ISIP-CART/AutoFollowShoppingCart/firmware/README.md

# 下位机固件目录说明

## 当前推荐烧录

实车 BLE 手动控制与自动跟随统一使用：

`firmware/esp32_at8236_velocity_ble/esp32_at8236_velocity_ble.ino`

这是当前唯一推荐烧录的实车运行固件。它使用 AT8236 `$spd` 的 mm/s 速度闭环，
读取 `$MSPD` 做方向、超速、遥测和制动检查，并兼容 Android 现有
`f / r / h / c / !S` 协议。动态缓弯继续使用 `c<left>,<right>`，不新增协议。
当前 `c14` 仍对应约 240 mm/s；`c15..21` 为后续“速度 + 方向”上位机提供扩展
速度区间，`c21` 的直线/同向差速硬上限为 600 mm/s。反向对转单独限制在
240 mm/s。当前版本还接入 URM09-I²C 与左右 VL53L1X，兼容旧 V1 `s` 最小距离上报，
并按 R3-V1 提供固定左/中/右的 `!R3D` 独立遥测。传感器当前仅采样、回传和诊断，
不参与运动许可或停车。新增高速区间与传感器日志
必须按正式固件 README 和传感器集成测试方案分阶段验证；当前固件不具备防撞保证。

针对实车曾出现的 `DRIVER_ERROR` 永久锁死，本版将短暂 `$MSPD` 中断和制动超时改为
“持续零速、等待新鲜遥测确认四轮静止后恢复到 `READY_STOP`”；不会重放故障前命令。
急停、反馈方向反号、异常超速和启动阶段驱动未就绪仍保持硬锁存。实车 `c14` 曾采集到
约 419--590 mm/s 的 `$MSPD`，且 `c14` 转 `c9` 时内轮曾在新目标 154 mm/s 下短时回报
533 mm/s。因此 1.5 倍目标值只作为告警，稳定后的动态硬阈值提高为 4.0 倍；转弯降速
期间以实际斜坡命令为基准并等待 500 ms 稳定。750 mm/s 绝对硬上限始终有效。`!Q` 会
保留最近一次故障原因、目标/斜坡命令与测速快照，烧录后应看到
`FAULT_RECOVERY,version=3`。

## 其他目录的定位

| 目录 | 定位 | 是否用于当前实车运行 |
|---|---|---|
| `esp32_at8236_velocity_ble/` | 当前速度闭环 BLE 正式固件 | 是，唯一推荐 |
| `esp32_at8236_velocity_validation/` | USB 速度、转向、横移和弧线受控验证 | 否，仅专项验证 |
| `esp32_at8236_openbot_ble/` | 早期低速 BLE 联调固件，包含旧 trim / 起步辅助方案 | 否，历史参考 |
| `esp32_at8236_calibration/` | 四轮/单轮悬空标定 | 否，仅标定 |
| `esp32_at8236_m1_test/` | M1 早期专项测试 | 否，历史测试 |

不要把旧版 `esp32_at8236_openbot_ble` 中的起步 kick、轮间 trim 或
`STARTUP_ASSIST_CURVE` 直接复制到速度闭环固件。只有新的 `$spd/$MSPD` 实测证明
某一速度区间无法可靠起步时，才针对速度闭环重新设计和验证补偿。
