ISIP-CART/AutoFollowShoppingCart/firmware/esp32_at8236_openbot_ble/README.md

# ESP32 + AT8236 OpenBot BLE 安全遥控固件

> **旧版联调固件，请勿作为当前实车推荐烧录版本。** 当前实车 BLE 手动控制与
> 自动跟随统一使用
> `firmware/esp32_at8236_velocity_ble/esp32_at8236_velocity_ble.ino`。
> 本目录保留用于追溯早期低速 trim、起步辅助和换向联调，不应把其中的
> `STARTUP_ASSIST_CURVE`、kick 或轮间 trim 直接复制到速度闭环固件。

这个目录提供一份独立的 Arduino 固件，用于 `ESP32 WROOM-32E + AT8236 + OpenBot BLE` 的低速安全手动遥控。它不启动 WiFi，不包含网页遥控，不接自动跟随输出，也不替换现有台架测试固件。

## 适用范围

- 上位机只走 OpenBot BLE 手动控制
- 下位机只做左右差速控制和安全停车
- 首版速度上限固定为四轮 `[-40,40]`
- `c0,0` 为普通立即停车
- `!S,<seq>` 为锁存急停，BLE 和 USB 均可触发，只能重启解除

## Arduino IDE 设置

- 开发板：`ESP32 Dev Module`
- 串口监视器波特率：`115200`
- Arduino ESP32 core：使用自带 `BLEDevice / BLEServer / BLE2902`
- 不需要额外第三方 BLE 库

当前仓库环境没有 `arduino-cli`，因此请在 Arduino IDE 中完成最终编译与烧录验证。

## 接线

- `ESP32 GPIO17 / TX1 -> AT8236 RX2`
- `ESP32 GPIO16 / RX1 <- AT8236 TX2`
- `ESP32 GND -> AT8236 GND`

AT8236 初始化参数：

- `$mtype:1#`
- `$mphase:30#`
- `$mline:11#`
- `$wdiameter:80.000#`
- `$deadzone:1600#`
- `$upload:1,1,1#`

## BLE 参数

- 设备名：`OpenBot: CART_AT8236`
- Service：`61653dc3-4021-4d1e-ba83-8b4eec61d613`
- RX：`06386c14-86ea-4d71-811c-48f97c58f8c9`
- TX：`9bf1103b-834c-47cf-b149-c9e4bcf778a7`
- RX 属性：`Write + Write Without Response`
- TX 属性：`Notify + BLE2902`

Android 启用 Notify 后应发送 `f\n`。固件每次都返回功能信息，并在 AT8236
遥测就绪时同时发送 `r\n`；若尚未就绪，则在就绪后补发。这样 Android 重试
`f\n` 时可以恢复丢失的就绪通知。

## 正式协议

所有命令都是逐行 ASCII/UTF-8 文本，使用 `\n` 结尾，忽略 `\r`，单行上限 `60` 字节。支持 BLE 拆包、粘包和同包多行命令。

- `c<left>,<right>\n`
  - 输入范围 `[-255,255]`
  - 实际四轮输出钳制到 `[-40,40]`
  - 首个非零命令获得控制权
  - `c0,0` 立即发零速，不走斜坡
- `h<timeout_ms>\n`
  - 允许范围 `100..3000`
  - 默认 `500`
  - 设置当前手动会话的通信和非零 `c` 命令保鲜上限；默认仍为 `500 ms`。例如 USB 落地测试可先发 `h3000`，让一次受控测试命令最多维持 3 秒；BLE 正式遥控应继续每 100 ms 左右刷新 `c`，不要依赖延长超时。
- `f\n`
  - 返回 `fCART_AT8236:\n`
  - 不触发任何电机动作
- `!S,<seq>\n`
  - BLE 和 USB 均可用
  - `seq` 必须为递增正整数
  - 触发锁存 `EMERGENCY_STOP`
- `!Q\n`
  - 仅 USB 可用
  - 输出当前状态诊断，以及最近合法运动命令的计数、来源、左右值、年龄、target/current
- `!D,0\n` / `!D,1\n`
  - 仅 USB 可用，默认关闭
  - 关闭 / 开启 USB 联调诊断日志
  - BLE 来源会被拒绝；该接口不会通过 BLE Notify 输出高频日志

格式错误、越界或缓冲区溢出不会执行截断内容；如果错误来自当前活动控制源，并且车辆正在运动，固件会立即停车。

## USB 联调诊断

在车轮悬空或无电机测试时，先通过 USB 串口监视器发送 `!D,1`。固件会仅在
USB 输出以 `!D,ms=...` 开头的诊断事件；正常 BLE TX Notify 不会增加高频调试帧。

- `motion_rx`：收到的合法 `c` 命令，包含递增 `seq`、来源和原始左右值。
- `motion_target`：该命令映射后的四轮 target。
- `drive_output`：最多每 `100 ms` 输出一次，包含 current、实际发给 AT8236 的
  `$spd` 四轮值、起步助推状态，以及最近一次 AT8236 `$MSPD` 实测速度和帧龄。
- `immediate_stop`、`state`、`ble_disconnect`、`communication_timeout`、
  `motion_timeout`、`driver_timeout`、`error`：安全停车与异常证据。

示例（字段顺序可能随版本扩展）：

```text
!D,ms=15234,event=motion_rx,seq=17,source=BLE,left=-5,right=5
!D,ms=15234,event=motion_target,seq=17,target=-5,-5,5,5
!D,ms=15274,event=drive_output,seq=17,current=-5,-5,5,5,spd=-5,-5,5,5,startup_assist=0,mspd=95.20,95.20,-95.20,-95.20,mspd_age_ms=18
```

用 Android 侧的按钮事件、待写入 `c` 命令、BLE 写成功/失败回调时间，与这里的
`ms`、`seq` 和左右值进行关联：Android 已确认写出但 USB 没有 `motion_rx` 时，优先
检查 BLE 链路；ESP32 已记录 `motion_target` 和 `$spd` 但对应 `$MSPD` 长时间接近 0
时，再检查 AT8236 通道、编码器、电机接线、机械负载和低速死区。完成测试后发送
`!D,0`，避免 USB 日志影响实时控制。

## 安全换向保护

固件会记住最近一次非零四轮目标。新的非零目标只要要求任一轮改变正负号，就会立即向 AT8236 下发四轮零速并进入 `REVERSAL_BLOCKED`；反向目标不会缓存，也不会在后台自动重放。

解除步骤：先松开方向键，使上位机发送 `c0,0`。固件立即下发四轮零速，但不会把这当作物理停车完成：必须收到新鲜 `$MSPD`，确认四轮都低于零速阈值，并从该时刻连续保持 `1000 ms`，才会回到可接受新方向的停止状态。等待期间的非零 `c` 一律保持四轮零速，但不会打断已开始的静止计时，因此 Android 即使持续长按反向键，也会在安全等待完成后的下一条重复帧才开始软启动；同方向的连续更新不会触发此保护。

`!Q`（USB）会输出 `reversal_blocked`、`reversal_neutral_age_ms` 与 `last_nonzero_target`；开启 `!D,1` 后，USB 日志还会记录 `reversal_block`、`reversal_neutral`、`reversal_reject` 和 `reversal_rearmed`。BLE 断连、运动保鲜超时、AT8236 遥测中断和锁存急停仍优先按原有规则停车。

本版本尚未把 `$MSPD` 字段假定为四轮实际速度。收到单轮标定日志、确认字段顺序、符号、单位与刷新周期前，不会启用自动过零换向。

## 控制权规则

- 控制源只有 `OWNER_NONE / OWNER_BLE / OWNER_USB`
- 首个非零 `c` 命令获得控制权
- 其他来源的非零 `c` 被拒绝
- 任意来源的 `c0,0` 都可立即停车并释放控制权
- 任意来源的 `!S` 都应停车；本固件允许 BLE 和 USB 触发锁存急停
- BLE 断连、通信超时或运动命令超过 500 ms 未刷新后，先停车清零，再释放控制权
- 超时释放后，必须收到新的非零命令才能重新运动

## 状态机

- `BOOT_STOP`
  - 上电后的默认状态
  - 未收到有效 AT8236 状态帧前，不允许进入可运动状态
- `READY_STOP`
  - 驱动已就绪，输出保持零
- `MANUAL_ACTIVE`
  - 当前由 BLE 或 USB 持有控制权并输出低速运动
- `REVERSAL_BLOCKED`
  - 任一轮被要求直接反转，或运动中的 `c0,0` 停车时进入，保持四轮零输出
  - 仅在 `$MSPD` 确认四轮静止后连续 `1000 ms`，才回到可接受新方向的停止状态
- `COM_TIMEOUT`
  - 控制命令超时或 BLE 断连后进入，输出保持零
- `EMERGENCY_STOP`
  - BLE 或 USB 锁存急停，需重启解除
- `DRIVER_ERROR`
  - AT8236 状态帧异常锁存，需重启解除

## AT8236 遥测与故障判定

固件启用 `$upload:1,1,1#`，校验以下状态帧的头部、结尾、字段数量和数字格式：

- `$MSPD`
- `$MTEP`
- `$MAll`

判定规则：

- 上电后 `1500 ms` 内未收到有效状态帧，保持 `BOOT_STOP`
- 运动期间若 `1000 ms` 内未收到有效状态帧，进入锁存 `DRIVER_ERROR`

## 轮位与方向

- `M3 = 左前`
- `M4 = 右前`
- `M1 = 左后`
- `M2 = 右后`

前进方向符号：

- `M1 = +1`
- `M2 = -1`
- `M3 = -1`
- `M4 = +1`

当前轮间 trim：

- `M1 = 105%`
- `M2 = 110%`
- `M3 = 110%`
- `M4 = 110%`

2026-07-13 悬空测试中，M2 曾表现为低速起步偏弱，因此早期版本对右侧做过补偿。
但落地直行测试显示该补偿会导致小车明显左转：常规 `c14,14` 输出下右侧 M2/M4
实测速度明显高于左侧 M1/M3，M3 还经常接近 0。随后将左侧补偿调到
`M1=120%, M3=130%` 又导致小车明显右偏。随后中点版 `M1=110%, M2=105%,
M3=115%, M4=95%` 仍有轻微右偏。当前参数继续向左右均衡小步回调，使
`c14,14` 的常规输出接近 `14,-15,-15,14`。该补偿仍受四轮 `[-40,40]`
安全上限约束，后续应以低速落地直线日志继续小步微调。

为降低首次起步偏航，正式固件保留起步助推。直行/后退使用四轮同步助推；
左右同向但速度不同的缓弯命令使用按比例助推，避免助推把差速抹成直行；原地左转/
右转继续使用单独的四轮对称补偿，避免 `c-5,5` / `c5,-5` 悬空正常但落地顶不动。

- 仅在四轮 current 均为 0、收到新的非零 `c` 命令时触发；
- 触发前还要求最近 `$MSPD` 遥测新鲜，且四轮实测速度绝对值均不超过
  `STARTUP_ASSIST_MSPD_ZERO_LIMIT = 80.0`；
- 精确直行/后退持续 `STRAIGHT_STARTUP_ASSIST_MS = 1600 ms`：前
  `STRAIGHT_BREAKAWAY_KICK_MS = 350 ms` 使用四轮对称 `24` 破静摩擦，随后四轮最低
  输出均为 `20`；这条路径保持现有落地直行修复不变。
- 前进缓弯（例如 `c10,14` 或 `c14,10`）同样持续 `1600 ms`，但按照左右目标比例
  施加助推：`c10,14` 在 kick 阶段约为 `17:24`，保持阶段约为 `14:20`，而不会变成
  两侧相同输出。若车辆先以 `c14,14` 起步、助推窗口内才收到缓弯命令，固件会保留
  原助推计时并切换为比例化输出。协议仍然只有 `c<left>,<right>`。
- 原地左转/右转在整个按住期间启用低速转向地板
  `TURN_HOLD_MIN_OUTPUT = 24`，避免助推结束后重新掉回 `±5` 的静摩擦死区；
- 原地左转/右转起步阶段持续 `TURN_STARTUP_ASSIST_MS = 1600 ms`，四轮统一最低绝对值
  `TURN_STARTUP_ASSIST_MIN_OUTPUT = 32`；
- 原地左转/右转刚起步的前 `TURN_BREAKAWAY_KICK_MS = 400 ms` 使用破静摩擦 kick：
  `TURN_BREAKAWAY_KICK_OUTPUT = 40`，因此 `c-5,5` 刚起步预期 `$spd`
  约为 `-40,-40,40,40`，随后约为 `-32,-32,32,32`，助推结束后约为
  `-24,-24,24,24`；`c5,-5` 方向相反；
- 助推仍受四轮 `[-40,40]` 上限约束；停车、超时、BLE 断连、急停或驱动故障会立即清除；
- USB 诊断中 `drive_output` 会显示
  `startup_assist=1,startup_assist_mode=straight|curve|turn`，
  `!Q` 也会显示当前助推状态；
  如果软件 current 已清零但车轮仍在惯性转动，新的非零运动会被拒绝，日志会输出
  `motion_start_blocked`，命令端收到 `!ERR,settling`，避免连续 USB 单发时重复起步导致速度叠加。
- 空闲状态下重复收到 `c0,0` 会作为幂等停车处理，不再每次重复向 AT8236 写入停车帧；
  运动中、换向阻止中或目标/当前非零时，`c0,0` 仍会立即下发停车。

这不是最终闭环同步控制，只是落地联调阶段的开环补偿。若落地后仍明显左转，应小步
降低 M2/M4 或提高 M1/M3；若仍明显右转，则小步降低 M1/M3 或提高 M2/M4。

## 烧录步骤

1. 用 Arduino IDE 打开 `firmware/esp32_at8236_openbot_ble/` 草图目录。
2. 选择 `ESP32 Dev Module` 和正确串口。
3. 编译并烧录。
4. 打开串口监视器，确认看到启动信息。
5. 等待 BLE 广播 `OpenBot: CART_AT8236`。
6. 连接后用 `f\n`、`h500\n`、`c0,0\n` 做无电机安全确认。

## 建议测试顺序

1. 无电机测试：确认广播名、UUID、`f` 回包、分包与多行解析、`!D` 的 USB 权限和
   `!Q` 扩展字段，异常输入保持停车。
2. 车轮悬空测试：先由 USB 发送 `!D,1`，再由 Android BLE 依次验证
   `c14,14`、`c10,14`、`c14,10`、`c0,0`、`c-5,5`、`c5,-5`、`c-12,-12`；确认
   `c14,14` 仍为同步直行，两个缓弯命令的 `$spd` 左右比例相反且不触发换向阻止。每条
   BLE 命令都应有对应的 `motion_rx`、target/current 与 `$spd` 演变记录。
3. 安全测试：BLE 断开、停止发命令、ESP32 重启、AT8236 状态帧中断时都应及时停车。
4. 控制权测试：BLE 与 USB 互不抢占非零控制，但任一来源都能发送 `c0,0` 停车。
5. 落地测试：空载开阔场地、旁边有人可随时物理断电。

## 已知边界

- 本固件不开放麦轮横移、自动跟随、里程计、传感器上传或 WiFi 遥控
- 没有接入物理急停引脚，真实测试必须保留人工断电手段
- `EMERGENCY_STOP` 和 `DRIVER_ERROR` 设计为锁存，BLE 重连不会自动解除
- BLE 急停属于软件安全层，不能替代后续物理急停按钮或人工断电
- USB 诊断默认关闭；开启后只用于悬空或受控联调，完成后应关闭
