ISIP-CART/AutoFollowShoppingCart/design/真实小车BLE与四轮电机联调测试指南.md

# 真实小车 BLE 与四轮电机联调测试指南

> **2026-09-03 自动跟随实验更新**：本篇继续用于手动链路验收。动态 Gallery、自动三档及
> 可选定向搜索请使用 [真实小车动态跟随与定向搜索测试指南](真实小车动态跟随与定向搜索测试指南.md)。
> 不要把旧手动测试步骤直接当作自动搜索验收。

> **2026-09-01 固件基线更新**：当前唯一推荐烧录的实车固件是
> `firmware/esp32_at8236_velocity_ble/esp32_at8236_velocity_ble.ino`。
> 本文后部保留的早期 trim、起步辅助、固定中立等待和
> `esp32_at8236_openbot_ble` 测试记录仅用于历史追溯；若与新固件 README 冲突，
> 以 `firmware/README.md` 和速度闭环 BLE 固件 README 为准。

## 1. 测试目的

本次测试要回答三个问题：

1. 手机是否按正确顺序发送了新方向命令？
2. ESP32 是否按相同顺序收到并输出了命令？
3. 四个电机是否能在相同命令下可靠起步、停止和反转？

测试期间只使用手动模式。**不要开启自动跟随。**

## 2. 安全要求

- 第一轮测试必须让四个车轮完全悬空。
- 小车周围不要放手、衣服、线缆或其他容易卷入车轮的物品。
- 旁边必须有人可以立即切断电机电源。
- 先确认 `c0,0` 或 USB 停车命令有效，再测试非零速度。
- 出现异常响声、剧烈抖动、失控转动或电机过热时，立即断电。
- 四轮悬空测试全部通过前，不允许落地测试。

## 3. 当前软件版本

截至 2026-09-01：

- 当前速度闭环 BLE 固件已加入 USB 诊断、`$MSPD` 反馈保护、主动制动和换向等待。
- 四轮 USB 标定固件位于：
  `firmware/esp32_at8236_calibration/esp32_at8236_calibration.ino`
- 正式 BLE 固件位于：
  `firmware/esp32_at8236_velocity_ble/esp32_at8236_velocity_ble.ino`
- `firmware/esp32_at8236_openbot_ble/` 已降级为早期联调历史版本。
- Android Debug APK：
  `dev/OpenBot/android/robot/build/outputs/apk/debug/robot-debug.apk`

两个 ESP32 固件不能同时使用。完成四轮标定后，必须重新烧录正式 BLE 固件，才能连接手机。

### 当前已经完成

- 正式 BLE 固件可以记录 Android 命令、四轮 target/current、`$spd` 和 `$MSPD`。
- 独立标定固件可以逐个测试 M1-M4，并输出原始 AT8236 遥测。
- 正式 BLE 固件可以阻止目标值直接反转，进入 `BRAKING` 后等待四轮 `$MSPD`
  连续 400 ms 低于 30 mm/s，再接收新的运动刷新。
- Android 可以记录触摸、pointer、generation、BLE 队列和 GATT 写入结果。
- 速度闭环实车测试已确认 `$MSPD` 字段顺序、速度符号、四轮映射和主动制动有效。

### 当前还没有完成

- 动态缓弯 `c10,14`、`c14,10` 及中间档位仍需完成成对的悬空 `$MSPD` 验收。
- BLE 断连、500 ms 运动保鲜、750 ms 链路超时和 `!S` 锁存急停仍需按新固件
  README 留存一组正式验收日志。
- 阶段 N 载物测试继续暂停；动态缓弯和通信安全验收通过后再决定是否恢复。

## 4. 测试工具

准备以下工具：

- 装有新版 OpenBot APK 的 Android 手机；
- USB 数据线；
- Arduino IDE 串口监视器，波特率 `115200`；
- 能运行 `adb` 的电脑终端；
- 用于记录结果的表格或文本文件；
- 可立即断开电机电源的人员或开关。

串口监视器发送命令时选择“新行”或确保命令末尾带换行。

---

## 5. 第一阶段：四轮单独标定

### 5.1 烧录标定固件

烧录：

```text
firmware/esp32_at8236_calibration/esp32_at8236_calibration.ino
```

该固件不启动 WiFi 和 BLE，只能通过 USB 测试。

烧录后：

1. 打开串口监视器，设置为 `115200`。
2. 确认四个车轮完全悬空。
3. 确认串口中持续出现 AT8236 遥测，或发送 `!Q` 查看状态。

### 5.2 保存静止遥测

发送：

```text
!U,50
```

保存至少 5 秒日志。正常情况下会看到 `$MSPD`、`$MTEP` 或 `$MAll` 帧。

如果没有遥测，不要继续测试电机。先检查：

- ESP32 GPIO17 是否连接 AT8236 RX2；
- ESP32 GPIO16 是否连接 AT8236 TX2；
- 两块板是否共地；
- 串口波特率是否为 `115200`。

### 5.3 解锁测试

发送：

```text
!A,RAISED
```

发送过 `!S,1000` 后，后续 `!T` 的序号必须大于 `1000`。

看到下面的回复才能继续：

```text
!OK,A
```

解锁有效期为 60 秒。超时后需要重新发送 `!A,RAISED`。

### 5.4 单电机测试命令

命令格式：

```text
!T,序号,电机编号,速度,持续时间毫秒
```

示例：让 M1 以速度 3 正转 500 ms：

```text
!T,1,1,3,500
```

让 M1 以速度 3 反转 500 ms：

```text
!T,2,1,-3,500
```

注意：

- 序号必须一直递增，不能重复。
- 电机编号只能是 `1、2、3、4`。
- 速度范围为 `-40..40`，不能为 0。
- 持续时间为 `100..1500 ms`。
- 每次只允许一个电机转动。
- 每次测试结束后至少等待 1 秒。

### 5.5 推荐测试顺序

对 M1、M2、M3、M4 分别测试以下速度：

```text
正转：3、5、8、12、14、20
反转：-3、-5、-8、-12、-14、-20
```

每次建议持续 `500 ms`。例如 M1 的前几条命令：

```text
!T,1,1,3,500
!T,2,1,-3,500
!T,3,1,5,500
!T,4,1,-5,500
```

后续命令继续增加序号。

每次记录：

| 电机 | 方向 | 命令速度 | 是否每次都能起转 | 起转是否明显延迟 | 停止是否拖延 | `$MSPD` 对应字段 |
|---|---|---:|---|---|---|---|
| M1 | 正转 | 3 |  |  |  |  |
| M1 | 反转 | -3 |  |  |  |  |

最低可靠速度是“连续多次都能正常起转”的最小速度，不是偶尔转动一次的速度。

### 5.6 紧急停车

需要立即停止时发送递增序号：

```text
!S,1000
```

该命令会停止四轮并取消解锁。再次测试前需要重新发送：

```text
!A,RAISED
```

### 5.7 第一阶段通过条件

第一阶段完成后，应得到：

- M1-M4 的正转最低可靠速度；
- M1-M4 的反转最低可靠速度；
- `$MSPD` 四个字段分别对应哪个电机；
- `$MSPD` 正负号是否与真实转向一致；
- 哪个问题跟随电机，哪个问题固定在 AT8236 通道。

如果某个问题很明显，可以交换电机与 AT8236 通道后重复测试：

- 问题跟着电机移动：优先检查电机、编码器和减速箱。
- 问题固定在通道：优先检查 AT8236 通道、接线和参数。

### 5.8 2026-07-13 悬空标定结果摘要

本节记录 2026-07-13 使用 USB 标定固件完成的 M1-M4 单轮测试、M2 低速复测，以及 M1/M2 电机互换后的归因测试。该结论仅适用于车轮悬空状态，落地负载下仍需重新确认最低可靠速度。

#### 5.8.1 AT8236 遥测字段

实测确认 `$MSPD`、`$MTEP`、`$MAll` 的四个字段顺序与 AT8236 通道一致：

| 通道 | `$MSPD` 字段 | 备注 |
|---|---:|---|
| M1 | 第 1 字段 | 单轮测试时仅第 1 字段变化 |
| M2 | 第 2 字段 | 单轮测试时仅第 2 字段变化 |
| M3 | 第 3 字段 | 单轮测试时仅第 3 字段变化 |
| M4 | 第 4 字段 | 单轮测试时仅第 4 字段变化 |

单轮测试期间未观察到明显串通道：被测通道以外的 `$MSPD` 字段保持为 0。

#### 5.8.2 速度符号

在当前接线和 AT8236 参数下，`$MSPD` 速度符号与标定固件发送的 `$spd` 命令符号相反：

```text
!T,...,speed=正数  -> 对应 $MSPD 字段多为负数
!T,...,speed=负数  -> 对应 $MSPD 字段多为正数
```

后续如果实现基于 `$MSPD` 的实际速度过零联锁，不能直接把 `$MSPD` 正负号等同于 `$spd` 命令正负号，必须保留这一反号关系。

#### 5.8.3 低速起步与停止尾速

悬空测试表明，底盘问题主要不是 BLE 命令丢失或 Android 旧按键残留，而是四轮实际机械/闭环响应不同步：

- `speed=5` 附近属于低速边界，M2 曾出现一次 `speed=5` 无明显响应，复测后又能起转，说明低速可靠性不足。
- M2 复测中，`speed=5/8/12` 与 `speed=-5/-8` 均能起转，但一次 `speed=5` 曾出现实测速度符号异常，倾向于低速边界、停止残余或闭环抖动造成的偶发现象。
- M1/M2 电机互换后，M1 通道和 M2 通道在 `speed=5/8` 均能起转，没有稳定复现“问题跟随某个电机”或“问题固定在第 2 通道”的证据。
- M1/M2 互换测试中，停止后 `$MSPD` 非零尾速约持续 `1.3..1.7 s`；因此 1 秒中立等待可能不足以覆盖最慢停稳情况。
- 正式 BLE 固件悬空测试中，USB 单发 `c14,14` 时 `spd=14,-14,-14,14`，四轮 `$MSPD` 均有响应；但 M2 峰值约 `304.64`，低于 M1/M3/M4 的约 `418.88..476.00`。这说明“右侧完全不动”不是 ESP32 漏发命令，而是 M2 右后轮/通道响应偏弱叠加 500 ms 单发超时造成的观感差异。

M1/M2 互换后的关键数据如下：

| 测试命令 | 当前通道 | 峰值 `$MSPD` | 首次检测到运动 | 停止后最后非零 |
|---|---:|---:|---:|---:|
| `!T,301,1,5,800` | M1 | `-1142.40` | 约 128 ms | 约 1310 ms |
| `!T,302,1,8,800` | M1 | `-1237.60` | 约 547 ms | 约 1728 ms |
| `!T,303,2,5,800` | M2 | `-875.84` | 约 255 ms | 约 1435 ms |
| `!T,304,2,8,800` | M2 | `-1351.84` | 约 346 ms | 约 1527 ms |

#### 5.8.4 当前归因

当前证据支持以下判断：

- 不是 BLE 链路本身导致四轮不同步；问题在 USB 单轮标定固件下也能观察到。
- 不是 Android 按键仲裁的主因；标定过程没有经过 Android。
- 暂不能判定某一个电机或某一个 AT8236 通道已经损坏；M1/M2 互换后两边均可起转。
- 更可能的主因是低速短脉冲下的电机、编码器、减速箱、AT8236 闭环响应和停止惯性综合差异。
- 正式 BLE 固件已先对 M2 增加一阶 trim：`M2_TRIM_PERCENT=130`。该补偿把协议目标 `-14` 的实际 `$spd` 输出提高到约 `-18`，仍受四轮 `[-40,40]` 上限约束。该值是悬空首轮补偿，不是最终落地参数。
- 2026-07-13 后续 USB 复测还显示：右侧 M2/M4 在第一次 `c14,14` 的前 `500 ms` 起步偏慢，但连续多次发送后四轮 `$MSPD` 可逐渐接近。这更像低速起步死区/静摩擦问题，而不是 BLE 没收到新指令。程序可以用“停车到运动时短时提高最低输出”的方式缓解，但它仍是开环补偿，不等价于四轮速度闭环同步。
- 2026-07-13 落地转向测试补充显示：`c-5,5`、`c5,-5` 悬空可正常转，落地后无法顺畅起步。因此正式固件将起步助推拆为两类：直行/后退继续使用落地直行中点版四轮独立最低值；原地左/右转使用单独的低力度四轮对称助推，避免重引入左右偏置。
- 2026-07-13 落地直行测试又显示：沿用悬空右侧补偿后，小车明显左转；日志中右侧 M2/M4 实测速度明显高于左侧 M1/M3，且 M3 在部分片段接近 0。随后首版落地补偿 `M1=120%`、`M2=90%`、`M3=130%`、`M4=80%` 又导致小车明显右偏；中点版 `M1=110%`、`M2=105%`、`M3=115%`、`M4=95%` 仍有轻微右偏。因此正式固件参数已继续小步回调为 `M1=105%`、`M2=110%`、`M3=110%`、`M4=100%`，使 `c14,14` 输出更接近左右均衡。

#### 5.8.5 对正式 BLE 固件和测试的影响

在完成基于 `$MSPD` 的实际速度过零联锁前，正式 BLE 联调应遵守：

- 不使用 `5` 作为正式可控运动速度；悬空联调优先从 `12` 或 `14` 开始。
- 复测 `c14,14` 时重点观察 `drive_output` 中 `spd=`、`startup_assist=` 与 `mspd=`：
  - 起步助推触发期间应看到 `startup_assist=1`；
  - 首个软启动台阶可能类似 `current=6,-6,-6,6,spd=14,-15,-15,14`；
  - 达到目标但助推仍在窗口内时可能类似 `current=14,-14,-14,14,spd=14,-15,-15,14`；
  - 助推结束或连续 BLE 运动稳定后，也应接近 `spd=14,-15,-15,14`。
- 测试 `c-5,5`、`c5,-5` 等原地转向时，若四轮 `$MSPD` 已确认静止，应看到
  `startup_assist=1,startup_assist_mode=turn`。起步窗口为 `TURN_STARTUP_ASSIST_MS = 1600 ms`。
  刚起步前 `TURN_BREAKAWAY_KICK_MS = 400 ms` 应看到 `turn_kick=1`，四轮对称破静摩擦
  输出 `TURN_BREAKAWAY_KICK_OUTPUT = 40`，因此 `c-5,5` 预期 `$spd`
  约为 `-40,-40,40,40`，`c5,-5` 约为 `40,40,-40,-40`。kick 结束后助推阶段
  维持 `TURN_STARTUP_ASSIST_MIN_OUTPUT = 32`；起步窗口结束后，纯原地转向仍应看到
  `turn_floor=1`，并保持 `TURN_HOLD_MIN_OUTPUT = 24` 左右的最低输出，避免重新掉回
  `±5` 的落地静摩擦死区。
  不应出现 `spd=-5,-24,5,22` 或 `spd=5,24,-5,-22` 这类右侧单边助推输出。
- 起步助推和停车后重新起步都必须以 `$MSPD` 实测静止为前提。若 USB 单发 `c14,14` 超时后车轮仍有尾速，再次单发 `c14,14` 时应看到 `motion_start_blocked` 和 `!ERR,settling`，这是为了避免“软件 current 已清零、实际轮子仍在转”时继续叠加运动输出。
- 保留 `REVERSAL_BLOCKED`，禁止前进/后退、左转/右转等直接反向切换。
- 如果继续使用固定中立等待，建议下一版从 `1000 ms` 提高到 `1800..2000 ms` 后再悬空验证。
- 更推荐的正式方案是：收到反向目标后先四轮零速，进入等待状态；只有连续若干帧 `$MSPD` 四字段均低于零速阈值后，才允许从零执行新方向。
- 落地测试前必须先完成悬空状态下的“运动、松手、等待停稳、反向”验收。

---

## 6. 第二阶段：手机 BLE 命令链测试

### 6.1 烧回正式 BLE 固件

烧录：

```text
firmware/esp32_at8236_velocity_ble/esp32_at8236_velocity_ble.ino
```

烧录后重新启动 ESP32。确认手机能够连接：

```text
OpenBot: CART_AT8236
```

OpenBot 页面应显示 BLE 和固件已经就绪。

### 6.2 开启两侧日志

ESP32 USB 串口发送：

```text
!D,1
```

Android 页面打开“记录日志”开关。

电脑运行：

```powershell
adb logcat -c
adb logcat -s CartControl:I
```

ESP32 串口应能看到：

```text
motion_rx
motion_target
drive_output
```

开启新版 USB 诊断后，`drive_output` 中还应包含 `startup_assist=`、`startup_assist_mode=`、`mspd=` 和 `mspd_age_ms=`。其中 `spd=` 是 ESP32 发给 AT8236 的目标输出，`startup_assist=1,startup_assist_mode=straight` 表示直行/后退起步助推正在生效，`startup_assist=1,startup_assist_mode=turn` 表示原地转向低力度对称助推正在生效，`mspd=` 是 AT8236 最近一次上报的四轮实测速度。若 `spd=` 四轮有值但某一侧 `mspd=` 长时间接近 0，应优先检查该侧通道、电机、编码器、接线、机械负载或低速死区，而不是继续修改 Android 队列。

Android 终端应能看到：

```text
touch_down
queue_enqueue
queue_dispatch
gatt_success
```

### 6.3 基本方向测试

保持车轮悬空，分别短按：

1. 前进；
2. 松手；
3. 后退；
4. 松手；
5. 原地左转；
6. 松手；
7. 原地右转；
8. 松手。

每次松手后都应看到：

```text
c0,0
```

如果松手后仍有非零命令，立即断电并停止测试。

注意：通过 USB 串口监视器单发一次 `c14,14` 只能维持约 500 ms，随后正式固件会触发运动保鲜超时并停车。这适合验证解析、映射和急停，不适合判断慢启动电机是否能连续运行。需要判断四轮实际响应时，应使用 Android/BLE 的 100 ms 重发，或在日志中重点查看同一次 `drive_output` 的 `spd=` 与 `mspd=` 对齐关系。

落地直行补偿版固件的悬空/低速复测步骤：

1. USB 串口发送 `!D,1`；
2. 发送 `!Q`，确认 `state=READY_STOP`、`startup_assist=0`；
3. 单发 `c14,14`；
4. 在 `drive_output` 中确认起步窗口内出现 `startup_assist=1`，并且四轮 `$spd` 符合落地直行小步均衡补偿，例如 `spd=14,-15,-15,14`；
5. 等待 `communication_timeout` 后，不要立刻重复发送；先继续观察 `$MSPD` 直到四轮回到接近 0；
6. 若在尾速未归零时重复发送 `c14,14`，应看到 `motion_start_blocked` 和 `!ERR,settling`，并且不应进入新的 `MANUAL_ACTIVE` 运动输出；
7. 观察同一批日志的 `mspd=` 和肉眼轨迹：若仍明显左转，优先继续降低 M2/M4 或提高 M1/M3；若明显右转，则反向微调。不要在直行未收敛前进入落地连续换向。

落地原地转向起步复测步骤：

1. USB 串口发送 `!D,1`；
2. 发送 `!Q`，确认 `state=READY_STOP`、`startup_assist=0`；
3. 临时发送 `h1500`，避免 USB 单发在默认 `500 ms` 处过早停车；
4. 单发 `c-5,5`，确认日志出现 `startup_assist,mode=turn,duration_ms=1600,kick_ms=400,kick_output=40,turn_start_min=32,turn_hold_min=24`；
5. 在最早的 `drive_output` 中确认出现 `turn_floor=1,startup_assist=1,startup_assist_mode=turn,turn_kick=1`，且 `spd=` 约为 `-40,-40,40,40`；
6. 继续观察 kick 后的 `drive_output`，应看到 `turn_kick=0` 且 `spd=` 约为 `-32,-32,32,32`；
7. 等待 `communication_timeout` 和四轮 `$MSPD` 回到接近 0；
8. 单发 `c5,-5`，确认最早 `spd=` 约为 `40,40,-40,-40`；
9. 测完 USB 后发送 `h500` 恢复默认保鲜超时，再进入 Android/BLE 长按测试；
10. 若 USB 下 `±40` 仍然完全没有 `$MSPD` 响应或车体不动，应停止继续加软件输出，优先检查电池电压、电机供电限流、AT8236 电流保护、轮子落地阻力、麦轮接触方向和机械卡滞；若 USB 可转而 BLE 不转，再回到 Android/BLE 命令刷新链路排查。

### 6.4 按钮切换测试

依次测试：

1. 松开“前进”后按“左转”；
2. 按住“前进”，用第二根手指按“左转”；
3. 单指从“前进”滑到“左转”；
4. 新方向生效后，再松开旧手指；
5. 左转切右转；
6. 前进切后退。

Android 中一次换向应按顺序出现：

```text
touch
queue_transition
queue_dispatch STOP
gatt_success c0,0
queue_dispatch 新方向
gatt_success 新方向
```

ESP32 中应按相同顺序出现：

```text
motion_rx c0,0
motion_rx 新方向
```

如果 Android 顺序正确、ESP32 顺序错误，检查 BLE 链路。

如果 ESP32 顺序正确、四个电机动作错误，进入电机和 AT8236 排查，不再修改 Android 按钮逻辑。

---

## 7. 安全换向保护测试

正式固件不会允许车轮直接反转。

例如先按前进，再按后退时，第一次反向命令应触发：

```text
REVERSAL_BLOCKED
```

此时四轮应立即保持零速。固件不会在后台自动继续后退。

正确操作步骤：

1. 松开当前方向按钮，使 Android 发送 `c0,0`；
2. 固件立即向 AT8236 下发四轮零速，并等待新鲜 `$MSPD` 确认四轮速度都落在 `±80` 内；
3. 从确认静止开始连续等待 `1000 ms`；若轮子再次转动，计时重新开始；
4. 等待期间即使用户已经长按目标方向，BLE 重复帧也只会被拒绝而不会重新开始计时；出现 `reversal_rearmed` 后，下一条重复帧自动从零速启动目标方向。

USB 日志应依次看到：

```text
reversal_block
reversal_neutral
reversal_rearmed
```

如果等待期间又收到非零命令，会看到：

```text
reversal_reject,neutral_age_ms=...
```

这说明命令被安全拦截；只要 `$MSPD` 继续保持静止，`neutral_age_ms` 应持续增大，不能被 Android 长按的重复帧重置。

可以发送以下命令查看状态：

```text
!Q
```

重点检查：

```text
reversal_blocked
reversal_neutral_age_ms
last_nonzero_target
```

### 安全换向通过条件

- 触发反向时四轮都先停车；
- 等待期间没有任何车轮提前反转；
- 中立等待结束前不能执行新方向；
- 中立等待结束后，持续长按产生的下一条重复帧可以启动；若已经松手，则必须重新按键；
- BLE 断开、急停或遥测中断时仍保持停车。

### 7.1 2026-07-13 BLE 长按换向验收结果

本次使用 `!D,1` 采集了前进、后退与原地转向的多轮 BLE 长按日志，结论如下：

- BLE 按住期间约每 `90..120 ms` 收到一条相同的 `c` 命令，属于 Android 的正常保鲜刷新，不是旧按键残留；
- 前进运行时四轮 `$MSPD` 能升至约 `1200..1400`，松开后先出现 `immediate_stop` 和 `REVERSAL_BLOCKED`，未观察到反向 `$spd` 提前下发；
- 停止尾速进入 `±80` 后，日志出现 `reversal_neutral,started=1`；随后 `neutral_age_ms` 连续增长至 `1000 ms`，出现 `reversal_rearmed`；
- 用户持续长按后退或转向期间，重臂前的帧保持 `reversal_reject`，重臂后的下一条 BLE 重复帧才进入 `MANUAL_ACTIVE` 并输出目标方向；
- 日志中未出现 `communication_timeout`、`motion_timeout` 或 `driver_timeout`，本轮换向保护链路通过悬空/低速 BLE 验收。

本轮修复的根因是：早期实现会在每一条被拒绝的反向 BLE 重复帧到达时清零中立计时，使 Android 长按永远无法离开 `REVERSAL_BLOCKED`。现已改为“拒绝命令但不打断已开始的实测静止计时”。

### 7.2 首版自动跟随测试

自动模式目前只允许下面四种命令：

```text
c14,14
c12,14
c14,12
c0,0
```

该列表属于早期直线／缓弯阶段口径；当前持续对准和定向搜索还可能输出低速
`c-5,5`／`c5,-5`。三路传感器已经接入固件，但首次联调仍必须有人随时准备物理断电，
并按以下顺序测试。

#### 第一步：车轮悬空

1. 连接 BLE，确认页面显示 `CART_AT8236` 已就绪；
2. 切换到“自动实验”，长按解锁 2 秒；
3. 打开 Start，完成目标采集、确认和倒计时；
4. 倒计时结束前，ESP32 不应收到非零 `c` 命令；
5. 目标居中并后退到标定距离之外，连续稳定后应收到 `c14,14`；
6. 人物缓慢向画面一侧移动，车辆已经前进时只允许切换为 `c12,14` 或 `c14,12`；
7. 人物偏移过大、走近、遮挡或离开画面时，应收到 `c0,0`；
8. 整个过程不应出现 `c-5,5`、`c5,-5` 或任意负轮速。

页面自动状态含义：

| 状态 | 含义 |
|---|---|
| `LOCKED` | 自动未解锁或已超时退出 |
| `WAIT_TARGET` | 当前身份、距离或行为不允许运动 |
| `WAIT_CENTER` | 等待目标居中并满足三帧起步条件 |
| `MOVING_STRAIGHT` | 输出 `c14,14` |
| `CURVE_LEFT / CURVE_RIGHT` | 输出同向差速缓弯 |
| `RECOVERY_STOP` | 目标异常，静止重捕中 |

#### 第二步：停车与失效保护

分别验证以下操作都会立即进入 `c0,0`：

- 关闭 Start；
- 切回手动模式；
- 按急停；
- 返回其他页面或让 App 进入后台；
- 断开 BLE；
- 遮住摄像头或让推理停止更新；
- 目标丢失或身份变得不确定。

目标丢失后最多允许 2 秒静止重捕。超过 2 秒，Start 应关闭，自动解锁应失效；再次测试
必须重新长按解锁，并重新采集、确认目标。

#### 第三步：空旷落地

1. 只测试人物沿直线缓慢远离，确认车辆能持续直行并在达到距离后停车；
2. 直行通过后，人物再缓慢向左右移动，测试大半径缓弯；
3. 缓弯期间 Android/ESP32 日志中不应插入不必要的 `c0,0`，也不应触发
   `REVERSAL_BLOCKED`；
4. 人物不要突然横穿、急转弯或进入货架拐角；
5. 任一车轮异常、轨迹明显失控或停车延迟不可接受时，立即物理断电。

开启“记录日志”后，可用下面的命令查看自动决策：

```powershell
adb logcat -c
adb logcat -s CartControl:I
```

重点查找 `event=auto_decision`，核对 `phase`、`height_scale`、`filtered_turn`、`output` 和
`reason`。

### 7.3 手动直行速度滑条标定

最新速度固件仍使用 `c<left>,<right>` 协议。`c` 的绝对值既表示速度也保留方向的
正负号，Android 手动页面的“直行速度”滑条直接选择前进逻辑量 `9..21`：

| 滑条前进档位 | 预计四轮目标速度 | 后退命令（安全比例） |
|---:|---:|---:|
| `c9,9` | 约 `154 mm/s` | `c-8,-8` |
| `c14,14` | 约 `240 mm/s` | `c-12,-12` |
| `c16,16` | 约 `343 mm/s` | `c-14,-14` |
| `c18,18` | 约 `446 mm/s` | `c-15,-15` |
| `c20,20` | 约 `549 mm/s` | `c-17,-17` |
| `c21,21` | `600 mm/s` | `c-18,-18` |

左右原地转向仍固定为 `c-5,5 / c5,-5`，不受该滑条影响。首次安装默认值是 `c14`；
滑条在按住前进或后退时也可调整，新命令会在下一次约 100 ms 的 Android 保鲜周期发送，
不应额外发送 `c0,0`。

按如下顺序测试，任何一档失败都退回前一档，不进入下一档：

1. 四轮悬空，开启 ESP32 `!D,1` 诊断，依次按住前进 `c9`、`c14`、`c18`、`c21` 各 1 秒；
   每档松开后必须出现 `brake_start` 和 `brake_settled`。
2. 对通过悬空测试的档位，空旷地面只测试前进 `0.5 秒` 后松开；记录 1 秒位移、停车距离、
   最大左右偏移和四轮 `$MSPD`。
3. 只有前一档直线性、制动和温升都可接受时，才允许进入更高一档；不得首次落地直接使用
   `c18` 或 `c21`。
4. 每个通过的前进档位再测试对应后退档位，距离减半、周围保持无障碍；倒车异常时不提高
   后退比例。
5. 按住前进 `c14` 时从滑条逐步调至 `c18`，检查 Android `CartControl` 日志只出现同方向
   `c14,14 -> c15,15 ... -> c18,18`，中间不得出现 `c0,0`。

当前 BLE 协议能够表达前后方向和差速转向，但不能表达麦轮横移。本阶段已确认不增加侧移；
只有 V2 三轴协议完成冻结并在固件实现后，才能重新安排手动侧移验证。

---

## 8. 日志对齐方法

选择一次“前进切左转”事件，按时间顺序对齐：

```text
Android touch
-> Android queue_dispatch
-> Android gatt_success
-> ESP32 motion_rx
-> ESP32 motion_target
-> ESP32 drive_output
-> 实际车轮动作
```

正式 BLE 固件当前不会把原始 `$MSPD` 输出到 USB，因此本阶段只能对齐到 `$spd` 和
实际车轮动作。`$MSPD` 字段与电机的对应关系应在第一阶段使用标定固件确认，不要在
正式遥控时混用两个固件。

判断方法：

| 现象 | 优先检查 |
|---|---|
| Android 没有新方向日志 | Android 触摸路由 |
| Android 有 dispatch，但没有 success | BLE GATT 写入 |
| Android success，但 ESP32 没有 motion_rx | BLE 传输或固件接收 |
| ESP32 motion_rx 正确，但 target 错误 | ESP32 四轮映射 |
| target 和 `$spd` 正确，但实际轮子异常 | 对照第一阶段 `$MSPD`，检查 AT8236、编码器、电机和机械负载 |

## 9. 立即停止测试的情况

出现以下任意情况时立即停车并断开电机电源：

- 松手后仍持续收到或执行非零命令；
- BLE 断开后车轮不停；
- `REVERSAL_BLOCKED` 状态下仍有车轮反转；
- 四轮出现互相对抗的方向；
- AT8236 遥测中断但电机继续转动；
- 电机、驱动板或线缆明显发热；
- 出现异常噪声、卡死或剧烈抖动。

## 10. 测试完成后需要保存的材料

- Android `CartControl` 日志；
- ESP32 USB 完整日志；
- M1-M4 正反转最低可靠速度表；
- `$MSPD` 字段与电机对应关系；
- 问题是否随电机或 AT8236 通道移动；
- 每个失败步骤的现象和发生时间；
- 当前烧录的是标定固件还是正式 BLE 固件。

关闭 ESP32 诊断：

```text
!D,0
```

测试结束后关闭 Android“记录日志”开关，并断开电机电源。

## 11. 拍照确认与 BLE 重连专项测试

### 11.1 拍照确认

1. 车轮保持悬空，连接 BLE，确认页面显示“BLE 已就绪”；
2. 切换自动模式，长按解锁，再打开 Start；
3. 人站在镜头前，等待 App 完成 15 帧采集并显示确认照片；
4. 在确认页面停留至少 10 秒，Start 不应自动关闭；
5. 点击“确认”，页面应进入重新识别和倒计时，确认窗口应立即消失；
6. 点击“重拍”时应返回采集状态；点击“取消”时应关闭 Start 并隐藏确认窗口；
7. 确认阶段车辆必须始终保持 `c0,0`。

400 ms 推理 watchdog 现在只保护车辆已经收到非零自动命令的运动阶段。采集、确认、
重新识别、倒计时和等待居中阶段都是静止状态，不会因为用户等待而自动结束。

### 11.2 BLE 重连

连续执行 10 次：

1. 在 BLE 页面点击 `OpenBot: CART_AT8236`；
2. 观察状态依次变为“连接中”“初始化串口”“断开”；
3. 返回真实小车页面，确认显示“BLE 已就绪 · CART_AT8236”；
4. 返回 BLE 页面点击“断开”，再重新连接；
5. 整个过程不要关闭或重启 OpenBot。

首次连接或 Notify 初始化失败时，App 会显示“自动重试”，并只自动重试一次。第二次
仍失败时显示“连接失败”，此时再次点击设备即可从已经清理的 BLE 栈重新连接，不应再
要求杀掉 App。

BLE 连接生命周期日志默认可见：

```powershell
adb logcat -c
adb logcat -s Bluetooth_Connection:I
```

重点观察 `connect_start`、`gatt_connected`、`serial_ready`、`connection_failure`、
`disconnected` 和 `disconnect_timeout`。控制命令和写队列细节仍需在真实小车页面打开
“记录日志”后使用 `adb logcat -s CartControl:I` 查看。

## 12. 自动重捕与缓弯专项测试

本节全部先在车轮悬空状态执行。

### 12.1 检查画面是否仍在工作

1. 完成自动解锁、目标采集、确认和倒计时；
2. 人物保持在画面中，短暂侧身或遮挡衣服，使身份置信度下降；
3. 页面应显示“身份确认中，停车重捕”，轮速应为 `0,0`；
4. 保持超过 10 秒，Start 仍应开启，检测框仍应随人物移动；
5. 人物完全离开画面，连续 2 秒后 Start 才应关闭；
6. Start 关闭后画面不能残留静止绿框，状态栏应显示 `last_end=target_missing_timeout`。

### 12.2 检查从静止开始缓弯

每个方向都重新启动一次自动会话：

1. 人物站在足够远的位置，并稳定处于画面中心，确认输出 `14,14`；
2. 人物稳定站在画面左侧但不要贴近边缘，连续 3 帧后应显示“小车左缓弯”，输出 `12,14`；
3. 人物稳定站在画面右侧，同理应显示“小车右缓弯”，输出 `14,12`；
4. 人物继续移动到画面边缘，页面应显示“目标偏差过大，停车等待”，输出 `0,0`；
5. 整个过程不应出现负轮速、倒车或原地旋转。

会话日志无需打开“记录日志”开关：

```powershell
adb logcat -c
adb logcat -s CartFollow_Session:I
```

需要核对每一帧的视觉建议、真实阶段和轮速时，再打开“记录日志”并运行：

```powershell
adb logcat -s CartControl:I
```

## 13. Android 测距仅记录与固件拒绝诊断

本节适用于能力回复为 `fCART_AT8236:s:` 的传感器版固件。Android 只能看到三路有效读数的
最小值，页面上的 `source unknown` 属于协议边界，不代表传感器安装方向未知。

1. 电机断电，连接 BLE；状态区应显示 `V1+s`，并在约 100 ms 周期更新最小距离和 age。
2. 分别移动左、中央、右前方目标，页面最小值应随最近的有效目标变化；独立三路真值同时用
   ESP32 USB `!D,1`／`!Q` 核对。
3. 停止 Notify 或断开所有测距模块。250 ms 后 Android 必须显示数据过期，但手动、自动跟随和
   定向搜索的 Android 请求值不得被改成 `c0,0`；状态区应明确显示 `observation_only`。
4. 当前 ESP32 仍可能返回 `!ERR,sensor_*` 并拒绝对应方向。必须区分“Android 已请求”“GATT
   写入成功”和“ESP32 拒绝”，不得把写入成功当作车轮执行成功。
5. `c0,0`、急停、断连、心跳超时和驱动故障保护在任何测距状态下仍必须生效。下位机同步关闭
   传感器门控前，按 [ESP32 传感器仅日志模式修改说明](ESP32传感器仅日志模式修改说明.md) 验收。
6. 在遥控模式直接打开“记录日志”，依次测试前进、后退、左右转、方向替换和释放。关闭日志并
   导出 ZIP，确认包含 `control_log.csv` 与 `range_log.csv`；前者包含 `control_mode`、请求和
   GATT 结果，后者包含每个新 `s<cm>` 序列、最小值、age、fresh、请求轮速和固件错误。

最新固件 `c14≈240 mm/s`、`c21≈600 mm/s`。自动页面虽保留 `c21` 选项和默认值，首次传感器
落地验收仍必须从低档开始，按固件 README 逐档升级；不得直接在人群或货架旁验证 600 mm/s。

## 2026-09-05 转向振荡与 BLE 自动重扫回归

本节更新旧版“持续旋转等三帧居中”的预期。新版日志 strategy 为 observed-aim-pulse-v5，实车
real_prediction_horizon_ms=0；不以通用 v0.8.0 版本号判断 APK 是否更新，应核对 build_stamp。

1. 先悬空检查方向和停车，再空旷低档落地。开启日志，目标先直行，再缓慢斜向右前／左前移动。
   距离允许且实测中心误差小于 0.60 时应保持双轮正向差速，不应持续左右原地反打。
2. 目标站在标定距离附近向侧方移动。车允许短时对准，但不前进；接近中心立即停车观察，
   界面显示“对准停车观察”。不要把 650 ms 的观察停顿误判为距离模块拒绝运动。
3. 目标接近画面边缘，检查先停车再 c5 脉冲；每次脉冲最多 300 ms（发送检查约 100 ms 周期），
   随后至少观察 650 ms。暂停推理时不得无限续发旋转；原有旧帧、身份和急停安全检查仍有效。
4. 复盘 frame_log 的实测误差、aim_mode、translation_allowed 和 real_left/right，以及 control_log
   的实际请求与 GATT 写入。固件 settling 仍可能出现，GATT 成功不等于车轮执行确认。
5. BLE 失败恢复在停止跟随下测试：首次建连失败后应显示“重新扫描小车”，日志依次出现
   retry_scan_start、retry_scan_found、connect_start(retry=1)。扫描只接受原小车地址；找不到
   小车／扫描权限不足时应结束并提示刷新，不能无限重试。正常连接必须到 serial_ready 才可控制。
6. 分别记录冷启动、主动断开后重连、小车断电后恢复各 5 次的结果、耗时和错误码。软件重连后
   不应自动恢复先前跟随授权。本轮桌面验证不代替这些手机和实车测试。
