ISIP-CART/AutoFollowShoppingCart/design/doc/产品参数信息汇总报告.md

# 4 份图片 PDF 产品参数信息汇总报告

> 整理范围：本报告仅汇总 4 份商品 PDF 中可见的“产品参数、规格、接口、尺寸、型号、配置、可选项”等信息；用户评价、促销、物流、店铺导航等非产品参数信息未作为重点整理。由于原始 PDF 为图片网页截图，部分极小字号或被页面截断的表格项可能存在识别不确定处，已在相应位置标注“图中可见/疑似”。

## 1. 文件与产品对应关系

| 序号 | PDF 文件 | 对应产品 | 店铺/品牌 | 商品页可见价格 |
|---:|---|---|---|---:|
| 1 | `大号亚克力底盘底板四驱差速智能小车520编码器电机 机器人大赛-淘宝网(3).pdf` | 大号四驱底盘 / 四驱差速智能小车底盘，支持 520 编码器电机 | 酷点机器人 / 酷点智能科技 | ￥299 起 |
| 2 | `乐鑫ESP32开发板 搭载WROOM-32E 32U模块 图形化教学编程主板套件-淘宝网.pdf` | 乐鑫 ESP32 开发板，搭载 WROOM-32E / 32U 模块 | HUA | ￥15.2 起 |
| 3 | `亚博智能 轮式电动小车底盘铝合金四驱TI杯电子设计竞赛电赛MSPM0-tmall.com天猫(1).pdf` | 亚博智能轮式电动小车底盘，铝合金，两驱/四驱，TI 杯/电赛用途 | 亚博智能 | ￥333 起 |
| 4 | `亚博智能 四路编码器电机驱动模块4路控制板机器人小车AT8236电赛-tmall.com天猫(3).pdf` | 亚博智能四路编码器电机驱动模块 / 4 路控制板 / AT8236 电赛模块 | 亚博智能 | ￥58 起 |

---

# 2. 产品一：大号亚克力/铝合金四驱底盘底板 520 编码器电机智能小车

## 2.1 商品基础信息

| 项目 | 内容 |
|---|---|
| 商品名称 | 大号亚克力底盘底板四驱差速智能小车 520 编码器电机 机器人大赛 |
| 品牌 | 酷点机器人 |
| 商品类型 | 大号四驱小车底盘 / 智能小车底板 / 机器人竞赛底盘 |
| 标称底板尺寸 | 商品详情图中写明“底板尺寸 230 × 305 mm，不含轮胎”；尺寸图中底板外形长边约 305 mm，宽向主要标注 230 mm |
| 可开发票 | 商品页显示可开发票 |
| 主要材料/结构 | 亚克力底盘底板、铝合金底盘底板；单层 / 双层结构可选 |
| 轮组类型 | 80 mm 麦克纳姆轮、65 mm 大摩擦力轮 / 差速轮等可选 |
| 典型用途 | 四驱底盘、机器人竞赛、ROS 小车开发、差速小车开发、图形化/代码控制实验 |

## 2.2 颜色分类 / 套餐可选项

商品页与详情页可见以下可选配置：

| 类别 | 可选项 |
|---|---|
| 底盘材料与层数 | 亚克力底盘底板-单层（305 系列）（厚 5 mm）；亚克力底盘底板-双层（305 系列）（厚 5 mm）；铝合金底盘底板-单层（305 系列）（厚 3 mm）；铝合金底盘底板-双层（305 系列）（厚 3 mm） |
| 成套小车配置 | 大号亚克力四驱底盘（305 系列）+ 12 V 320 rpm 编码器电机等配置；商品页还展示单层/双层、麦轮/差速轮组合 |
| 可搭配电机 | 520/513 电机、310/370 电机、TT 电机等 |
| 可搭配控制/驱动板 | STM32 主控板、TB6612 / L298N 驱动模块、Nano 扩展板、树莓派固定、DC 降压模块等 |
| 可搭配附件 | 橡胶轮、麦轮、牛眼轮、万向轮、机械臂、摄像头、5 英寸显示屏、电压显示表、A1 雷达支架等 |

## 2.3 底盘结构与尺寸规格

### 2.3.1 单层/双层及轮组规格

| 序号 | 图中名称 | 轮组/结构 | 长 × 宽 × 高 | 图中重量 |
|---:|---|---|---|---:|
| 1 | 四驱麦轮底盘 - 单层（80 mm 麦轮） | 白色单层，麦克纳姆轮 | 307 × 305 × 80 mm | 约 1615 g |
| 2 | 四驱麦轮底盘 - 双层（80 mm 麦轮） | 白色双层，麦克纳姆轮 | 307 × 305 × 123 mm | 约 2110 g |
| 3 | 四驱差速小车 - 单层（65 mm 大摩擦力轮） | 白色单层，差速轮 | 282 × 305 × 69 mm | 约 1415 g |
| 4 | 四驱差速小车 - 双层（65 mm 大摩擦力轮） | 白色双层，差速轮 | 282 × 305 × 116 mm | 约 1910 g |
| 5 | 四驱麦轮底盘 - 单层（80 mm 麦轮） | 黑色单层，麦克纳姆轮 | 307 × 305 × 80 mm | 约 1465 g |
| 6 | 四驱麦轮底盘 - 双层（图中文字显示 65 mm 大摩擦力轮；图中外观接近麦轮） | 黑色双层 | 307 × 305 × 126 mm | 约 1805 g |
| 7 | 四驱麦轮/差速底盘 - 单层（65 mm 大摩擦力轮） | 黑色单层，65 mm 轮 | 282 × 305 × 72 mm | 约 1225 g |
| 8 | 四驱差速小车 - 双层（65 mm 大摩擦力轮） | 黑色双层，65 mm 轮 | 282 × 305 × 119 mm | 约 1565 g |

### 2.3.2 底板孔位 / 外形图中可见尺寸

| 项目 | 图中尺寸/说明 |
|---|---|
| 底板长边 | 305 mm |
| 底板宽向主要标注 | 230 mm |
| 中央安装槽/孔距 | 可见 60 mm、58 mm、49 mm、40 mm、30 mm、25 mm、24 mm、16 mm 等孔距/槽距标注 |
| 圆孔/弧角标注 | 可见 Ø20、R17.5、Ø6.50 等标注 |
| 两侧长圆孔 | 用于把手/固定/扩展安装，尺寸图中有长孔位置标注 |
| 说明 | 该尺寸图主要用于底板开孔与安装定位，未给出完整工程图公差 |

## 2.4 520 编码器电机参数

详情页标注“可搭配 520 编码器电机”，并强调“编码器内置滤波电路设计，有效提高编码器对电机电流的抗干扰能力，波形输出更稳定”。

### 2.4.1 电机性能参数表

> 更新说明：根据当前已确认的采购版本，项目实际采用**减速比 30**这一列参数，即 12V、空载转速 320rpm 的 520 编码器电机。以下保留全表用于对比，但后续项目文档默认以配置 C 作为本项目电机参数口径。

| 项目 | 配置 A | 配置 B | 配置 C | 配置 D | 配置 E |
|---|---:|---:|---:|---:|---:|
| 电压 | 6 V | 12 V | 12 V | 12 V | 12 V |
| 空载电流 | ≤160 mA | ≤160 mA | ≤160 mA | ≤160 mA | ≤160 mA |
| 空载转速 | 960 rpm | 510 rpm | 320 rpm | 192 rpm | 107 rpm |
| 额定转矩 | 1 kg·cm | 1.8 kg·cm | 3.0 kg·cm | 4.8 kg·cm | 8.5 kg·cm |
| 额定转速 | 540 rpm | 285 rpm | 180 rpm | 105 rpm | 60 rpm |
| 额定电流 | ≤1.2 A | ≤1.2 A | ≤1.2 A | ≤1.2 A | ≤1.2 A |
| 最大转矩 | 2.0 kg·cm | 4.0 kg·cm | 6.0 kg·cm | 10.0 kg·cm | 17.0 kg·cm |
| 堵转电流 | 3.5 A | 3.5 A | 3.5 A | 3.5 A | 3.5 A |
| 减速后编码器线数 | 110 | 207 | 330 | 550 | 990 |
| 重量 | 约 150 g | 约 150 g | 约 150 g | 约 150 g | 约 150 g |

> 注：图中上表第一行/表头较小，能清晰读出转速、转矩、电流、编码器线数等核心参数；配置 A-E 对应不同转速/减速比版本。

### 2.4.2 编码器参数

| 项目 | 参数 |
|---|---|
| 编码器类型 | AB 相增量式霍尔编码器 |
| 编码器线数 | 11（电机一圈 11 个方波） |
| 输出轴线数计算 | 电机输出轴转一圈对应方波数量需要乘以减速比 |
| 供电电压 | DC 3.3 V / 5 V |
| 响应频率 | 100 kHz |
| 输出信号 | 方波（AB 相） |
| 端子型号 | **本项目已确认采购版本（减速比 30）为 XH254 6P**；商品页说明赠送 XH254 转 XH2.54 排线 |
| 当前项目口径 | 减速比 30；额定电压 12V；空载转速 320rpm；额定转矩 3.0 kg·cm；额定转速 180rpm；额定电流 ≤1.2A；最大转矩 6.0 kg·cm；堵转电流 3.5A；减速后编码器线数 330；端子为 XH254 6P |
| 另一处端子说明 | 减速比 10、30 为 XH254，赠送 XH254 转 XH2.54 排线；减速比 19、56、90 为 PH2.0，赠送 PH2.0 转 XH2.54 排线 |

### 2.4.3 编码器/电机线序

| 序号 | 颜色 | 功能 |
|---:|---|---|
| 1 | 红 | 电机电源 +；与白色对调可改变电机正反转 |
| 2 | 黑 | 编码器电源 - / GND |
| 3 | 黄 | 编码器输出 B 相 |
| 4 | 绿 | 编码器输出 A 相 |
| 5 | 蓝 | 编码器电源 +，3.3 V / 5.0 V |
| 6 | 白 | 电机电源 -；与红色对调可改变电机正反转 |

## 2.5 可搭配 STM32 主控板接口信息

页面展示了“可搭配 STM32 主控板，支持 ROS 小车开发”。图中接口/部件标注如下：

| 区域 | 接口/部件 |
|---|---|
| 电机与编码器 | 4 路普通直流电机；编码器电机 A 口、B 口、C 口、D 口 |
| 显示/传感 | OLED 显示屏、蜂鸣器、MPU9250 |
| 通信与外设 | CAN 口、WiFi/蓝牙接口、PS2 手柄接口、SWD 口、TTL 串口、Type-C 串口 |
| 舵机/扩展 | 5 路舵机、按键 |
| 电源 | 12 V 输出、12 V 供电口、5 V 电源、电源开关 |

## 2.6 控制代码/控制模式

商品详情页写明“提供 7 种模式控制源代码”，图中能看到的模式包括：

| 模式/功能 | 说明 |
|---|---|
| OpenMV 外接模块模式 | 可与视觉模块配合 |
| 五路灰度循迹模块 | 适合基础循迹 |
| CCD 摄像头/线阵模块 | 用于更复杂循迹或识别 |
| 串口命令模式 | 可用固定协议/串口控制 |
| 手柄遥控模式 | 图中显示手柄遥控/遥控操作 |
| 蓝牙 APP 遥控模式 | 手机蓝牙 App 控制 |
| 超声波避障/跟随或 PID 相关模式 | 页面中出现“PID 图形化调试助手”等字样，作为控制调试支持内容 |

---

# 3. 产品二：乐鑫 ESP32 开发板 WROOM-32E / 32U 图形化教学编程主板套件

## 3.1 商品基础信息

| 项目 | 内容 |
|---|---|
| 商品名称 | 乐鑫 ESP32 开发板 搭载 WROOM-32E / 32U 模块 图形化教学编程主板套件 |
| 品牌 | HUA |
| 型号 | ESP32 双核开发板 |
| 芯片 | ESP32-D0WD-V3 |
| USB 接口 | Type-C（部分图中也展示 Micro USB 版本） |
| 处理器架构类型 | 商品参数页显示 ARM |
| 扩展槽类型 | 30P 功能扩展接口 |
| 操作系统/软件支持 | Arduino、MicroPython 等；详情页还写有 mixly、mind+、Python 等编程软件 |
| 典型应用领域 | 51 单片机学习、汽车/机器人/物联网教学原型等（商品参数页可见“51 单片机学习，汽…”字样） |
| 网络接口配置 | 蓝牙 4.0；详情页说明集成 WiFi、蓝牙 |
| 扩展模块 | WiFi / BT 版本 |

## 3.2 套餐/颜色分类

商品页可见以下选项：

| 类型 | 可选项 |
|---|---|
| 单独扩展板 | 扩展板 |
| ESP32-32E | TYPEC-USB-32E 主板 + 已焊排针；TYPEC-USB-32E 主板 + 未焊排针；TYPEC-USB-32E 主板 + 已焊 + USB 线；TYPEC-USB-32E 主板 + 未焊 + USB 线 |
| ESP32-32UE | TYPEC-USB-32UE 主板 + 已焊排针；TYPEC-USB-32UE 主板 + 未焊排针；TYPEC-USB-32UE 主板 + 已焊 + USB 线；TYPEC-USB-32UE 主板 + 未焊 + USB 线；TYPEC-USB-32UE 主板 + 已焊 + 天线；TYPEC-USB-32UE 主板 + 未焊 + 天线 |

## 3.3 ESP32 主板技术参数

| 项目 | 参数 |
|---|---|
| 模组型号 | ESP32-WROOM-32E / ESP32-WROOM-32UE |
| 主控芯片 | ESP32-D0WD-V3，双核 32-bit MCU |
| 无线能力 | 集成 WiFi、蓝牙 |
| SRAM | 520 KB SRAM |
| ROM | 448 KB ROM |
| RTC SRAM | 16 KB SRAM in RTC |
| 外置存储 | 4 MB / 8 MB / 16 MB 可选 |
| USB 转串口芯片 | CH340 |
| 下载/连接特性 | 系统兼容性较好，下载速度更高、更稳定 |
| VIN 外接供电 | 支持 VIN 外接宽电压输入 5-12 V；图中文字注明“电源版最大 5.5V 输入”（该句可能指某一路输出/板载输入限制，原图表述较小） |
| 供电方式 | 支持 USB 供电、外部 3.3 V 供电、VIN 供电三种供电方式 |
| 开发板尺寸 | 52 × 28 mm |
| 重量 | 约 9.5 g |
| 支持软件 | Arduino IDE、mixly、mind+、Python 等编程软件 |

## 3.4 主板结构与接口标注

规格说明图中主板标注：

| 标注 | 内容 |
|---|---|
| 模块 | ESP32-WROOM-32E 模块；可选 ESP32-WROOM-32UE 模块 |
| 指示灯 | Blink 指示灯 D2；电源指示灯 PWR |
| USB/串口 | USB 转 UART 芯片 CH340 |
| 按键 | Boot 按键；Reset 按键 |
| USB 接口 | 用于上传程序及供电；可选 Micro USB / Type-C USB |
| 稳压 | 系统 3.3 V 供电电源芯片 AMS1117 |
| 引脚图 | 页面给出两侧 GPIO、ADC、EN、GND、3.3V、VIN、SPI、UART、I2C 等开发板引脚分布图 |

## 3.5 产品尺寸

| 部件 | 尺寸/孔位 |
|---|---|
| ESP32 主板外形 | 52 mm × 28 mm；另一侧标注 23 mm；排针内距/局部距离 25 mm、47 mm；安装孔 Ø3 mm ×4 |
| 兼容 UNO 扩展板尺寸 | 外形约 68.6 × 53.4 mm |
| UNO 扩展板孔位 | 50.81 mm、52.52 mm、48.39 mm、27.96 mm 等孔距标注；固定孔直径约 3.4 mm ×4 |

## 3.6 ESP32 扩展板参数

| 项目 | 内容 |
|---|---|
| 扩展板型号 | ESP32-DevKitC(30P) 系列扩展板 |
| 支持供电 | DC 6.5-12 V 供电、USB 5 V 供电两种方式 |
| GVS 扩展 | 可接入各类电子模块传感器，同时创建接线设计 JUMP 接口 |
| GVS 电压切换 | 默认跳线帽选择 GVS 输出 5 V 或 3.3 V，便于匹配外接 5 V 电子模块传感器 |
| 扩展接口 | 开发板 IO 扩展接口（GVS 接口）、开发板安装接口、5V/3.3V 输出接口、JUMP 接口等 |
| 接口说明 | ① 电源指示灯 PWR；② USB 5 V 供电输入接口；③ DC 6.5-16 V 供电输入接口；④ I2C 扩展接口（两组）；⑤ 开发板 IO 扩展接口（GVS 接口）；⑥ 开发板安装接口；⑦ 5V/3.3V 输出接口；⑧ Jump 接口，选择 V 电压 5 V 或 3.3 V |

---

# 4. 产品三：亚博智能轮式电动小车底盘 铝合金四驱/两驱 MSPM0/STM32 电赛底盘

## 4.1 商品基础信息

| 项目 | 内容 |
|---|---|
| 商品名称 | 亚博智能 轮式电动小车底盘 铝合金 四驱 TI 杯电子设计竞赛 电赛 MSPM0 |
| 品牌 | 亚博智能 |
| 底盘定位 | 电子设计竞赛专用轮式小车底盘 |
| 结构材料 | 全铝合金车架 |
| 可选驱动形式 | 两驱 / 四驱可选 |
| 可选电机 | L 型 520 编码器电机、310 编码器电机、TT 编码器电机 |
| 可选底盘层数 | 两层 / 三层可选 |
| 主控/驱动可选 | 无电控、四路编码器电机驱动、STM32 + 四路电机驱动、MSPM0 + 四路电机驱动、MSPM0 + 扩展板 + 驱动板 |
| 最大负载 | 10 kg（详情图可见“最大负载：10kg”） |
| 外观尺寸要求 | 长度 <25 cm、宽度 <15 cm、高度 <15 cm，符合 TI 杯电子设计竞赛尺寸/重量要求 |
| 主要卖点 | 孔轴配合精度更高，轮胎不易脱落；底盘支持大量传感器配件；支持 K230/K210 视觉模块；预留安装孔位 |

## 4.2 商品规格/套餐选项

### 4.2.1 颜色分类 / 电机与电池组合

| 驱动 | 电机/套装选项 |
|---|---|
| 两驱 | 【两驱】L 型 520 电机；【两驱】L 型 520 电机 + 12.6 V 电池 + 充电器；【两驱】310 电机；【两驱】310 电机 + 7.4 V 电池 + 充电器；【两驱】TT 编码器电机；【两驱】TT 编码器电机 + 7.4 V 电池 + 充电器 |
| 四驱 | 【四驱】L 型 520 电机；【四驱】L 型 520 电机 + 12.6 V 电池 + 充电器；【四驱】310 电机；【四驱】310 电机 + 7.4 V 电池 + 充电器；【四驱】TT 编码器电机；【四驱】TT 编码器电机 + 7.4 V 电池 + 充电器 |

### 4.2.2 主控类型

| 主控类型 | 说明 |
|---|---|
| 无电控 | 仅机械/电机底盘，不含主控/驱动模块 |
| 四路编码器电机驱动 | 配四路编码器电机驱动板 |
| STM32 + 四路电机驱动 | 配 STM32 主控和四路驱动 |
| MSPM0 + 四路电机驱动 | 配 MSPM0 主控和四路驱动 |
| MSPM0 + 扩展板 + 驱动板 | 配 MSPM0 机器人扩展板和驱动板 |

## 4.3 三款电机参数

| 参数 | L 型 520 编码器电机 | 310 编码器电机 | TT 编码器电机 |
|---|---:|---:|---:|
| 电机额定电压 | 12 V | 7.4 V | 6 V |
| 电机类型 | 永磁有刷 | 永磁有刷 | 永磁有刷 |
| 输出轴 | 直径 6 mm D 型偏心轴 | 直径 3 mm D 型偏心轴 | 直径 5 mm 双 D 轴（图中文字可见“直径 5mm 双…”） |
| 堵转扭矩 | 10 kg·cm | ≥1.0 kg·cm | ≥1.0 kg·cm（图中同栏合并/可见） |
| 额定扭矩 | 4.4 kg·cm | 0.4 kg·cm | 1.2 kg·cm |
| 减速前转速 | 12000 rpm | 9000 rpm | 16000 rpm |
| 减速后转速 | 300 rpm ±5% | 450 rpm ±5% | 355 rpm ±5% |
| 额定功率 | 6 W | 4.8 W | 1.8 W |
| 堵转电流 | 4 A | ≤1.4 A | ≤1.4 A |
| 额定电流 | 0.5 A | ≤0.65 A | 0.3 A |
| 齿轮组减速比 | 1:40 | 1:20 | 1:45 |
| 编码器类型 | AB 相增量式霍尔编码器 | AB 相增量式霍尔编码器 | AB 相增量式霍尔编码器 |
| 编码器供电电压 | 3.3 V - 5 V | 3.3 V - 5 V | 3.3 V - 5 V |
| 磁环线数 | 11 线 | 13 线 | 13 线 |
| 接口类型 | PH2.0-6P | PH2.0-6P | PH2.0-6P |
| 单电机重量 | 159.2 g | 70 g | 41.3 g |

## 4.4 两驱 / 四驱车型参数

| 车型 | 电机 | 尺寸 | 负载 | 空载速度 |
|---|---|---|---:|---:|
| 两驱底盘 | L 型 520 编码器电机 | 228 × 148 × 102.15 mm | 8 kg | 1.2 m/s |
| 两驱底盘 | 310 编码器电机 | 228 × 148 × 88.5 mm | 2 kg | 1.3 m/s |
| 两驱底盘 | TT 编码器电机 | 228 × 148 × 93.72 mm | 6 kg | 1.4 m/s |
| 四驱底盘 | L 型 520 编码器电机 | 228 × 148 × 102.15 mm | 10 kg | 1.2 m/s |
| 四驱底盘 | 310 编码器电机 | 228 × 148 × 88.5 mm | 3 kg | 1.3 m/s |
| 四驱底盘 | TT 编码器电机 | 228 × 148 × 93.72 mm | 10 kg | 1.4 m/s |

## 4.5 两层/三层底盘参数

| 项目 | 参数/说明 |
|---|---|
| 2 层四驱小车底盘高度 | 图中标注 93.72 mm |
| 3 层四驱小车底盘高度 | 图中标注约 122.2 mm / 141.2 mm（两处高度线标注较小，建议以原图复核） |
| 结构说明 | 车架、底盘均采用金属铝材质，坚固耐用；2 层、3 层高度可选，满足不同高度和空间需求 |
| 竞赛尺寸 | 车身宽度小于 15 cm，符合电子设计竞赛标准 |
| 安装扩展 | 底盘设有多个安装孔位，支持安装大量竞赛配件 |
| 加高套件 | 图中显示 M3 × 20~60 mm 单通铜柱、M3 × 40~60 mm 单通铜柱等可用于加高 |

## 4.6 MSPM0 / STM32 主控可选参数

| 参数 | MSPM0G3507 | STM32F103C8T6 |
|---|---|---|
| 内核 | Cortex-M0 | Cortex-M3 |
| 引脚封装数量 | 48 | 48 |
| 接口资源 | 2×SPI、4×USART、2×I2C、1×CAN、32×I/O、1×DAC | 2×SPI、3×USART、2×I2C、1×CAN、36×I/O |
| 定时器 | 7 个 | 7 个 |
| ADC | 2×ADC，12 位，7 通道 | 2×ADC，12 位，16 通道 |
| SRAM | 32 K | 20 K |
| 内部 FLASH | 128 K | 64 K |
| 外部 FLASH | 4 M | 无 |
| 调试工具 | KEIL MDK、CCS 等 | KEIL MDK、STM32CubeMX 等 |
| 电压范围/ADC | 外部电压 1.62-3.6 V；内核电压 2.5 V | 外部电压 2.0-3.6 V；内核电压 1.8 V |
| BOOT0 管脚 | 无 BOOT0 管脚 | Flash 程序运行时 BOOT0 可悬空 |
| 主频 | 80 MHz | 72 MHz |
| 功耗 | 睡眠模式 2.76 mA；待机模式 1.5 µA；运行功耗 8 mA / 80M | 睡眠模式 7.5 mA；待机模式 3.4 µA；运行功耗 52 mA / 72M |
| 程序下载 | SWD 或者串口一键下载 | 图中说明较小，可见与下载/调试相关内容 |
| LED | 电源红色指示灯、自定义 LED 灯 ×2 | 电源红色指示灯、PC13 用户自定义蓝色 LED 灯 |
| 按键 | 复位按键、自定义按键 | BOOT0 按键、复位按键 |
| 接口 | SWD 调试接口、Type-C 接口、LCD 显示屏接口 | SWD 调试接口、Type-C 接口、LCD 显示屏接口 |
| 尺寸 | 18.89 × 51.12 mm | 18 × 51 mm |
| 重量 | 7 g | 6.7 g |

## 4.7 MSPM0 机器人扩展板参数/接口

图中展示“可选 MSPM0 机器人扩展板”。可见接口/功能包括：

| 类别 | 信息 |
|---|---|
| 主控兼容 | MSPM0 机器人扩展板，与 MSPM0 主控配合使用 |
| 接口/端子 | 多路电机/编码器接口、传感器接口、舵机/电源接口、通信接口等，图中用白色端子和排针标注 |
| 产品特点 | 支持多种竞赛模块快速连接，适合电子设计竞赛小车扩展使用 |
| 供电/输出 | 图中可见 5 V、3.3 V、电源输入/开关、多个 GVS/模块接口字样 |
| 说明 | 由于页面字体极小，扩展板逐项接口名称建议以原图或卖家资料包复核 |

## 4.8 四路编码器电机驱动模块参数（作为该底盘可选模块）

该底盘商品页内也展示了“可选四路编码器电机驱动模块”，详细信息见本报告第 5 章。该模块可与编码器电机配合，实现四路电机控制、编码器测速和与主控通信。

## 4.9 电池/充电器参数

详情页展示 12 V 与 7.4 V 锂电池/充电器套装：

| 套装 | 参数 |
|---|---|
| 12 V 锂电池 | 图中标称容量约 4800 mAh，配充电器；用于 L 型 520 电机套装 |
| 7.4 V 锂电池 | 图中标称容量约 2000 mAh，配充电器；用于 310 / TT 电机套装 |
| 商品选项 | 多个两驱/四驱电机套餐均可选择“电池 + 充电器”版本 |

## 4.10 视觉模块与传感器扩展

| 项目 | 参数/说明 |
|---|---|
| K230 视觉模块 | 底盘支持安装 K230 视觉模块；图中展示固定在前上方，前向安装高度/位置可调 |
| K210 视觉模块 | 底盘支持安装 K210 视觉模块；图中同样展示前上方安装 |
| 传感器扩展 | 页面说明底盘支持大量传感器配件，图中示例含巡线/激光/超声/IMU 等模块化安装思路 |
| 安装孔位 | 预留安装孔位满足个性化需求 |

---

# 5. 产品四：亚博智能四路编码器电机驱动模块 4 路控制板 AT8236

## 5.1 商品基础信息

| 项目 | 内容 |
|---|---|
| 商品名称 | 亚博智能 四路编码器电机驱动模块 4 路控制板 机器人小车 AT8236 电赛 |
| 品牌 | 亚博智能 |
| 型号 | 四路编码器电机驱动模块 |
| 额定电压 | 5 V（商品参数页可见） |
| 适用场景 | 商品参数页显示“/” |
| 安装方式 | 嵌入式 |
| 颜色分类/套餐 | 四路编码器电机驱动模块；四路编码器电机驱动模块 + 铜柱 + 数据线；四路编码器电机驱动模块 + 铜柱 + 数据线 + 电源线 |
| 主要用途 | 电子设计竞赛、机器人小车 DIY、编码器电机驱动与测速 |

## 5.2 产品简介

| 项目 | 内容 |
|---|---|
| 控制核心 | 模块集成高性能单片机处理器 |
| 主控通信 | 可通过串口或 IIC 通讯方式与 MSPM0、STM32、树莓派、Jetson 等多种控制器无缝对接 |
| 接线特点 | 只需四根连接线即可与主控单元进行高效通讯，降低接线数量与操作难度 |
| 电机能力 | 支持驱动市面上大多数带编码器的直流电机，包括 520 / 310 等直流减速电机 |
| 编码器数据 | 模块可获取编码器数据，便于测速、闭环控制和运动状态反馈 |
| 适用对象 | 电子竞赛、机器人小车 DIY、智能车实验平台 |

## 5.3 产品特性

| 序号 | 特性 |
|---:|---|
| 1 | 支持 5-12 V 市面上大多数直流减速电机和编码器测速电机 |
| 2 | 搭载 AT8236 芯片，自带短路保护、过流、过热等多种保护 |
| 3 | 支持与外部控制器串口或 IIC 通信，简化控制流程 |
| 4 | 兼容多种主控：STM32、树莓派、ESP32、JETSON、Arduino、MSPM0 等 |
| 5 | 电机支持 PH2.0 排线、XH2.54 排线、杜邦线等多种连接方式 |
| 6 | 板载电源防反接保护电路 |
| 7 | 板载高性能协议处理器，用于电机控制和编码器数据获取 |
| 8 | 板载 Type-C 接口，支持与树莓派等嵌入式主控通过 USB 串口通讯，减少引脚占用 |
| 9 | 板载 PH2.0-4pin、PH2.0-6pin、XH2.54-2pin 防反接接口 |
| 10 | 内置电压检测电路，ADC 可读取电源电压 |
| 11 | 板载 IO 口隔离保护，降低硬件损坏风险 |
| 12 | 预留电机驱动测试点，支持使用示波器进行信号监测分析 |

## 5.4 电机驱动模块对比表

商品详情页给出“电机驱动模块对比”，本产品与另外两类模块对比如下：

| 参数 | 四路编码器电机驱动模块（本产品） | 双路电机驱动模块 | 双路电机驱动模块 / TB6612 类模块 |
|---|---:|---:|---:|
| 驱动电机数量 | 4 | 2 | 2 |
| 板载协议处理器 | STM32 | 无 | 无 |
| 电机驱动芯片 | AT8236 ×4 | AT8236 ×2 | TB6612 |
| 电机编码器 | 板载编码器接口 | 图中为“不支持/无”或简化接口 | 不支持编码器连接 |
| 通讯 | IIC 或串口通讯 | 无 | 无 |
| PH2.0-6pin 编码器电机接口 | 4 个 | 2 个 | 无 |
| 排针电机接口 | 4 个 | 2 个 | 2 个 |
| XH2.54-2pin 电机接口 | 4 个 | 无 | 无 |
| 单片机引脚占用数量 | 4 个 | 12 个 | 8 个 |
| 控制方式 | 通过串口或 IIC 通讯控制电机，获取编码器数据 | 通过引脚电平和 PWM 信号控制电机 | 通过引脚电平和 PWM 信号控制电机 |
| 驱动难度 | 简单 | 复杂 | 复杂 |

## 5.5 支持电机类型

详情页“可驱动电机列表”展示：

| 电机类别 | 图中示例 |
|---|---|
| TT 电机 | 黄色 TT 减速电机 |
| 金属电机 | L 型 520 编码器电机、310 编码器电机、其他圆柱金属减速电机等 |
| 编码器电机 | 支持带编码器反馈的直流减速电机，用于测速/闭环控制 |

---

# 6. 横向对比与项目选型提示

## 6.1 四个产品的角色定位

| 产品 | 在自主跟随购物车项目中的可能角色 | 优点 | 需要注意 |
|---|---|---|---|
| 酷点大号四驱底盘 | 原型底盘、亚克力/铝合金多孔位平台 | 尺寸较大，孔位丰富，可装传感器/控制板，支持麦轮和差速轮 | 具体承载能力未在图中明确；双层/轮组版本多，选购时需确认尺寸和重量 |
| ESP32 开发板 | 无线通信、低成本控制、传感器读取、辅助主控 | WiFi/蓝牙、Type-C、CH340、软件生态广 | 作为主控驱动多电机时需要外接驱动板；供电和 IO 电平要核对 |
| 亚博铝合金小车底盘 | 电赛级铝合金底盘，适合规范化竞赛/项目原型 | 明确最大负载 10 kg，铝合金结构，两驱/四驱/电机/主控组合丰富 | 外形偏小，购物篮需要独立结构设计；负载为底盘能力，不等同于整个购物车系统承载 |
| 亚博四路编码器电机驱动模块 | 四路编码器电机驱动、测速、闭环控制接口 | 接线少，串口/IIC 通讯，支持 4 路编码器电机，兼容多主控 | 需要确认协议资料、供电、电机峰值电流与散热是否满足实际负载 |

## 6.2 与“自主跟随购物车”项目相关的关键参数

| 需求 | 重点关注参数 | 相关产品 |
|---|---|---|
| 承载购物篮/货物 | 最大负载、底盘材料、轮径、层数、重心高度 | 亚博铝合金底盘标称最大负载 10 kg；酷点大号底盘需进一步确认承载 |
| 稳定移动 | 轮距、长宽高、轮组类型、重心 | 酷点大号底盘宽 305 mm，稳定性较好；亚博底盘尺寸小但铝合金精度较好 |
| 编码器闭环控制 | 编码器线数、AB 相输出、电机转速、驱动模块通讯 | 520 编码器电机、亚博四路编码器驱动模块 |
| 主控/通信 | WiFi、蓝牙、串口/IIC、开发环境 | ESP32、MSPM0/STM32、四路驱动模块 |
| 视觉/跟随 | K210/K230/OpenMV/摄像头安装能力 | 亚博底盘支持 K210/K230，酷点底盘支持 OpenMV、摄像头、雷达支架等扩展 |
| 快速原型 | 资料、接口、模块化安装 | 两套底盘均提供丰富孔位/扩展板；亚博驱动模块降低电机控制难度 |

---

# 7. 识别不确定项与建议复核清单

以下项目在原始 PDF 中字号较小、截图分辨率有限或被网页裁切，建议在最终采购前向商家确认：

1. 酷点大号四驱底盘的实际承载能力、不同材料/层数/轮组版本的完整 SKU 对应关系。
2. 酷点 520 编码器电机参数表第一行表头及各版本与减速比、转速的精确对应关系。
3. 酷点黑色底盘中“麦轮/65 mm 大摩擦力轮”标题与图片轮型的对应关系。
4. 亚博铝合金底盘 3 层高度标注图中存在较小字号，建议确认 3 层实际高度。
5. 亚博 MSPM0 扩展板和四路驱动板的完整接口定义、通讯协议、默认固件、示例代码。
6. 亚博四路编码器电机驱动模块额定/峰值电流、散热条件、5-12 V 电机供电与 5 V 逻辑供电是否隔离。
7. ESP32 开发板“VIN 外接宽电压输入 5-12V”与图中“5.5V 输入”相关描述需结合卖家原理图确认，避免误接。
