ISIP-CART/AutoFollowShoppingCart/design/background/README.md

# design/background/ — 背景调研目录

## 目录用途

本目录存放自主跟随购物车项目的背景调研、资料摘要、来源链接和对本项目的启发。

所有调研服务于**首版课程原型**的目标收敛（4 周、3 人、室内低速安全跟随闭环），不把商业化智能购物车、完整 SLAM、自动结账等选做功能升级为必做功能。

## 文件列表与建议阅读顺序

| 序号 | 文件 | 内容 | 建议阅读顺序 |
| --- | --- | --- | --- |
| 01 | `01-project-context.md` | 行业背景、项目定位、现实约束、对当前方案的结论 | 1 |
| 02 | `02-openbot-platform.md` | OpenBot 核心架构、App、Firmware、通信链路、可复用点与风险 | 2 |
| 03 | `03-smart-shopping-cart-and-following-products.md` | 竞品对比、借鉴与不复制清单、差异化分析 | 3 |
| 04 | `04-person-detection-and-following.md` | 人物检测方案、目标锁定与跟踪、跟随控制策略 | 4 |
| 05 | `05-chassis-mcu-and-safety.md` | 差速底盘选型、MCU 对比、通信方式、电机驱动、电源、安全机制 | 5 |
| 06 | `06-shopping-scenario-and-requirements.md` | 购物场景特点、演示场景设计、需求约束与测试项 | 6 |
| — | `sources.md` | 统一资料来源清单（网址、论文、手册、商品资料等） | 参考用 |

## 编写原则

- 每份调研文档应明确：调研目的、关键事实、对本项目的启发、结论。
- 所有事实应标注来源（链接或文件路径），未确认的信息应标注"未确认"。
- 对首版不可行的技术路线应明确指出"首版不采用"及其原因。
- 文档之间可相互引用，但不重复展开已在其他文档中详述的内容。
