ISIP-CART/AutoFollowShoppingCart/design/自主跟随购物车上位机软件开发计划.md

# 自主跟随购物车上位机软件开发计划（行为决策与多线索安全跟随版）

更新日期：2026-07-08  
适用对象：上位机 / Android 端负责人  
当前定位：在 OpenBot 现有 Android 工程基础上，将人物检测、ReID、距离控制、局部可通行空间、状态机与控制输出统一到一个安全行为决策层中。

> 2026-09-05 实施补充：先在当前 V1 固件下修正视觉障碍坐标、短时原目标恢复、同向对准等待和缓弯跟距；参数为候选版本 `follow-r3-preflight-v1`，须经实车对照验证。三路测距按 [R3-V1](购物车三路测距扩展协议R3-V1.md) 交付下位机同学，先开发不烧录，旧版最小值继续仅显示／记录。左右传感器实际朝正侧方，不能解释成左右前方可通行通道；三路诊断验证后再实施传感器运动决策和遮挡拐角处理，目标丢失禁止前向搜索。

---

## 0. 当前判断与路线收口

### 0.1 文档定位

本文档不再承担完整进度流水账的职责。已完成的代码、采集器、PC 测试脚本和测试结果分别记录在：

- `dev/OpenBot/android/cartfollow-devlog.md`
- `tools/reid_pc_test/README.md`
- `tools/reid_pc_test/docs/ReID调研测试迭代记录与下一步计划.md`
- `tools/reid_pc_test/docs/person-crop-collector完成计划.md`

本文档只保留对后续上位机路线有直接影响的判断：系统下一阶段应从“验证 ReID 是否可用”转向“如何安全、主动、可解释地决定小车动作”。

### 0.2 核心阶段判断

ReID 的调研和离线验证已经足以支撑首版工程接入。它的角色应收敛为身份线索之一，而不是继续作为独立主线消耗主要开发时间。

上位机当前真正需要解决的是行为仲裁问题：

```text
1. 跟谁：目标身份保持 / ReID / 遮挡重识别
2. 离多远：跟随距离估计 / 距离控制
3. 能不能走：障碍风险判断 / 安全停车
4. 怎么动：FOLLOW / AVOID / LOCAL_SEARCH / BLOCKED_WAIT / hard STOP
```

推荐将所有线索统一成以下链路：

```text
Perception Evidence
  ↓
BehaviorDecision / SafetyFusion
  ↓
Safe Action
  ↓
Control(left, right) 或 Human Cart Simulator 提示
```

### 0.3 首版策略口径

首版仍然坚持安全优先，但安全优先不等于一丢目标就 hard `STOP`。后续状态机应明确区分：

| 概念 | 含义 |
| --- | --- |
| `motion_stop` | 线速度清零，禁止继续向前，但系统仍在观察、搜索或等待重捕获 |
| `LOCAL_SEARCH` | 低速原地扫描，根据最后目标位置、消失方向和场景风险选择方向 |
| `REACQUIRE` | 疑似目标重新出现，多帧融合 ReID、bbox 连续性、距离和风险后恢复 |
| hard `STOP` | 搜索失败、风险过高、急停、通信异常或需要人工重新确认 |

也就是说，智能性应体现在“停住以后还会安全地找人”，而不是“不停地冒险追人”。

### 0.4 近期与远期能力边界

近期默认路线仍是手机端本地闭环：

- 普通 RGB 摄像头；
- OpenBot person detector；
- ReID 低频或事件触发推理；
- bbox 距离标定与图像伺服；
- 左 / 中 / 右局部可通行空间估计；
- Human Cart Simulator 先验证行为策略，再低速接入真实底盘。

如果后续手机性能仍有余量，可以逐步打开增强能力：

- 更高频 ReID 或更大模型；
- 单目深度用于局部风险热力图；
- 光流 / TTC 近似用于动态接近风险；
- 更细的动作走廊评分，例如 `SLOW_FORWARD / LEFT_ARC / RIGHT_ARC / ROTATE_LEFT / ROTATE_RIGHT`。

如果手机性能不足，应优先降级频率，而不是牺牲安全：

- ReID 只在初始化、多人混淆、目标重现时运行；
- 深度模型关闭或低频运行；
- 局部避障退化为三方向启发式评分；
- 外接 ToF / 超声波作为近距离安全兜底。

云端服务器可以作为后续研究或演示增强，但不应进入首版实时安全闭环。可考虑的云端用途包括离线日志分析、参数推荐、复杂场景复盘、模型评估和非实时策略调优；不建议依赖云端完成急停、近距离避障或实时身份判决。

### 0.5 `tools/` 中 ReID 研究资产的工程定位

目前 `tools/reid_pc_test` 已经形成一套有价值的 PC 端研究工作区，其中包含：

- 自编写的对比、gallery 模拟、误匹配分析脚本；
- `docs/` 中的调研结论与迭代记录；
- `images/`、`weights/`、`outputs/` 等实验数据；
- 直接 clone 的上游仓库 `deep-person-reid`。

这里需要明确一个工程边界：

1. `tools/reid_pc_test` 的主要定位是**PC 侧算法研究与数据验证工作区**，不是 App 运行时依赖。
2. `deep-person-reid` 在首版项目中，不建议默认再把它升级成主仓库的正式 submodule。
3. 更推荐的处理方式是：
   - 主仓库重点保留你们自己写的脚本、调研文档、少量必要样例；
   - 所有成员直接在本仓库获取这些研究资产，因此移除 `deep-person-reid` 内部的 `.git`，将其转为普通目录后再统一纳入版本管理；
   - README文档中保留了其上游来源、用途和本地改动边界；
   - `images/`、`outputs/`、`weights/` 等目录默认不应进入版本库，其中 `images/` 与 `outputs/` 可能含有私人照片或由私人照片导出的结果，必须通过 `.gitignore` 明确排除。

---

## 1. 开发原则

### 1.1 先复用 OpenBot，再做场景化增强

首版不重写整套视觉与控制框架，而是复用 OpenBot 的：

- 手机摄像头与推理链路
- App 基础交互框架
- `Control(left, right)` 控制输出方式
- 串口 / 蓝牙到底盘控制板的现有控制路径

新增部分主要集中在：

- 目标初始化与用户确认
- 目标记忆与目标保持
- ReID 增强重识别
- 跟随距离估计
- 障碍风险判断
- 面向购物场景的安全状态机

---

### 1.2 ReID 作为首版增强项，但必须可降级运行

ReID 的作用是解决“这个人是不是用户确认过的目标”，而不是替代人物检测或状态机。

首版策略：

- 若 ReID 模块部署成功，则作为目标身份匹配的强特征之一；
- 若 ReID 模块尚未跑通，则系统退化为 `bbox + 运动连续性 + 尺寸 + 颜色特征 + 状态机`；
- ReID 不能作为唯一依据，不能因为单次 ReID 高分就直接切换目标；
- 当身份不确定时，应先进入 `motion_stop + IDENTITY_UNCERTAIN / LOCAL_SEARCH`，禁止继续前进，但允许原地低速搜索和多帧重捕获；只有搜索失败或风险过高时才进入 hard `STOP`。

---

### 1.3 不依赖 ARCore 作为主路线

ARCore / ARCore Depth 依赖设备与 Google Play Services for AR 支持。在中国地区或无 GMS 设备上，部署稳定性不可控，因此不作为首版基础依赖。

推荐策略：

- ARCore Depth：仅作为设备支持时的增强选项；
- 首版主线：普通 RGB 摄像头 + OpenBot 检测 + 可选 TFLite 单目深度模型；
- 安全兜底：必要时增加 ToF / 超声波等低成本传感器。

---

### 1.4 手机视觉优先，但不承诺完整视觉避障

OpenBot 的核心思想是利用手机作为主要计算与感知平台，因此首版应优先尝试用手机完成：

- 目标身份判断；
- 目标距离估计；
- 前方障碍风险判断；
- 不确定时减速或停车。

但手机视觉不应被包装成可靠完整避障系统。首版目标应是：

```text
视觉发现风险 → 减速 / 停车
```

而不是：

```text
视觉建图 → 规划绕障 → 自动绕过障碍
```

---

### 1.5 无底盘实时仿真调试必须保留

在硬件未就绪前，上位机不应只输出日志，而应支持“人肉底盘”实时闭环：

```text
测试者 A 手持手机模拟购物车视角
测试者 B 作为目标用户
App 实时显示“前进 / 左转 / 右转 / 停止 / 原地搜索”
测试者 A 按提示移动
形成视觉—决策—人工执行—视觉反馈的近似闭环
```

该模式可以提前验证目标初始化、ReID、目标保持、距离控制、目标丢失处理和 UI 可用性。

---

## 2. 上位机总体架构

建议将上位机从“感知模块并列输出”升级为“证据输入 + 行为决策 + 控制执行”的三层结构：

```text
ShoppingCartFollow
├─ PerceptionEvidence
│  ├─ PersonDetectorAdapter
│  ├─ TargetInitializer
│  ├─ TargetMemory
│  ├─ PersonTracker
│  ├─ ReIDFeatureExtractor
│  │  ├─ ColorReIDFeatureExtractor
│  │  └─ OnDeviceReIDFeatureExtractor
│  ├─ DistanceEstimator
│  │  ├─ ImageSetpointDistanceEstimator
│  │  └─ MonocularDepthDistanceEstimator（增强）
│  ├─ LocalTraversabilityEstimator
│  ├─ MotionRiskEstimator（增强）
│  └─ ExternalSensorRiskEstimator（硬件兜底）
├─ BehaviorDecision
│  ├─ PersonMatcher
│  ├─ FollowStateMachine
│  ├─ SafetyFusion
│  ├─ LocalAvoidancePolicy
│  └─ ActionArbitrator
├─ ActionExecution
│  ├─ ControlGenerator
│  ├─ HumanCommandInterpreter
│  └─ VehicleControlAdapter
└─ DebugAndData
   ├─ HumanCartSimulatorUI
   ├─ FollowDebugLogger
   └─ SequenceReplay / PC Regression
```

模块职责：

| 模块 | 作用 | 首版建议 |
| --- | --- | --- |
| `PersonDetectorAdapter` | 读取 OpenBot 人物检测结果并转换为统一数据结构 | 必做 |
| `TargetInitializer` | 候选目标采集、截图、确认前逻辑 | 必做 |
| `TargetMemory` | 记录目标外观、位置、动态状态、ReID 特征库 | 必做 |
| `PersonTracker` | 维护短时轨迹连续性 | 必做 |
| `ReIDFeatureExtractor` | 对候选人框提取身份 embedding，只作为身份线索之一 | 推荐接入，可低频运行 |
| `PersonMatcher` | 融合 ReID、位置、运动、颜色、尺寸、置信度，输出身份证据 | 必做 |
| `DistanceEstimator` | 估计目标远近，用于保持 0.8-1.2 m 跟随距离 | 必做 |
| `LocalTraversabilityEstimator` | 输出左 / 中 / 右可通行评分与置信度 | 必做视觉简版 |
| `MotionRiskEstimator` | 判断动态接近风险，例如路人横穿、目标突然停止 | 增强项 |
| `ExternalSensorRiskEstimator` | 接入 ToF / 超声波 / 碰撞开关等安全冗余 | 硬件到位后 |
| `FollowStateMachine` | 管理初始化、确认、重识别、跟随、丢失、搜索、停止 | 必做 |
| `SafetyFusion` | 融合身份、距离、障碍、通信、急停等风险，决定安全边界 | 必做 |
| `LocalAvoidancePolicy` | 根据目标方向和可通行空间选择局部避障候选动作 | 必做简版 |
| `ActionArbitrator` | 在跟随、搜索、等待、避障、急停之间做最终行为选择 | 必做 |
| `ControlGenerator` | 将安全动作映射为 `Control(left,right)` | 必做 |
| `VehicleControlAdapter` | 隔离 OpenBot 控制接口与底盘实际通信细节 | 实车阶段必做 |
| `HumanCommandInterpreter` | 将 `Control(left,right)` 翻译成人类可执行提示 | 必做 |
| `HumanCartSimulatorUI` | 无底盘模式实时显示目标框、动作提示、分数和日志 | 必做 |
| `FollowDebugLogger` | 记录证据、状态、动作、控制量、耗时与降级原因 | 必做 |

### 2.1 统一证据结构

后续各模块不要直接互相调用决策，而应先输出统一证据：

```text
IdentityEvidence:
  identity_score
  reid_score
  reid_margin
  tracking_score
  identity_confidence

DistanceEvidence:
  distance_state
  height_scale
  area_scale
  bottom_shift
  distance_confidence

TraversabilityEvidence:
  left_free_score
  center_free_score
  right_free_score
  left_risk
  center_risk
  right_risk
  traversability_confidence

SystemSafetyEvidence:
  emergency_stop
  communication_ok
  detector_ok
  inference_latency_ms
  thermal_or_fps_degraded
```

行为决策层只消费这些证据，不关心它们来自 ReID、bbox、深度、光流、外接传感器还是云端离线分析。

### 2.2 行为输出结构

第一版必须把“状态”和“动作”分开，避免状态机爆炸。

`FollowStateMachine` 管理任务阶段和身份阶段，例如初始化、确认、跟随、丢失、重捕获、停止；`ActionArbitrator` 根据当前状态和证据选择本帧动作，例如慢速跟随、停止、原地搜索、左弧线、右弧线或等待。

最终行为输出应比 `Control(left,right)` 更高一层：

```text
BehaviorAction:
  FOLLOW_SLOW
  FOLLOW_CAUTION
  LEFT_ARC
  RIGHT_ARC
  MOTION_STOP
  LOCAL_SEARCH_LEFT
  LOCAL_SEARCH_RIGHT
  BLOCKED_WAIT
  REACQUIRE_HOLD
  HARD_STOP
  EMERGENCY_STOP
```

同时建议输出完整决策结果：

```text
BehaviorDecisionResult:
  current_state
  selected_action
  action_reason
  safety_block_reason
  confidence
  degraded_mode
```

`ControlGenerator` 只负责把这些动作映射成 OpenBot 兼容控制量。这样做可以让 Human Cart Simulator、真实底盘和 PC replay 共用同一套决策语义。

---

## 3. 两阶段目标初始化方案

### 3.1 设计动机

如果用户站在车前完成初始化，而系统一检测到人就直接开始跟随，会有两个问题：

1. 用户不知道系统锁定的是不是自己；
2. 用户为了看手机回到车旁确认时，车辆若直接起步会有安全风险。

因此，目标初始化应拆成两层：

```text
系统候选锁定
  ↓
用户确认
  ↓
目标重新进入视野
  ↓
稳定重识别
  ↓
倒计时启动
```

---

### 3.2 状态流程

```text
IDLE
  ↓ 用户点击开始
CAPTURE_TARGET
  ↓ 采集候选目标
LOCKED_PENDING_CONFIRM
  ↓ 用户确认
CONFIRMED_ARMED
  ↓ 用户回到车前视觉范围
REACQUIRE_TARGET
  ↓ 连续稳定匹配
READY_TO_FOLLOW
  ↓ 倒计时结束
FOLLOW
```

异常分支：

- `CAPTURE_TARGET` 失败：继续采集或回到 `IDLE`
- 用户点击“重拍”：回到 `CAPTURE_TARGET`
- 用户点击“取消”：清空记忆，回到 `IDLE`
- `REACQUIRE_TARGET` 超时：保持停止，提示重新进入视野或重新采集

---

### 3.3 初始化阶段应保存的信息

建议保存：

- `confirmed_snapshot`
- `confirmed_bbox`
- `bbox_area`
- `bbox_aspect_ratio`
- `upper_body_color_hist`
- `lower_body_color_hist`
- `seed_embedding` 或少量初始化 embedding
- `initial_confidence`
- `desired_height_ratio`
- `desired_area_ratio`
- `desired_depth_proxy`

其中 `desired_height_ratio`、`desired_area_ratio` 和 `desired_depth_proxy` 用于后续距离保持。

这里要特别强调：**初始化阶段的目标不是一次性建立完整 gallery**。初始化更重要的是：

- 完成“这是我要跟随的人”的确认；
- 记录最小可用的外观与位置基准；
- 为后续 gallery 动态增长留下起点。

也就是说，首版不应把“初始化时必须采满 5-8 张 confirmed gallery”写成硬规则。

---

## 4. 目标记忆设计

### 4.1 多粒度目标记忆

真实购物场景中，不能假设系统始终看到完整人体。用户可能蹲下、侧身、被货架或路人遮挡，甚至只露出上半身、背包或腿部。因此 `TargetMemory` 不应只保存一张完整人体截图，而应维护多粒度特征：

```text
TargetMemory
├─ confirmedSnapshot
├─ confirmedBbox
├─ globalFeature
├─ upperFeature
├─ lowerFeature
├─ colorFeature
├─ reidEmbeddingGallery
├─ galleryUpdatePolicy
├─ lastBbox
├─ lastCenter
├─ lastDepthProxy
├─ lastMotionDirection
├─ lastSeenTime
├─ trackingConfidence
└─ lostDuration
```

---

### 4.2 动态可见区域匹配

不同可见情况采用不同权重：

| 可见情况 | 推荐匹配重点 |
| --- | --- |
| 全身可见 | global ReID + bbox + 运动连续性 + 颜色 |
| 只见上半身 | upper feature 接口 + 位置预测 + 颜色 |
| 只见下半身 | lower feature 接口 + 运动连续性 + bbox 尺寸约束 |
| 被路人短时遮挡 | 不更新目标记忆，等待重识别 |
| 多人交叉 | 提高 ReID 权重，降低单纯位置权重 |
| ReID 不确定 | 降低置信度，进入 `IDENTITY_UNCERTAIN` |

这里的“上半身 / 下半身 / 局部 crop”是工程上的多粒度记忆接口，不意味着首版已经实现专门的 part-based ReID、人体解析或部件对齐网络。首版更现实的做法是：当检测框只覆盖局部人体时，降低身份置信度，并更多依赖位置连续性、运动趋势和状态机。

---

### 4.3 记忆更新原则

目标记忆不能被快速污染：

- 只有高匹配分数且连续稳定时才更新外观特征；
- 遮挡期、多人交叉期不更新外观特征；
- 陌生人短暂更大、更近或更居中时，不立刻切换身份；
- ReID gallery 应允许后续动态扩展，但扩展必须保守，优先在“身份明确、连续稳定、视角有新增信息”时加入新样本；
- 初始化阶段形成的样本只应视为种子记忆，而不是最终完整特征库；
- 当候选人分数接近时，不赌身份，应停车或提示重新确认。

后续需要专门设计 `galleryUpdatePolicy`，至少要回答三个问题：

1. 什么条件下允许把当前帧加入 gallery；
2. 如何判断新样本是否真的带来了新的姿态 / 视角 / 可见区域信息；
3. 如何避免被路人、遮挡和错误匹配污染。

---

## 5. 融合式目标身份匹配：跟踪 + 颜色 + ReID

### 5.1 匹配特征组成

| 特征 | 含义 |
| --- | --- |
| `position_score` | 候选人是否接近上一帧目标位置 |
| `motion_score` | 是否符合目标运动趋势 |
| `size_score` | bbox 面积 / 宽高变化是否合理 |
| `color_score` | 上下身 HSV 直方图相似度 |
| `reid_score` | 候选人与目标 gallery 的最高余弦相似度 |
| `reid_margin` | 当前最佳候选与第二候选的 ReID 分数差 |
| `reid_confidence` | 由 `reid_score`、`reid_margin`、候选排名和多帧稳定性共同得到的身份置信度 |
| `confidence_score` | OpenBot 检测置信度 |

为了避免概念混淆，建议明确区分：

| 名称 | 含义 | 是否可单独决策 |
| --- | --- | --- |
| `reid_score` | 候选人与目标 gallery 的最高余弦相似度 | 不可 |
| `reid_margin` | 当前最佳候选与第二候选的分数差 | 可作为置信度信号 |
| `match_score` | ReID、位置、运动、尺寸、颜色、检测置信度融合后的最终匹配分 | 可用于状态机，但仍需连续帧确认 |

本项目不采用：

```text
reid_score > threshold
→
直接确认目标
```

而采用：

```text
reid_margin + 位置连续性 + 多帧稳定性
```

的组合判断。

---

### 5.2 融合评分

这里需要特别强调：融合评分中的 ReID 项，不应理解为“原始余弦相似度直接线性加权”。

更准确的流程是：

```text
target_score = max cosine(candidate, confirmedGallery)
best_score = 当前画面中所有候选人的最高 target_score
second_score = 当前画面中第二高 target_score
reid_margin = best_score - second_score
```

真正进入融合的，应是经过 `margin`、候选排名和多帧稳定性处理后的：

```text
reid_confidence
```

而不是裸的 `reid_score`。

推荐更保守的两层策略：

```text
第一层：ReID gate

if reid_margin < MARGIN_WEAK:
    identity_state = UNCERTAIN

elif MARGIN_WEAK <= reid_margin < MARGIN_STRONG:
    ReID 只提供弱确认信号，仍需位置连续 + 多帧稳定

else:
    ReID 提供较强身份确认信号，但仍不能绕过位置、运动和尺寸约束
```

```text
第二层：融合评分
```

示例权重可调整为：

```text
match_score =
  0.25 * reid_confidence
+ 0.25 * position_score
+ 0.20 * motion_score
+ 0.10 * size_score
+ 0.10 * color_score
+ 0.10 * confidence_score
```

当 ReID 未接入或 `reid_margin` 过弱时，系统应自动退化为：

```text
match_score =
  0.35 * position_score
+ 0.20 * motion_score
+ 0.15 * size_score
+ 0.20 * color_score
+ 0.10 * confidence_score
```

---

因此，首版更推荐把 ReID 理解为：

> 身份置信度与身份门控信号，而不是身份判决器。

### 5.3 ReID 运行策略

不建议每帧、每个候选都跑 ReID。推荐事件触发：

| 场景 | ReID 策略 |
| --- | --- |
| 初始化 / 确认 | 建立最小种子记忆与 `confirmedGallery`，不要求一次性完成完整大容量 gallery |
| 正常 FOLLOW | 低频运行，例如每 5-10 帧确认一次 |
| 多人靠近 / 交叉 | 对候选人运行 ReID |
| 目标丢失后重现 | 对所有 person 候选运行 ReID |
| ReID 模型不可用 | 自动退化到颜色 + 运动 + bbox |

其中：

- `confirmedGallery + diverse selection + margin reject` 是首版优先实现目标；
- dynamic gallery 属于后续增强，不作为第一版 ReID 接入的必要条件；
- 若未来加入动态更新，也只能在 `FOLLOW_CONFIDENT`、位置连续、无多人交叉、`reid_margin` 足够大、连续多帧稳定时触发。

---

### 5.4 三档实现路线

| 路线 | 说明 | 优先级 |
| --- | --- | --- |
| A | `ColorReIDFeatureExtractor`：颜色直方图 + ReID 接口预留 | 必做 |
| B | `AndroidReIDFeatureExtractor`：预训练轻量 ReID 模型输出 embedding，优先尝试 ONNX Runtime Mobile，TFLite 作为备选 | 推荐尝试 |
| C | 自采超市低机位、背影、遮挡数据微调 ReID | 后续增强 |

### 5.5 当前 PC 端 ReID 调研结论

截至 2026-07-07，`tools/reid_pc_test` 已经完成从人工裁剪数据到 OpenBot 自动检测框 crop 数据的首轮验证。当前最有工程指导意义的是 `images_openbot_clean` 数据集：

```text
身份数：3
总图片数：209
采集来源：OpenBot Android Person Crop Collector
模型：osnet_x0_25 + osnet_x0_25_market1501.pth
gallery 策略：diverse selection
```

本轮结果给 Android 集成提供以下结论：

- OpenBot 自动检测框 crop 比早期人工裁剪图更接近未来 App 运行时输入，也更适合作为当前判断依据；
- `osnet_x0_25` 在当前数据上仍是首版主线候选，兼顾轻量和效果；
- `confirmedGallery` 建议首版优先采用 `diverse gallery-k=8`，当前明显优于 `gallery-k=5`；
- `reid_margin = best_score - second_score` 比单纯绝对相似度更适合作为身份置信证据；
- ReID 对“目标仍在画面中时从候选人里选谁”很有帮助，但不能单独判断“目标是否真的重新出现”；
- dynamic gallery 更新方向合理，但应后置，不作为第一版 ReID 接入前提。

关键实验结果如下：

| 测试 | g5 / 基线结果 | g8 / 推荐结果 | 结论 |
| --- | ---: | ---: | --- |
| Pairwise Top-1 最近邻身份正确率 | - | `0.990` | 真实 crop 上 identity embedding 有明显可用性 |
| Gallery-Probe 强制识别准确率 | `0.840` | `0.876` | `gallery-k=8` 优于 `gallery-k=5` |
| Target-present 强制选择目标准确率 | `0.767` | `0.843` | g8 更适合跟随场景候选排序 |
| Target-present `margin>=0.05` accepted accuracy | `0.879` | `0.957` | margin 可作为较强身份置信证据 |
| Target-absent `margin>=0.05` false accept rate | `0.457` | `0.457` | 单靠 margin 无法可靠拒绝目标缺席 |
| Target-absent `margin>=0.10` false accept rate | `0.194` | `0.184` | 提高阈值仍不能消除误接收 |

因此，阶段 3 的重点已经从“证明 ReID 是否有用”转为：

```text
把 osnet_x0_25 + diverse confirmedGallery(k=8)
  ↓
接入 TargetMemory / TargetMatcher / FollowStateMachine
  ↓
与位置连续性、bbox 尺寸、运动趋势、连续多帧稳定性融合
  ↓
在身份不确定或目标缺席风险高时进入 IDENTITY_UNCERTAIN / STOP
```

正式部署 Android ReID 前，下一步不应继续单纯追模型分数，而应先完成运行时接口设计：`ReIDFeatureExtractor`、`ReIDGallery`、`TargetMatcher`、`TargetMemory` 与状态机之间的数据结构和门控逻辑。

### 5.6 ReID 失败 / 不确定时的处理

若出现以下情况，系统不得仅凭 ReID 恢复 `FOLLOW`：

- `best_score` 和 `second_score` 接近，`reid_margin` 过小；
- 多个候选人与目标 gallery 相似度都较高；
- 目标刚从 `LOST` 状态恢复，但位置跳变过大；
- 当前候选与目标 gallery 相似，但运动轨迹与上一帧目标不连续；
- 画面中存在多人交叉、遮挡或检测框明显不稳定。

处理策略：

- 正常 `FOLLOW` 中：降级为 `FOLLOW_CAUTION`，降低速度或停止前进；
- `REACQUIRE_TARGET` 中：继续等待，不进入 `READY_TO_FOLLOW`；
- `LOST / SEARCH` 中：不把路人当作目标恢复跟随；
- 超时后进入 `STOP` 或要求用户重新确认。

---

## 6. 跟随距离估计与控制

### 6.1 问题定义

当前“跟踪距离过大”的原因通常不是目标身份问题，而是距离控制问题。此前计划中默认采用“多特征线性融合距离代理”：

```text
target_distance_proxy =
  w1 * bbox_height_proxy
+ w2 * bbox_area_proxy
+ w3 * bbox_bottom_proxy
+ w4 * monocular_depth_proxy
+ w5 * temporal_prediction
```

这条路线的问题不是单纯“参数还没调好”，而是它容易陷入：

- 缺乏稳定物理尺度来源；
- 可解释性弱，距离不对时很难定位到底是哪一路出了问题；
- 若想真正学权重，就需要大量带真实距离标注的数据；
- 对首版课程原型而言，调参与验证成本偏高。

因此，距离控制的主方案需要从“估计一个连续距离值”转向“保持初始化时的期望图像尺度”。

若只用检测框高度或面积作为远近代理，则会受到以下因素影响：

- 用户身高差异；
- 相机俯仰角；
- 目标只露出上半身；
- 顾客蹲下、侧身或坐下；
- 下半身被货架、购物筐或路人遮挡；
- 手机持握或安装角度变化。

因此距离估计不能只依赖单一特征，应采用多线索融合和置信度判断。

---

### 6.2 首版核心思想：Distance State + Image-based Visual Servoing

购物车真正需要解决的问题不是：

```text
用户现在离我 0.94 m 还是 1.03 m？
```

而是：

```text
用户是不是比期望状态更远了？
我现在应该前进、停止，还是因为不确定而等待？
```

因此系统内部更适合输出：

```text
TOO_FAR
OK
TOO_CLOSE
UNKNOWN
```

而不是把“米制距离”当作首版主目标。

这对应经典的 Image-based Visual Servoing（IBVS）思想：

> 控制机器人，使目标保持在图像中的期望位置和尺度，而不是先恢复完整三维世界坐标。

对购物车来说，更适合被控制的是：

- `bbox_height_ratio`
- `bbox_area_ratio`
- `bbox_bottom_ratio`
- 目标在画面中的相对位置

本质上，距离控制可以理解为：

> 保持目标的图像尺度接近初始化时记录下来的 setpoint。

### 6.3 推荐主方案：初始化距离标定 + 图像尺度保持

初始化阶段，在用户站在期望跟随距离时，系统记录：

```text
desired_bbox_height_ratio
desired_bbox_area_ratio
desired_bbox_bottom_ratio
(optional) desired_depth_proxy
```

这里记录的是：

```text
期望图像尺度
```

不是：

```text
真实米制距离
```

后续每帧计算类似：

```text
height_scale = current_height / desired_height
area_scale = sqrt(current_area / desired_area)
bottom_shift = current_bottom - desired_bottom
```

系统持续比较“当前图像状态”和“初始化期望状态”，判断目标是否偏远、偏近或状态不可信。

### 6.4 Distance State 规则

可先采用解释性更强的规则式状态判断：

```text
if height_scale < far_threshold:
    TOO_FAR
elif height_scale > close_threshold:
    TOO_CLOSE
elif bbox / pose / visibility unreliable:
    UNKNOWN
else:
    OK
```

其中：

- `bbox_height_ratio` 是首版主线；
- `bbox_area_ratio` 和 `bbox_bottom_ratio` 作为辅助一致性检查；
- 若姿态异常、遮挡严重、bbox 明显失真，则直接进入 `UNKNOWN`，优先停车。

---

### 6.5 软件结构建议

建议将原来偏“多权重融合”的距离结构，改写为更清晰的估计器族：

```text
DistanceEstimator
├── ImageSetpointDistanceEstimator
├── GroundPlaneDistanceEstimator
├── MonocularDepthDistanceEstimator
├── MarkerDistanceEstimator（调试用）
└── DistanceStateFusion
```

统一输出建议为：

```text
value
state
confidence
failure_reason
```

---

### 6.6 Ground Plane Distance 作为第二阶段增强

在首版图像伺服方案跑通后，建议预留：

```text
GroundPlaneDistanceEstimator
```

它利用：

- 相机高度；
- 手机安装角度；
- 相机内参；
- 地面平面假设；
- `bbox bottom` 或脚部位置；

将图像中的底部位置映射为近似地面距离。

它的优势是更接近物理距离，并且比“纯 bbox 高度”更不依赖目标身高；但前提是脚部或 bbox 底部必须足够可信，因此更适合作为第二阶段增强，而不是首版前置依赖。

### 6.7 单目深度在距离控制中的定位

单目深度模型不是首版距离主来源。它更适合：

- 在 `ImageSetpointDistanceEstimator` 不稳定时提供辅助信息；
- 帮助判断局部遮挡、近处突起和左右空间差异；
- 在后续 `DistanceStateFusion` 中提供“支持 / 反对”信号。

不建议把单目深度直接当成首版核心距离来源，因为：

- 算力压力大；
- 多数输出仍是 relative depth；
- 一旦不准，调试成本很高。

### 6.8 距离标定

不建议一开始追求精确米制距离。更可行的是图像标定：

1. 用户站在期望跟随距离，例如 1.0 m；
2. 系统记录此时的 `desired_bbox_height_ratio`、`desired_bbox_area_ratio`、`desired_bbox_bottom_ratio` 和可选 `desired_depth_proxy`；
3. 后续跟随时努力保持这些图像比例；
4. 如果实际跟随距离过大，则调整期望尺度或 `Distance State` 阈值，而不是强行训练复杂权重。

建议目标距离仍按原计划控制在：

```text
0.8 - 1.2 m
```

但系统内部优先使用“距离状态”：

```text
TOO_FAR
OK
TOO_CLOSE
UNKNOWN
```

---

### 6.9 控制策略

控制输出应基于目标身份、距离状态和安全状态共同决定：

```text
if identity_score low:
    forward = 0
elif obstacle_risk high:
    forward = 0
elif distance_state == TOO_FAR:
    forward = positive_low_speed
elif distance_state == OK:
    forward = 0
elif distance_state == TOO_CLOSE:
    forward = 0   # 首版不主动后退
else:
    forward = 0
```

转向控制仍可使用目标中心偏差：

```text
turn = K_turn * x_error
left = forward - turn
right = forward + turn
```

首版原则：

- 不主动高速追人；
- 不主动后退；
- 不确定就停；
- 搜索时只允许原地低速扫描。

---

## 7. 避障与主动寻找路线

障碍处理不应孤立成“看到障碍就停”的模块，而应与目标方向、身份置信度、距离状态共同决定行为。推荐路线是从保守可控的本地策略开始，按手机性能和实测效果逐步增强。

### 7.1 Level 0：安全停车底线

无论后续加入多少智能策略，底线始终是：

```text
身份不确定，不前进
目标丢失，不前进
中心走廊高风险，不前进
通信异常或急停，hard STOP
```

这个层级必须在不依赖 ReID、深度模型、云端服务器的情况下成立。

### 7.2 Level 1：手机端三方向可通行空间

首版最值得实现的避障能力是 `LEFT / CENTER / RIGHT` 三方向评分：

```text
left_free_score
center_free_score
right_free_score

left_risk
center_risk
right_risk
traversability_confidence
```

它可以先基于较轻量的线索实现：

- person detector 的目标框与非目标人框；
- 画面下半部分的区域占用；
- bbox bottom、面积变化、边缘接触；
- 目标方向与最后运动趋势；
- 最近若干帧的稳定性。

该层的目标不是完美避障，而是把“只会原地停”升级为“知道哪边更可能安全”。

### 7.3 Level 2：动作走廊与局部避障

在三方向评分稳定后，引入动作走廊：

| 动作 | 关注区域 |
| --- | --- |
| `SLOW_FORWARD` | 中间前方走廊 |
| `LEFT_ARC` | 左前方弧形走廊 |
| `RIGHT_ARC` | 右前方弧形走廊 |
| `ROTATE_LEFT` | 左侧近距离旋转区域 |
| `ROTATE_RIGHT` | 右侧近距离旋转区域 |

决策层不再问“画面里有没有障碍”，而是问：

```text
如果执行这个低速动作，未来短时间内是否可能进入高风险区域？
```

这能自然支持如下行为：

- 目标在左前方，中心受阻，左侧较空：低速左弧线；
- 目标在右前方，中心受阻，右侧较空：低速右弧线；
- 目标不可见且场景不确定：`BLOCKED_WAIT` 或 `LOCAL_SEARCH`；
- 非目标行人横穿中心：停止等待，不主动抢行。

### 7.4 Level 3：单目深度与动态风险增强

如果手机性能允许，再将单目深度和光流 / TTC 近似作为增强线索。

单目深度推荐用途：

```text
target_depth_proxy
left_depth_clearance
center_depth_clearance
right_depth_clearance
near_risk_map
depth_confidence
```

动态风险推荐用途：

```text
left_motion_risk
center_motion_risk
right_motion_risk
time_to_collision_proxy
```

注意：这些能力只提高风险判断质量，不直接绕过安全状态机。若深度、bbox、检测框之间互相矛盾，应降低整体置信度，而不是让某一个模型单独决定动作。

### 7.5 Level 4：云端或更高算力增强

云端服务器可以作为“看远一点”的后续方向，但必须明确边界：

- 可以用于离线日志分析、模型效果对比、参数搜索、复杂场景复盘；
- 可以用于演示模式下的高质量语义理解或场景标注；
- 不应作为急停、近距离避障、实时身份确认的唯一依据；
- 网络延迟、断连、隐私合规和图像上传成本都会影响工程可靠性。

如果未来确实接入云端，推荐架构是：

```text
手机端实时安全闭环
  +
云端非实时分析 / 策略建议 / 日志复盘
```

而不是：

```text
手机端等待云端决定是否停车
```

### 7.6 外接传感器的关系

外接 ToF、超声波、碰撞开关不取代手机主脑，只作为近距离安全冗余：

| 传感器 | 用途 |
| --- | --- |
| ToF | 近距离障碍停车 |
| 超声波 | 前方距离阈值判断 |
| 碰撞开关 | 最后物理防线 |

这些信号进入 `SystemSafetyEvidence`，并在优先级上高于普通视觉绕行建议。

---

## 8. 安全状态机升级

状态机的核心不再是简单的 `FOLLOW / LOST / STOP`。但第一版也不应把每一种局部动作都做成长期状态，否则状态转移会迅速复杂化。

第一版推荐拆成两层：

```text
FollowStateMachine：管理身份与任务阶段
ActionArbitrator：管理本帧动作选择
```

### 8.1 FollowStateMachine 核心状态

第一版状态层建议保留：

```text
IDLE
CAPTURE_TARGET
LOCKED_PENDING_CONFIRM
CONFIRMED_ARMED
REACQUIRE_TARGET
READY_TO_FOLLOW
FOLLOW_CONFIDENT
FOLLOW_CAUTION
IDENTITY_UNCERTAIN
LOST
REACQUIRE_TARGET
STOP
EMERGENCY
```

其中：

| 状态 | 说明 | 运动策略 |
| --- | --- | --- |
| `FOLLOW_CONFIDENT` | 身份明确、距离正常、安全风险低 | 允许低速跟随 |
| `FOLLOW_CAUTION` | 身份基本明确，但距离、空间或风险判断置信度下降 | 限速 / 减速 |
| `IDENTITY_UNCERTAIN` | 多人分数接近、ReID 不确定、遮挡严重 | `motion_stop`，不切换目标，不继续前进 |
| `LOST` | 目标暂时丢失 | 立即取消线速度，停止前进 |
| `REACQUIRE_TARGET` | 重新看到疑似目标 | 多帧 ReID + bbox + prediction 稳定后恢复 FOLLOW |
| `STOP` | 搜索失败、风险过高或安全异常 | hard STOP，等待重新初始化或人工确认 |
| `EMERGENCY` | 急停或严重异常 | 停止，人工复位 |

`TARGET_OCCLUDED` 可以先不作为独立长期状态，而是作为 `LOST / IDENTITY_UNCERTAIN / REACQUIRE_TARGET` 中的 `action_reason` 或 `safety_block_reason`。等真实场景中确实需要单独处理遮挡等待，再升级为状态。

---

### 8.2 BehaviorAction 动作层

动作层表达本帧实际要做什么：

| 动作 | 含义 |
| --- | --- |
| `FOLLOW_SLOW` | 低速前进跟随 |
| `FOLLOW_CAUTION` | 更低速谨慎跟随 |
| `MOTION_STOP` | 线速度清零，但不进入 hard STOP |
| `LOCAL_SEARCH_LEFT` | 原地低速左转搜索 |
| `LOCAL_SEARCH_RIGHT` | 原地低速右转搜索 |
| `LEFT_ARC` | 目标与左侧空间都支持时低速左弧线 |
| `RIGHT_ARC` | 目标与右侧空间都支持时低速右弧线 |
| `BLOCKED_WAIT` | 空间风险高或信息矛盾，停止等待 |
| `REACQUIRE_HOLD` | 疑似目标出现，暂停并多帧确认 |
| `HARD_STOP` | 搜索失败或需要人工重新确认 |
| `EMERGENCY_STOP` | 急停或严重安全异常 |

这样 `AVOID_LEFT / AVOID_RIGHT / BLOCKED_WAIT` 不必一开始都进入状态机，而是先作为动作层结果。状态机负责“现在处于什么任务阶段”，动作仲裁器负责“这一帧怎么动”。

### 8.3 安全优先级

第一版动作仲裁的硬优先级建议为：

```text
EMERGENCY_STOP
  > HARD_STOP
  > BLOCKED_WAIT
  > MOTION_STOP / REACQUIRE_HOLD
  > LOCAL_SEARCH_LEFT / LOCAL_SEARCH_RIGHT
  > LEFT_ARC / RIGHT_ARC
  > FOLLOW_CAUTION
  > FOLLOW_SLOW
```

只要身份、空间或系统安全证据不可靠，`ControlGenerator` 就不允许输出前进线速度。允许的主动性主要来自两个方向：

1. 线速度为 0 的原地搜索；
2. 身份明确、空间可通行且低速限幅下的局部弧线动作。

### 8.4 状态机与避障的统一

`LOCAL_SEARCH_LEFT / RIGHT`、`BLOCKED_WAIT`、`REACQUIRE_HOLD` 不应被看成 ReID 专属逻辑，也不应被看成避障专属逻辑。它们都是不确定状态下的安全行为。

典型例子：

| 场景 | 推荐状态 | 推荐动作 |
| --- | --- |
| 目标从画面左侧消失，周围空间安全 | `LOST` | `LOCAL_SEARCH_LEFT` |
| 目标被非目标行人挡住 | `LOST` 或 `IDENTITY_UNCERTAIN` | `BLOCKED_WAIT` |
| 中间有障碍，目标在左侧且左侧可通行 | `FOLLOW_CAUTION` | `LEFT_ARC` |
| 目标重新出现但身份分数一般 | `REACQUIRE_TARGET` | `REACQUIRE_HOLD` |
| 场景风险高、通信异常或搜索超时 | `STOP` / `EMERGENCY` | `HARD_STOP` / `EMERGENCY_STOP` |

这也是后续让小车“更积极”而不牺牲安全的关键。

---

## 9. Human Cart Simulator 升级

Human Cart Simulator 是下一阶段最重要的验证平台。它不只是“无底盘提示器”，而应成为行为决策层的可视化调试台。

### 9.1 显示内容

在原有目标框、状态和控制量基础上，显示证据、状态、动作和原因：

```text
identity_score
reid_score / reid_margin
tracking_score
distance_state / distance_score
left_free_score / center_free_score / right_free_score
left_risk / center_risk / right_risk
behavior_state
selected_action
action_reason
safety_block_reason
```

屏幕上应显示：

- 当前状态；
- 当前目标框；
- 普通行人框；
- ReID / match 分数与是否启用 ReID；
- 跟随距离状态；
- 左 / 中 / 右可通行评分；
- 大号动作提示；
- FPS / 推理耗时 / 是否降级；
- 当前动作为什么被选择；
- 哪条安全规则阻止了前进。

---

### 9.2 动作提示语义

大号提示优先级：

| 状态 | 提示 |
| --- | --- |
| 身份未确认 | `目标未确认，请不要移动` |
| 身份不确定 | `目标不确定，请停止` |
| 目标太远且安全 | `向前慢走` |
| 目标偏左且左侧可通行 | `向前并左转` 或 `左弧线` |
| 目标偏右且右侧可通行 | `向前并右转` 或 `右弧线` |
| 目标太近 | `停止` |
| 中间受阻 | `前方受阻，等待` 或 `低速绕行` |
| 目标丢失 | `目标丢失，停止前进` |
| 搜索 | `原地左转搜索` / `原地右转搜索` |
| 目标重现 | `疑似目标，等待确认` |
| hard STOP | `已安全停止，请人工确认` |

---

### 9.3 Human Cart Simulator 验收场景

| 场景 | 观察重点 |
| --- | --- |
| 单人远离 | 是否提示向前 |
| 单人靠近 | 是否提示停止 |
| 目标偏左 / 偏右 | 转向提示是否正确 |
| 路人穿过 | 是否保持目标，不切换 |
| 目标蹲下 | 是否降低置信度或进入 caution |
| 目标被遮挡 | 是否停止前进并进入 LOST |
| 目标重新出现 | 是否用 ReID / 颜色 / 运动重新识别 |
| 画面前方出现近物 | 是否进入 `BLOCKED_WAIT` 或低速绕行 |
| 目标从左侧离开 | 是否优先左侧 `LOCAL_SEARCH` |
| 目标绕过障碍 | 是否在可通行方向给出低速弧线动作 |
| 多人接近且分数接近 | 是否停止前进而不是切换目标 |

---

## 10. 控制输出策略

### 10.1 OpenBot 兼容输出

首版仍保持 OpenBot 兼容控制方式：

- 上位机只输出 `Control(left, right)`；
- Android 端不处理四驱、麦轮和 AT8236 细节；
- 下位机负责左右轮到四电机的映射。

---

### 10.2 控制输入

`ControlGenerator` 不应只接收目标 bbox，而应接收综合感知结果：

```text
BehaviorAction
TargetMotionHint
DistanceEvidence
TraversabilityEvidence
SystemSafetyEvidence
```

---

### 10.3 动作到控制的映射

建议先把高层动作映射为 OpenBot 兼容控制量：

```text
FOLLOW_SLOW:
    Control(+v_low, +v_low)

FOLLOW_CAUTION:
    Control(+v_very_low, +v_very_low)

LEFT_ARC:
    Control(+v_inner, +v_outer)

RIGHT_ARC:
    Control(+v_outer, +v_inner)

LOCAL_SEARCH_LEFT:
    Control(-turn_low, +turn_low)

LOCAL_SEARCH_RIGHT:
    Control(+turn_low, -turn_low)

MOTION_STOP / BLOCKED_WAIT / REACQUIRE_HOLD / HARD_STOP / EMERGENCY_STOP:
    Control(0, 0)
```

其中 `LEFT_ARC / RIGHT_ARC` 必须满足：

- 目标身份稳定；
- 对应方向可通行评分足够高；
- 中心走廊风险不要求继续前进；
- 动作速度处于 very low speed；
- 任何一帧出现高置信度近距离风险，立即回到 `MOTION_STOP` 或 `BLOCKED_WAIT`。

### 10.4 控制规则

```text
if emergency:
    Control(0, 0)

else if hard_stop:
    Control(0, 0)

else if identity_uncertain:
    Control(0, 0)

else if blocked_wait:
    Control(0, 0)

else if search:
    Control(±turn_low, ∓turn_low)

else if avoid_left / avoid_right:
    低速弧线，持续检查对应方向风险

else if follow_confident / follow_caution:
    根据距离状态计算 forward
    根据目标中心偏差计算 turn
    限幅后输出 left/right
```

控制层不负责决定是否“值得冒险”。这个判断必须在 `BehaviorDecision / SafetyFusion` 完成。

---

## 11. 开发顺序建议

不按天划分，而按风险消除顺序推进。当前不建议继续把主要时间投入到 PC 端 ReID 模型替换；PC 端应转为回归测试和离线分析工具，Android Human Cart Simulator 应成为下一阶段主验证平台。

### 11.1 计划收口说明

当前上位机相关计划文档分为三层：

- 本文档：总计划，负责统一主线、阶段顺序、模块边界和首版收敛口径；
- [上位机软件开发 Phase 2——修正跟随距离控制计划书](E:/THU/2026Summer/AutoFollowShoppingCart/design/上位机软件开发%20Phase%202——修正跟随距离控制计划书.md)：距离控制专项细化，负责解释为什么主线改为“初始化标定 + 图像伺服”；
- [障碍处理计划书](E:/THU/2026Summer/AutoFollowShoppingCart/design/障碍处理计划书.md)：障碍处理专项细化，负责展开“左 / 中 / 右可通行空间 + 跟随式局部避障”。

这三份文档不是三套并列方案，而是：

```text
总计划负责收口
专项计划负责展开
```

若专项计划与总计划出现冲突，应优先回写总计划，保持统一口径。

### 阶段 A：Human Cart Simulator 行为决策层

目标：

- 在 Android 端建立 `Evidence → BehaviorDecisionResult → BehaviorAction → HumanCommand` 的最小闭环；
- 第一轮不接真实 ReID、不接单目深度、不做复杂避障；
- 先用现有检测、目标匹配和启发式默认值填充证据；
- 在 Human Cart Simulator 中实时显示动作、原因、阻止前进的安全规则。

#### A1：先定义数据结构，不改变行为

先新增或整理这些结构：

```text
IdentityEvidence
DistanceEvidence
TraversabilityEvidence
SystemSafetyEvidence
BehaviorAction
BehaviorDecisionResult
```

最小字段可以先这样填：

```text
identity_confidence = 当前 TargetMatcher 分数或跟踪置信度
distance_state = UNKNOWN
center_free_score = 1.0
left_free_score = 1.0
right_free_score = 1.0
system_safety = ok
selected_action = 由旧 ControlGenerator 或旧提示逻辑推导
```

目标是先让日志和 UI 能看到统一结构，而不是立刻改变车辆行为。

#### A2：实现 ActionArbitrator 的硬优先级

先只实现最硬的规则：

```text
emergency              → EMERGENCY_STOP
hard_stop_required     → HARD_STOP
identity_uncertain     → MOTION_STOP
target_lost_left       → LOCAL_SEARCH_LEFT
target_lost_right      → LOCAL_SEARCH_RIGHT
target_lost_unknown    → MOTION_STOP
center_blocked         → BLOCKED_WAIT
else                   → FOLLOW_SLOW / FOLLOW_CAUTION
```

这一版不追求聪明，只追求链路清楚、优先级稳定、不会在不确定时继续前进。

#### A3：Human Cart Simulator 显示决策原因

每一帧至少显示：

```text
selected_action
action_reason
safety_block_reason
```

示例：

```text
selected_action = MOTION_STOP
action_reason = identity_margin_too_low

selected_action = LOCAL_SEARCH_LEFT
action_reason = target_lost_left_side

selected_action = FOLLOW_SLOW
action_reason = identity_ok_distance_far_center_clear
```

这是后续调参和排查“为什么小车不动 / 为什么小车想动”的关键。

#### A4：再接 DistanceEvidence 和 TraversabilityEvidence

最后再把距离状态和三方向可通行评分接进来：

- `DistanceEvidence` 先输出 `TOO_FAR / OK / TOO_CLOSE / UNKNOWN`；
- `TraversabilityEvidence` 先输出 `LEFT / CENTER / RIGHT` 的简版 free score；
- 只有当身份可信、距离需要前进、对应方向可通行时，才允许 `FOLLOW_SLOW / LEFT_ARC / RIGHT_ARC`。

验收重点：

- 目标丢失后不继续前进；
- 目标返回后不必直接 hard STOP，而是能进入 `REACQUIRE`；
- 多人混淆时不切换目标；
- 前方风险升高时停止或等待；
- 动作原因在 UI 上可解释。

---

### 阶段 B：Android 端 ReID 作为行为证据接入

目标：

- 接入轻量 ReID 推理，优先使用已经在 PC 端验证过的 `osnet_x0_25` 路线；
- ReID 低频或事件触发运行，不强行每帧推理；
- 将 `reid_score / reid_margin / gallery_stability` 写入 `IdentityEvidence`；
- 与 bbox 连续性、颜色、尺寸、检测置信度融合，而不是替代它们。

实现顺序：

1. 先保证阶段 A 的 `BehaviorAction + Evidence + UI` 已经可运行；
2. 再接 `ReIDFeatureExtractor`，先只打印推理耗时和分数；
3. 再把 `reid_score / reid_margin` 放入 `IdentityEvidence`；
4. 最后观察 `ActionArbitrator` 是否正确响应身份不确定、多人接近和重捕获场景。

首版 ReID 只建议在三个场景运行：

| 场景 | ReID 用途 |
| --- | --- |
| 初始化确认后 | 提取目标 gallery |
| 多人接近或候选分数接近 | 低频计算候选 ReID，帮助保持目标 |
| `REACQUIRE_TARGET` | 计算疑似目标 ReID，辅助多帧重捕获 |

不建议第一版每帧跑 ReID。每帧 ReID 容易压垮手机性能，也容易让系统误以为“分数就是决策”。

验收重点：

- ReID 接入后手机 FPS 和延迟仍可接受；
- 多人接近时身份分数能帮助保持目标；
- 目标缺席时不会因单帧高分误恢复；
- 目标重现时能在 `motion_stop` 边界内更积极重捕获。

---

### 阶段 C：目标轨迹与身份信念层改造

目标：

- 在 Android Human Cart Simulator 中新增轻量 `TargetTrackManager`，将连续 person bbox 关联为短时 track；
- 在 ReID 与状态机之间新增 `IdentityBeliefAccumulator`，对每个 track 累计目标身份信念；
- 将恢复跟随的条件从“单帧候选满足 ReID / bbox gate”升级为“稳定 track + 稳定 belief + 多帧证据”；
- 在 debug 面板显示 `trackId / lockedTrackId / targetBelief / trackAge / missedFrames / beliefReason`。

首版边界：

- 不做复杂多目标跟踪，不引入 DeepSORT / ByteTrack 等完整跟踪框架；
- 不做 dynamic gallery 更新，避免错误样本污染目标记忆；
- 不改变真实底盘控制输出，仍先在 Human Cart Simulator 中验证；
- ReID 继续作为身份强证据之一，但不能单独恢复 `FOLLOW`。

验收重点：

- 单人正常跟随时，锁定目标的 `trackId` 应稳定，`targetBelief` 应逐步升高；
- 目标离开后，系统进入 `motion_stop / LOCAL_SEARCH / IDENTITY_UNCERTAIN`，不继续前进；
- 干扰者进入时可以形成新 track，但不能凭一帧 ReID 高分抢走 locked target；
- 目标返回后，应先成为 suspected track，再经多帧 belief 稳定进入 `REACQUIRE_TARGET -> FOLLOW_CAUTION / FOLLOW_CONFIDENT`；
- debug 面板必须能解释为什么恢复、为什么停止、为什么不切换目标。

---

### 阶段 D：距离控制主线收敛

目标：

- 将距离控制收敛到“初始化标定 + 图像伺服”；
- 保存 `desired_bbox_height_ratio / desired_bbox_area_ratio / desired_bbox_bottom_ratio`；
- 输出 `TOO_FAR / OK / TOO_CLOSE / UNKNOWN`；
- 将距离证据交给行为决策层，而不是直接决定前进速度。

验收重点：

- 目标太近时优先停车；
- 目标太远但身份和空间安全时才允许慢速前进；
- 中心受阻时距离再远也不能盲目前进。

---

### 阶段 E：三方向可通行空间简版

目标：

- 先不追求复杂语义分割；
- 基于检测框、画面下半部区域、目标方向和历史稳定性输出 `LEFT / CENTER / RIGHT` free score；
- 在 Human Cart Simulator 中显示三方向评分、dominant risk source 和 suggested action。

验收重点：

- 非目标行人进入中心走廊时能降低 `center_free_score`；
- 目标在侧边且对应方向安全时能建议低速弧线；
- 信息矛盾时进入 `BLOCKED_WAIT`，不强行绕行。

---

### 阶段 F：性能评估与增强开关

目标：

- 记录 person detector、ReID、三方向评分、控制决策的耗时；
- 根据真实手机性能决定是否启用更高频 ReID、单目深度、光流 / TTC；
- 将所有增强能力做成可关闭开关，并保留降级路径。

验收重点：

- 关闭 ReID / 深度后系统仍能安全降级；
- 性能下降时优先降频，不牺牲安全状态机；
- UI 显示当前是否处于 degraded mode。

---

### 阶段 G：低速真实底盘联调

目标：

- 将 `Control(left,right)` 接到底盘
- 验证真实车速、转向半径、延迟和惯性
- 重新标定跟随距离与速度上限
- 先只开放 `FOLLOW_SLOW / MOTION_STOP / LOCAL_SEARCH / BLOCKED_WAIT`
- 再逐步开放 `LEFT_ARC / RIGHT_ARC`
- 接入 ToF / 超声波等安全冗余（若视觉不足）

验收重点：

- 任意不确定状态线速度清零；
- 目标丢失后不继续前进；
- 局部绕行动作足够慢，且可被任意高风险信号打断；
- 急停和通信异常优先级最高。

### 阶段 H：高级避障与云端增强评估

该阶段不是首版必做项，只在基础闭环稳定且手机性能或网络条件允许时启动。

可评估方向：

- 单目深度风险热力图；
- 光流 / TTC 动态接近风险；
- 更细粒度动作走廊；
- 云端离线日志复盘和参数推荐；
- 云端复杂场景标注或模型评估。

边界：

- 不让云端参与急停和近距离实时避障；
- 不把高级模型设为首版必需依赖；
- 所有增强必须能被关闭，并回退到本地安全闭环。

---

## 12. 首版验收口径

### 12.1 无底盘阶段验收

| 验收项 | 标准 |
| --- | --- |
| 目标初始化 | 完成采集、截图、确认、重识别、倒计时 |
| 目标身份保持 | 多人干扰时不轻易切换目标 |
| 目标重识别 | 短时遮挡后能重新匹配 |
| 距离控制 | 能显示并响应 `TOO_FAR / OK / TOO_CLOSE` |
| Human Cart Simulator | 能实时提示前进、转向、停止、搜索 |
| 安全状态机 | 目标丢失、身份不确定、障碍风险时停止前进 |
| 日志记录 | 能记录状态、分数、控制量、FPS |

---

### 12.2 有底盘阶段验收

| 验收项 | 标准 |
| --- | --- |
| 单人跟随 | 0.8-1.2 m 目标距离内低速稳定跟随 |
| 多人干扰 | 路人经过不切换目标 |
| 目标遮挡 | 不盲目前进，进入 LOST / SEARCH |
| 目标重现 | 能恢复或等待确认 |
| 障碍风险 | 视觉或传感器触发减速 / 停车 |
| 急停 | 立即停车 |
| 通信异常 | 下位机超时停车 |

---

## 13. 风险与降级方案

| 风险 | 应对 | 降级 |
| --- | --- | --- |
| ReID 模型部署失败 | 保留接口，先用颜色 + 运动匹配 | 不影响首版运行 |
| ReID 导致手机性能下降 | 事件触发或低频运行，必要时关闭 | 回退到 bbox + 颜色 + 运动连续性 |
| 单目深度太慢 | 低频运行或关闭 | 退化为 bbox 距离控制 |
| ARCore 不可用 | 不作为主线 | 不影响设计 |
| bbox 距离估计不稳 | 加入标定、平滑和深度辅助 | 降速 / 停止 |
| 手机视觉障碍判断不可靠 | 降级为 `BLOCKED_WAIT`，不做绕行 | 外接 ToF / 超声波 |
| 三方向可通行评分误判 | 绕行动作限速并持续复评 | 只保留停止/等待 |
| 云端链路延迟或断连 | 云端只做非实时分析 | 手机端本地安全闭环独立运行 |
| 图像上传带来隐私风险 | 默认不上传实时画面 | 只上传脱敏日志或离线样例 |
| 身份分数接近 | 进入 `IDENTITY_UNCERTAIN` | 停车并提示重新确认 |
| 目标被长时间遮挡 | 搜索超时 | STOP 等待人工干预 |
| `tools/` 中直接 clone 上游仓库 | 移除内部 `.git` 后转为普通目录，避免嵌套仓库干扰协作 | 后续补充来源说明并忽略大文件产物 |
| ReID 研究目录含私人照片 | 默认不提交 `images/` 与 `outputs/`，并在仓库规则中显式忽略 | 仅保留代码、文档和必要说明 |

---

## 14. 当前最建议的下一步

阶段 A 的行为层闭环和阶段 B 的 Android TFLite ReID 首版接入已经完成实机验证。当前不建议继续单纯调高 `bestScore / margin` 阈值，也不建议直接进入真实底盘控制。

下一步主线应是阶段 C：

```text
Detector persons
  ↓
TargetTrackManager
  ↓
ReIDCoordinator
  ↓
IdentityBeliefAccumulator
  ↓
FollowStateMachine
  ↓
ActionArbitrator
  ↓
HumanCommand
```

目标是解决两个实机暴露的问题：

| 问题 | 阶段 C 的解决方向 |
| --- | --- |
| 目标离开后偶尔跟错干扰者 | locked track 保护 + belief 累计 + 候选切换惩罚 |
| 目标返回后重捕获慢或无法确认 | suspected track + 多帧中等 ReID / bbox / prediction 证据恢复 |

阶段 C 的最小验收标准：

| 场景 | 预期 |
| --- | --- |
| 单人正常跟随 | `trackId` 稳定，`targetBelief` 上升，action 为 `FOLLOW_SLOW / FOLLOW_CAUTION` |
| 目标离开 | 取消线速度，进入 `LOCAL_SEARCH / IDENTITY_UNCERTAIN`，不 hard STOP 过早 |
| 目标离开后干扰者进入 | 干扰者可形成新 track，但不能快速获得恢复 `FOLLOW` 的 belief |
| 目标返回 | 先标记 suspected track，经连续稳定后恢复 `REACQUIRE_TARGET -> FOLLOW` |
| 目标在场且干扰者穿越 | locked target 不被一帧高分抢走，必要时进入 `FOLLOW_CAUTION / IDENTITY_UNCERTAIN` |

阶段 C 完成后，再继续距离控制收敛、三方向可通行空间、性能增强和真实底盘联调。

---

## 15. 结论

上位机方向的核心应从“能不能识别人”升级为：

> 能否把身份、距离、局部空间、系统安全和历史状态融合起来，安全但主动地决定购物车下一步动作。

首版最重要的不是追求复杂避障或云端智能，而是建立一个可靠的行为决策框架：

```text
证据可解释
状态可观察
动作可限速
不确定不前进
停止后仍能本地搜索和重捕获
风险升高立即 hard STOP
```

在这个框架下，ReID、单目深度、光流、外接传感器和云端分析都可以逐步成为增强证据；即使其中任一模块不可用，系统仍应保留本地、低速、安全、可演示的跟随闭环。

---

## 16. 2026-07-08 最新进度与路线修正

### 16.1 已完成进展

阶段 A 与阶段 B 的首版 Android 验证已经完成到“可实机观察”的程度：

- Human Cart Simulator 已接入 `BehaviorAction / BehaviorDecisionResult / ActionArbitrator`，debug 面板能够解释 `selected_action / action_reason / safety_block_reason`。
- Android 端已接入 TFLite ReID 推理链路，首版使用 `osnet_x0_25_market1501.tflite`。
- `.pth -> legacy ONNX -> TFLite` 转换链路已跑通，生成的 TFLite 模型输入为 `[1,3,256,128]`，输出为 `[1,512]`。
- 最新 debug APK 已构建并安装到手机；ReID 成功运行，实测 Human Cart Simulator 帧率约 30 FPS，说明当前手机仍有一定性能余量。
- debug 面板中的 `reidAvailable / gallerySize / bestScore / margin / stableMatchCount / bbox gate` 等字段已可用于实机观察。

TFLite 模型属于本地测试资产，不提交到版本库；`*.tflite`、`weights/`、`images/`、`outputs/` 仍保持忽略。

### 16.2 当前实机暴露的问题

实机反馈表明，当前系统已经能用 ReID 作为身份线索，但还不能保证“稳定跟住同一个目标人”：

1. 目标离开或多人靠近时，系统仍可能把干扰者识别为目标，并出现跟错人的风险。
2. 目标重新回到画面时，重捕获有时偏慢，甚至无法及时确认目标。
3. ReID 分数、margin 与 bbox 连续性都有效，但单帧证据仍不足以承担“切换目标 / 恢复跟随”的最终决定。

因此，下一阶段不应继续只调 `bestScore / margin` 阈值，而应把系统从“每帧选最像的人”升级为“持续维护目标轨迹和身份信念”。

### 16.3 下一步核心方向：TargetTrack + IdentityBelief

建议在 ReID 与状态机之间新增轻量目标轨迹与身份信念层：

```text
Detector persons
  -> TargetTrackManager
  -> IdentityBeliefAccumulator
  -> FollowStateMachine
  -> ActionArbitrator
  -> Human command
```

`TargetTrackManager` 的职责：

- 将连续多帧中位置、尺寸、运动方向相近的 person bbox 归并为短时 track。
- 给每个 track 分配临时 `trackId`。
- 记录最近 bbox、速度方向、丢失帧数、是否贴边、是否位于最后目标预测区域。

`IdentityBeliefAccumulator` 的职责：

- 对每个 track 维护 `target_belief`，而不是只看单帧 ReID 分数。
- ReID strong/mid、bbox 连续、预测区域命中、与最后目标位置一致时加分。
- 候选切换、bbox 大跳变、面积突变、ReID margin 低、多人混淆时扣分。
- 只有 belief 连续超过阈值，才允许进入 `REACQUIRE_TARGET` 并最终恢复 `FOLLOW`。

关键原则：

- 已锁定目标时，不因干扰者一帧 ReID 高分而切换目标。
- 目标丢失后，可以更积极地原地搜索和提高 ReID 频率，但线速度保持 0。
- 目标返回后，允许先标记为“疑似目标”，再通过多帧稳定证据恢复跟随。
- `FOLLOW`、`FOLLOW_CAUTION`、`IDENTITY_UNCERTAIN`、`REACQUIRE_TARGET` 应由累计信念驱动，而不是由单帧候选直接驱动。

### 16.4 后续优先级

当前建议的开发顺序调整为：

1. 在 Human Cart Simulator 中实现 `TargetTrackManager`，先只做 bbox IoU / center distance / area ratio 的短时关联。
2. 增加 `IdentityBelief`，把 ReID、bbox 连续性、prediction、候选切换次数累积为稳定分数。
3. 改造 `FollowStateMachine` 的恢复逻辑，使 `LOST / SEARCH / IDENTITY_UNCERTAIN` 只接受“稳定 track + 稳定 belief”的重捕获证据。
4. 在 debug 面板显示 `trackId / targetBelief / trackAge / missedFrames / beliefReason`。
5. 实机重复验证：目标离开、干扰者进入、目标返回、目标在场干扰者穿越、遮挡。

只有当上述链路稳定后，再考虑进一步压榨 ReID 频率、加入更复杂局部避障或云端离线分析。

### 16.5 阶段 C 首版代码接入状态

阶段 C 的 Android 首版实现已经进入 `dev/OpenBot/android`：

- 新增轻量 `TargetTrack / TargetTrackManager`，用 bbox IoU、中心距离和面积比例维护短时 `trackId`。
- 新增 `IdentityBelief / IdentityBeliefAccumulator`，对每条 track 累计 `targetBelief`。
- `HumanCartSimulatorFragment` 每帧先更新 tracks，再将 ReID 单帧结果转换为带 belief 的 `IdentityEvidence`。
- 用户确认目标时锁定 `lockedTrackId`，后续干扰者不能凭单帧 ReID 高分直接抢走目标。
- `FollowStateMachine` 在有 belief 时优先用 `targetBelief + beliefStableFrames + bbox/prediction/lockedTrack` 驱动 `FOLLOW / FOLLOW_CAUTION / REACQUIRE_TARGET / IDENTITY_UNCERTAIN`。
- Debug 面板与 overlay 已加入 `trackId / lockedTrackId / suspectedTrackId / targetBelief / trackAge / missedFrames / beliefReason`。

构建验证：

```powershell
$env:JAVA_HOME='D:\Java\jdk-17'
$env:Path="$env:JAVA_HOME\bin;$env:Path"
.\gradlew.bat :robot:assembleDebug
```

结果：构建通过。

下一步不是继续写新架构，而是安装最新 APK 进行阶段 C 手机验收。重点检查：

1. 单人正常跟随时 `trackId` 是否稳定、`targetBelief` 是否上升。
2. 目标离开后是否取消前进并保持 locked target 记忆。
3. 干扰者进入时是否形成新 track 但不能快速恢复 `FOLLOW`。
4. 目标返回时是否先进入 suspected/reacquire，再恢复 `FOLLOW_CAUTION / FOLLOW_CONFIDENT`。
5. Debug 面板是否能解释恢复、停止和拒绝切换的原因。

### 16.6 阶段 C 当前暂停点：先做诊断采集，不继续盲目调策略

最新手机测试反馈显示，阶段 C 首版仍存在两个现象：

1. 目标离开后重新回到画面时，目标经常长期保持黄框，迟迟不能重新转为绿框。
2. 少数场景下，非目标人物仍可能变成绿框。

这说明当前问题已经不能只靠“再调高或调低某个阈值”解决。继续直接改 `targetBelief`、`reid_score` 或 relock 条件，容易在两个风险之间摇摆：

```text
放松恢复条件 -> 目标回来更快转绿，但干扰者更容易抢走目标；
收紧恢复条件 -> 干扰者更难抢走目标，但真实目标回来后长期黄框。
```

因此，阶段 C 的下一步应先转为**诊断采集与可复盘调试**，而不是继续叠加策略规则。

#### 16.6.1 Human Cart Simulator 诊断事件按钮

建议在 Human Cart Simulator 中新增一个诊断按钮：

```text
默认文本：目标离开画面
可用时机：初始化阶段完成、用户确认目标后
```

交互逻辑：

```text
用户看到目标离开画面 -> 点击按钮
  记录 target_left 事件
  按钮文本变为：目标回到画面

用户看到目标回到画面 -> 再点击按钮
  记录 target_return 事件
  按钮文本变回：目标离开画面
```

该按钮不是状态机控制按钮，不直接改变 `FOLLOW / LOST / REACQUIRE` 状态，只用于给日志添加人工事件锚点。人工反应存在延迟是正常现象，后续分析时应使用 `event_tolerance_ms` 或前后若干秒窗口处理。

#### 16.6.2 诊断日志建议

Human Cart Simulator 应新增一套轻量诊断 session 输出，定位上不同于 `PersonSequenceCollector`：

```text
PersonSequenceCollector:
  记录连续检测事实，主要用于离线 sequence replay。

HumanCartSimulator diagnostic log:
  记录真实状态机、ReID、track、belief、action 决策现场证据，用于解释为什么转绿、为什么不转绿、为什么跟错。
```

建议输出目录：

```text
Pictures/cartfollow_diagnostics/<session_id>/
```

建议文件：

| 文件 | 作用 |
| --- | --- |
| `frame_log.csv` | 每个采样帧的状态、动作、FPS、人数、目标/候选 track |
| `identity_log.csv` | ReID 分数、margin、gallerySize、trackId、lockedTrackId、suspectedTrackId、targetBelief、beliefReason |
| `events.csv` | 人工事件：`target_left`、`target_return`、可选 note |
| `crops/` | 定期保存 locked/suspected/bestCandidate 的 crop |
| `gallery/` | 保存确认目标时实际进入 ReID gallery 的 crop 或缩略图 |
| `overlays/` | 可选，低频保存带框截图，用于复盘 UI 上看到的颜色和标签 |
| `session_info.json` | 记录模型、阈值、ReID 是否启用、采样间隔、手机型号等 |

建议优先保存的信息：

```text
timestamp_ms
frame_id
follow_state
selected_action
action_reason
safety_block_reason

trackId
lockedTrackId
suspectedTrackId
activeTrackCount
trackAge
missedFrames

bestScore
secondScore
margin
weakOk / midOk / strongOk
bboxDefaultOk / bboxStrictOk / predictionOk

targetBelief
beliefStableFrames
beliefUncertainFrames
beliefReason
candidateSwitchCount

crop_path_locked
crop_path_suspected
crop_path_best_reid
```

采样策略不应过重，避免拖慢预览和 ReID：

- CSV 可以每个处理帧或每 200 ms 写一次；
- crop 建议每 500 ms 或事件前后加密保存；
- overlay 建议默认关闭或 1 Hz；
- 所有写盘操作放后台线程；
- 默认仍不提交任何诊断图片、crop、gallery 或输出日志。

#### 16.6.3 UI 调试信息简化

当前左上角 debug 信息过多，已经影响正常观察画面。下一步 UI 应分为两层：

默认简洁模式只显示：

```text
FPS
state
action
trackId / lockedTrackId / suspectedTrackId
belief
bestScore / margin
```

再增加一个 `调试详情` 按钮：

```text
点击前：只显示简洁信息
点击后：展开完整 debug 面板
再次点击：收起完整 debug 面板
```

完整 debug 面板继续保留现有字段，供异常发生时截图或录屏分析。这样平时可以观察实际画面和框颜色，必要时再展开细节。

#### 16.6.4 下一步判断标准

诊断功能完成后，不应立刻继续调策略，而应先采集至少几段短日志：

1. 正常单目标跟随。
2. 目标离开后无人，再目标返回。
3. 目标离开后干扰者进入。
4. 目标在场时干扰者穿越。
5. 目标短时遮挡或局部可见。

每段日志重点回答：

```text
目标回来后为什么一直黄框？
黄框 belief 是否在升高，还是被 bbox / margin / switch penalty 压住？
非目标人物变绿前，lockedTrackId 是否已经丢失？
非目标人物转绿是 ReID 高分导致，还是 track 关联错位导致？
relock 失败是因为 belief 不够、stableFrames 不够，还是 bbox/prediction gate 不通过？
```

只有这些问题有证据后，才进入下一轮策略修正。

### 16.7 诊断闭环后的最新判断：upright ReID 已修正，下一步处理 track 与 bbox gate

阶段 C 诊断采集、ReID crop upright 修正和 PC 新旧对比分析已经完成一轮闭环。当前进度不再停留在“建议新增诊断按钮”，而是已经有了可复盘数据和初步结论。

已完成：

- Human Cart Simulator 已实现诊断 session，能记录 `frame_log.csv / identity_log.csv / events.csv / session_info.json`，并低频保存 locked/suspected/best_reid crop 与 gallery candidate。
- UI 已从默认完整 debug 改为简洁 debug + `调试详情` 展开模式。
- Android ReID 输入已修正为 upright crop，`session_info.json` 记录 `reid_crop_upright=true`。
- PC 侧 `analyze_cartfollow_diagnostics_v1.py` 已支持新旧诊断根目录对比。

新旧诊断数据对比结果：

| 数据 | target_return | recovered_rate | hard_stop_count | best_score_mean | margin_mean | bbox_default_ok_rate | gallery_candidate_landscape_rate |
|---|---:|---:|---:|---:|---:|---:|---:|
| old | 11 | 0.5455 | 2 | 0.5017 | 0.3431 | 0.4451 | 1.0000 |
| new | 16 | 0.8750 | 0 | 0.5992 | 0.4611 | 0.5485 | 0.0000 |

阶段判断：

```text
upright crop 修正有效；
Android ReID 已具备作为身份线索的基本可用性；
当前主要问题已经不是 ReID 模型是否能跑或分数是否完全不可用；
剩余瓶颈集中在 candidate switch、locked/suspected track 稳定性和 bbox gate 的状态化使用。
```

新数据中主要 blocker 为：

```text
candidate_switch_penalty: 15
belief_high_bbox_failed: 10
```

这意味着下一步策略修正应聚焦：

1. **Track association 与 locked target 保护。**  
   目标离开、返回、干扰者穿越时，不能让干扰者因为短时 ReID 高分或 bbox 接近就快速抢走 locked target。需要检查 `TargetTrackManager` 的 trackId 关联、missed frame 保留、locked track 优先级和 suspected track 迁移条件。

2. **分状态 bbox gate。**  
   `FOLLOW` 状态可以继续使用严格 bbox / prediction gate；但 `REACQUIRE_TARGET / IDENTITY_UNCERTAIN / SEARCH` 中，目标重新出现时天然会有更大的中心跳变和面积变化。如果这些状态仍使用同样严格的 gate，就会出现“belief 已经高，但黄框不转绿”。下一轮应为恢复状态设计更宽的候选 gate，再通过连续多帧稳定恢复安全性。

3. **Recoverable stop 与 hard STOP 区分。**  
   目标丢失后的 `motion_stop / SEARCH / IDENTITY_UNCERTAIN` 应继续保留重捕获机会；只有搜索超时、障碍风险、通信异常、急停或人工取消时才进入 hard `STOP`。这能避免“目标回来但系统已经不可恢复”的情况。

4. **诊断指标驱动调参。**  
   每次策略修改后继续采集 `cartfollow_diagnostics`，用 `diagnostic_return_comparison.csv` 对比 `recovered_rate / mean_ms_to_follow / candidate_switch_penalty / belief_high_bbox_failed / not_recovered_in_window`，而不是只凭肉眼看框颜色。

下一轮不建议优先做：

- 换更大的 ReID 模型；
- 继续只调 `bestScore / margin`；
- 一次性放宽所有 bbox gate；
- 直接接真实底盘验证跟随。

更稳妥的开发顺序是：

```text
Android track/bbox gate 策略小步修改
  -> Human Cart Simulator 复测
  -> 导出 cartfollow_diagnostics
  -> PC compare 分析
  -> 确认没有增加非目标转绿
  -> 再考虑接近真实底盘控制链路
```

阶段 C 后续的合格标准应改为：

| 场景 | 期望 |
|---|---|
| 目标返回 | 不长期卡黄框，能在 motion_stop 边界内进入 `REACQUIRE_TARGET / FOLLOW_CAUTION` |
| 干扰者进入 | 可形成新 track，但不能快速抢走 locked target |
| 目标在场且干扰者穿越 | 不因一帧高 ReID 分数切换目标 |
| 长时间无人 | 先 `SEARCH / IDENTITY_UNCERTAIN`，超时后 hard `STOP` |
| 策略修改后 | `candidate_switch_penalty` 与 `belief_high_bbox_failed` 应下降，非目标转绿不能增加 |

### 16.8 下一轮策略版本：track 粘性与分状态 bbox gate

本轮策略版本只处理 `candidate_switch_penalty` 和 `belief_high_bbox_failed` 两个 blocker，不扩大功能范围。默认继续使用 `osnet_x0_25 + TFLite + upright crop`，不更换模型，不启用 dynamic gallery，不全局放宽 bbox gate，不直接接真实底盘前进，也不把复杂避障提前为当前主线。

核心修改口径：

```text
loose admission
  -> suspectedTrack
  -> default confirm
  -> REACQUIRE_TARGET
  -> strict/default motion gate
  -> FOLLOW_CAUTION / FOLLOW
```

其中：

- `loose admission` 只表示“可以保留为疑似目标”，不得直接允许前进。
- `motion gate` 仍由 default / strict bbox gate、prediction、locked target 保护和多帧稳定证据共同决定。
- `belief 高但 bbox failed` 时，应解释为 `identity likely, motion not safe yet`，动作保持 `REACQUIRE_HOLD / MOTION_STOP`，不直接清空 suspected track。
- suspected track 一旦形成，需要最小滞回帧数；新候选只有在 belief 明显更高、连续稳定且旧 suspected 失效或过期时才能替换。
- locked track 在短时丢失后保留 ghost memory，用作恢复参考，但 ghost 本身不作为可运动目标。

进入真实底盘前的门槛同步调整为：

```text
非目标转绿不增加；
target_return recovered_rate 稳定不低于 0.85；
candidate_switch_penalty 明显下降；
belief_high_bbox_failed 明显下降；
MOTION_STOP / REACQUIRE_HOLD / BLOCKED_WAIT 行为稳定；
debug 能解释每次恢复、拒绝恢复和拒绝切换的原因。
```

复测仍使用 `cartfollow_diagnostics` 与 PC compare 脚本，不用肉眼观察绿框作为唯一判断依据。

### 16.9 2026-07-09 最新进展：relock、空间支持门控与日志开关已实现

截至 2026-07-09，本节 16.8 的下一轮策略已完成 Android 侧代码接入，当前状态从“待改策略”更新为“待安装新版 APK 后实测复盘”。本轮仍然不更换 ReID 模型、不启用 dynamic gallery、不全局放宽 bbox gate、不开放真实底盘前进，也不改 `ControlGenerator` 的真实底盘控制路径。

已完成的策略修正如下：

1. **恢复后 relock。**  
   目标离开后如果原目标以新的临时 `trackId` 返回，系统允许在安全恢复路径中把该 track 晋升为新的 `lockedTrackId`。晋升条件包括：非 locked track 连续通过 motion gate，并在 `FOLLOW_CAUTION / FOLLOW_SLOW` 等保守动作下稳定至少 2 帧；成功后同步调用 `IdentityBeliefAccumulator.lockTrack(newTrackId)`，清空旧 suspected，并在 debug reason 中输出 `relock_after_recovery`。

2. **非 locked track 空间支持门控。**  
   非 locked 候选不能只凭 ReID 高分进入 suspected。它必须同时满足 `bboxLoose / bboxDefault / prediction / nearLockedGhost` 中至少一个空间支持条件。若只有 ReID 高分但没有空间支持，则记录 `reid_interest_no_spatial_support` 或 `spatial_support_missing`，belief 不允许升到 caution / confirm 阈值，也不能触发 FOLLOW。

3. **identity belief 与 motion permission 继续分离。**  
   ReID 只作为身份线索；`FOLLOW / FOLLOW_CAUTION` 的运动许可仍由 default / strict bbox gate、prediction 或 locked track 保护决定。belief 高但 motion gate 失败时保持 `REACQUIRE_HOLD / MOTION_STOP`，而不是直接前进。

4. **candidate switch 计数降噪。**  
   `candidateSwitchCount` 只在真正选中、切换 suspected 或 selected track 时增长，避免“画面中观察到高分干扰者”本身就造成 candidate switch penalty 噪声。

5. **Human Cart Simulator 诊断日志开关。**  
   Simulator 底部控制区新增“记录日志”开关，默认关闭。关闭时不创建 `cartfollow_diagnostics` session，不写 `frame_log.csv / identity_log.csv / events.csv / session_info.json`，也不保存 crop、gallery 和 session_stop；开启后保持原诊断采集行为。事件按钮只在日志开启且 Confirm 后 session 激活时可用。

下一步测试口径更新为：

```text
1. 安装最新 robot debug APK。
2. 需要采集诊断时，先打开 Human Cart Simulator 的“记录日志”开关；平时调试可保持关闭。
3. 复测四段：
   - 目标离开后原目标返回；
   - 目标离开后干扰者进入；
   - 目标在场时干扰者穿越；
   - 短遮挡、蹲下或局部可见后恢复。
4. 导出新版 cartfollow_diagnostics。
5. 用 tools/reid_pc_test/analyze_cartfollow_diagnostics_v1.py --compare-roots old=...,new=... 复盘。
6. 重点检查 candidate_switch_penalty、belief_high_bbox_failed、recovered_rate、mean_ms_to_follow、非目标转绿次数、hard_stop_count 和 gallery_candidate_landscape_rate。
```

进入极低速真实底盘联调前，仍需满足：原目标返回能 relock，干扰者不能仅靠高 ReID 抬成 suspected，两个 blocker 明显下降，`recovered_rate` 不下降，非目标转绿与 hard stop 不增加，debug reason 能解释恢复、拒绝恢复和拒绝切换原因。

---

## 17. 真实底盘 BLE 联调阶段（2026-07-12）

### 17.1 当前状态

上位机已经从 Human Cart Simulator 推进到独立的 `Real Cart Follow` 模块。感知、
ReID、track/belief、距离状态和行为仲裁继续复用 Simulator 的公共管线，真实模块在
最终输出前增加 BLE 握手、前台状态、模式解锁、推理保鲜和急停安全门。

下位机新增 `ESP32 WROOM-32E -> UART -> AT8236` 的 OpenBot BLE 固件，兼容
`c/f/h`，并增加 BLE/USB 控制权、通信与运动双超时、AT8236 遥测门控和
`!S,<seq>` 锁存急停。

### 17.2 首版开放范围

- 手动：按住移动、松手停车，前进/后退/原地左右转；低速联调值为前进 14、
  后退 12、原地转向 5。
- 自动：需要长按 2 秒实验解锁；首版只输出 `14,14 / 12,14 / 14,12 / 0,0`，不倒车、不原地旋转，目标丢失时只做最多 2 秒静止重捕。
- 连接：本轮优先 BLE；USB 保持兼容但不作为真机测试前置条件。
- 日志：继续由“记录日志”开关控制，默认关闭。

### 17.3 安全声明

近场超声波/ToF 和物理急停尚未到位。当前自动模式只能用于空旷、低速、有人准备
物理断电的受控实验，不能宣称已经具备可靠避障，也不能进入货架、拥挤区域或无人
看护运行。

### 17.4 下一步验收

按照“无电机 -> 车轮悬空 -> 空载手动落地 -> 空旷自动实验”的顺序推进。任何阶段
只要出现方向错误、松手不停车、BLE 断连不停车、命令超时不停车或急停未锁存，立即
退回上一阶段，不继续自动跟随测试。

### 17.5 BLE 手动换向修复

针对真机出现的“后按方向未生效、继续旧动作”，上位机已在 OpenBot `072090f` 加入
单在途 BLE 写队列和 pointer-aware 手动仲裁。方向替换按 `c0,0 -> 新方向` 有序发送，
周期运动采用 latest-wins，旧 pointer 的迟到释放不能覆盖新方向。页面显示当前方向、
输出、BLE 写状态和构建版本。

自动化验证为 `robot` 单元测试 26/26、`checkStyle` 和 `assembleDebug` 通过。该结论只
证明上位机实现与构建通过；仍需在车轮悬空状态完成单指换向、双指抢占、旧手指迟放、
最终松手、退后台和 BLE 断开停车验收。

### 17.6 首版真实车自动跟随收口（2026-07-13）

手动遥控基本完成后，真实车自动模式沿用 Human Cart Simulator 的目标采集、人工确认、
ReID、track/belief、距离状态和行为仲裁，但不直接把连续视觉控制量发送到底盘。新增的
真实车输出整形层只允许：

```text
c14,14   持续直行
c12,14   同向差速缓弯
c14,12   同向差速缓弯
c0,0     停车
```

停车状态下必须满足可信 `FOLLOW + FOLLOW_SLOW`、`heightScale <= 0.80` 且目标连续 3 帧
居中才能起步。行驶中对横向误差做 `alpha=0.25` 的 EMA：小偏差直行，中等偏差缓弯，
偏差过大停车。直行与缓弯之间不插入停车，避免重复触发 ESP32 的实测停稳保护。

真实首版禁用运动式 `LOCAL_SEARCH`：身份不确定、目标丢失和 SEARCH 状态一律输出
`c0,0`。系统保留最多 2 秒静止重捕窗口，超时后撤销自动解锁、关闭 Start，并要求用户
重新采集和确认目标。Start 关闭、页面失焦/暂停、BLE 断开、握手丢失、推理超过
`400 ms`、中心受阻和急停同样立即停车。

这个版本只解决空旷场地的直线和大半径缓弯跟随。超声波/ToF 未接入前，不把人物检测
形成的中心走廊判断描述为可靠避障，也不进行货架拐角、拥挤区域或无人看护测试。

## 18. 连续转向感知预研（2026-08-31）

针对真实底盘存在起停、换向和四轮不同步延迟的问题，上位机先在 Human Cart Simulator
中增加连续转向证据，而不直接扩大真实车动作集。目标框横向位置归一化为 `[-1, 1]`，
并用 alpha-beta 滤波和 `0 / 400 / 800 ms` 短期预测计算“转向需求百分比”。该百分比
同时考虑目标横向偏差、横移速度和靠近画面边缘的紧迫度，页面显示轻微/中等/大幅等
等级及当前、预测位置，供人肉模拟和日志复盘使用。

该模块的作用是让后续控制层知道“目标正以多快速度向哪一侧离开画面”，而不是把图像
偏差直接误称为真实转弯角。真实车仍只允许低速前进差速或 `0,0` 停车，不开放倒车、
原地搜索和横移。下一阶段必须采集底盘命令序号、实际轮速或至少开始/停止的实测时延，
没有反馈时不能仅靠人物框修复四轮不同步。

研究依据包括：图像视觉伺服可结合短期运动预测减小感知与执行延迟的滞后
([移动机器人视觉预测控制研究](https://doi.org/10.1016/j.compeleceng.2022.108120))；
Nav2 的 Regulated Pure Pursuit 控制器也按曲率降低线速度
([官方文档](https://docs.nav2.org/rolling/configuration_and_development/configuration_guide/controller_plugins/configuring_regulated_pp/))。
但差速底盘的轮间不同步需要轮速/位置反馈才能可靠校正，开环命令只能假定命令已被执行
([ROS 2 diff_drive_controller](https://control.ros.org/jazzy/doc/ros2_controllers/diff_drive_controller/doc/userdoc.html))。

## 19. 真实车连续动态缓弯接入（2026-09-01）

真实车与 Human Cart Simulator 现在共用 `SteeringDemandEstimator` 产生的
`SteeringEvidence`，不再由真实车重新解释旧 `Control` 的正负号。Simulator 已验证的方向
文字是唯一口径：显示向左时输出左轮较慢，显示向右时输出右轮较慢。

首轮真实车固定使用 `400 ms` 预测提前量。自动模式的外侧轮最大值保持 `14`，内侧轮随
需求百分比在 `14..10` 间量化变化：`inner = 14 - round(4 × demand / 100)`。目标靠近边缘
时仍保持双轮前进缓弯；只有身份、距离、通信或感知安全门失败时才停车。该映射不宣称为
真实曲率或转弯半径，必须通过悬空和低速落地测试校准。

为避免低速曲线在起步阶段被固件的同步助推抹平，ESP32 在既有 BLE `c<left>,<right>`
协议内增加比例化曲线起步辅助。精确直行 `c14,14` 的轮间同步修复不变；曲线命令在 kick
和 hold 阶段保持左右比例。横移能力及其协议继续不接入本轮自动跟随。

## 20. 动态身份适应与拟真自动调档验证（2026-09-02）

实际跟随已经能够完成稳定直行和缓弯，当前上位机重点转向多人干扰、遮挡和目标离开后重捕。
为控制风险，动态 Gallery 和自动调档首先只接入 Human Cart Simulator，真实车继续沿用固定
Gallery 与当前已验收的速度边界。

模拟器保留 8 个不可修改的 Anchor 特征，并在稳定单人跟随过程中自动建立最多 8 个会话级
Adaptive 特征。新样本必须同时通过身份 belief、强 ReID、margin、locked track、bbox 连续性、
图像质量和三次时序复核；多人和恢复状态禁止更新。Adaptive 可以提高候选分数，但不能绕过
Anchor 最低相似度，关闭 Start 或退出页面后立即清空。

遮挡恢复采用“先停车，再确认身份”的原则。模拟器启用全局一对一轨迹关联，恢复阶段最多计算
5 个候选；远离最后 bbox 的目标需要连续三次强 ReID 才能重新锁定。画面仍检测到人物时继续
静止重捕，完全无人按 2 秒或 5 秒实验窗口结束会话。该策略不允许动态 Gallery 在恢复阶段
自我强化，也不会产生运动式搜索命令。

模拟自动输出增加 `c14/c18/c21` 三档显示，分别对应约 `160/206/240 mm/s`。档位由目标相对
距离和转向需求共同决定：越远越快、转弯越急越慢，升档连续确认、降档立即执行。输出只用于
手机端流程和日志验证，不发送 BLE，也不表示真实车自动模式已经开放 `c18/c21`。

下一步用固定 Gallery 与动态 Gallery 分别完成正面转背面、路人遮挡、跨位置返回、目标缺席和
远近变化测试。验收重点是错误身份不得获得运动输出、动态 Gallery 不吸收路人，以及动态模式
是否确实缩短目标恢复时间；通过日志复盘后才决定是否移植到真实车页面。

## 21. 姿态恢复与定向主动重捕验证（2026-09-02）

动态 Gallery 的第一轮手机测试表明其性能不低于固定 Gallery，且目标普通离屏返回后多数可以
恢复。当前困难集中在蹲下、坐下、突然正背面切换，以及目标从车前绕向车后或在拐角快速离屏。
因此第二轮仍只在 Human Cart Simulator 验证，不直接扩大真实车动作能力。

身份恢复增加三个安全层次：高置信检测继续承担正常跟随；低置信检测只能续接既有轨迹；
`Quarantine Gallery` 隔离学习 ReID 分数为 `0.60..0.85` 的连续姿态变化。隔离样本需经过
3 次一致复核才进入候选区，5 次一致且持续至少 1.5 秒才晋升 Adaptive。任何多人、轨迹切换、
全局重捕或图像连续性中断都会冻结或清空隔离区，避免把路人姿态写入目标身份。

恢复流程区分首次启动与会话内恢复：首次确认后保留 3 秒倒计时；已跟随目标恢复时必须有
连续 3 次新鲜 ReID 和稳定轨迹，随后直接进入 `FOLLOW_CAUTION`。如果此前正在模拟旋转，先
保持停车 300 ms，再恢复低档跟随。

只有可信目标从画面左右边缘离开时才允许进入 `DIRECTED_REACQUIRE`。触发条件同时包含
belief、边缘距离、预测偏差、横移方向、连续三帧高低置信候选均失联和 500 ms 证据有效期。
模拟器按固定方向显示原地旋转命令；任何人物候选重新出现都立即停车验证。最大旋转档位、搜索
角度和搜索时间可在 Start 前调整，手机陀螺仪沿重力轴累计相对转角；无陀螺仪时只按时间结束。
普通居中消失、多人交叉和方向不明确仍保持静止重捕。

该方案借鉴 ByteTrack 的低分检测二阶段关联、Deep OC-SORT 的运动与外观联合证据，以及
D-Robotics 示例中的边缘离场定向搜索思想，但没有引入这些项目的完整跟踪器。通过模拟器人工
测试和诊断 CSV 验证污染率、恢复耗时与方向正确性后，才能讨论移植到真实车；近场传感器未
接入前仍不得把主动旋转描述为已具备安全避障能力。

## 22. 模拟器离屏重捕与 Gallery 采样修订（2026-09-03，自动化通过、手机待测）

本节记录主实现任务完成的修订。最终 Debug、Release 单元测试各 128/128，均为 0 失败、
0 错误、0 跳过；离线执行 `:robot:testDebugUnitTest :robot:check :robot:assembleDebug`
全部成功，耗时 1 分 19 秒。变更 Java 的 google-java-format 1.7 dry-run 和 diff check 通过。
手机验收尚未执行，也未安装本轮 APK；自动化通过不能替代手机验收。
本轮仅验证 Human Cart Simulator；`RealCartAutoDriveController`、真实车 Safety、
RealFragment、BLE 和固件均未修改，不扩大真实车动作集。

### 22.1 帧一致性与性能口径

- 只对获准进入推理的帧建立不可变图像快照；Detector、ReID crop 和结果必须对应同一
  generation / frame sequence。停止、重启或生命周期切换后的旧任务不得回写新会话。
- 缓存 ReID 证据必须绑定来源 track、帧序号与时间；跨 track 不复用，缓存重读不算新鲜证据。
- FPS 按实际完成计数与实际时间窗口计算，并区分 Detector、ReID、完整管线耗时及结果年龄。
  旧 FPS 仅反映 Detector 耗时换算，可能滞留旧值，不能当作相机帧率或端到端完成帧率。

### 22.2 Gallery 的质量与身份边界

上下边缘截断可能来自购物车手机的正常安装视角，不能仅因头部或脚部出画就判为坏图或模糊。
普通 Gallery 的 upright 可见高度占转正后画面高度的比例门槛为 18%，Quarantine 为 12%，
不是面积比例；转正后的实际 crop 至少为 32 x 64 像素。当前未实现模糊或曝光检测，不评估
模糊分类能力；验收区分几何拒绝与身份拒绝，上下截断放行不等于取消其他门控。

稳定、单人、locked track 且满足身份和质量门控时，静止也允许学习，不要求先有前进输出。
Quarantine 不得参与身份分数自我抬高；进入隔离区需要 3 次新鲜一致证据，晋升需要 5 次新鲜
一致证据且持续至少 1.5 秒。局部连续轨迹的 Anchor 下限为 0.60，全局重捕的 Anchor 下限
仍为 0.70；局部适应不能放宽为远处候选自动确认。多人、轨迹切换和连续性失效仍须冻结或清理。

### 22.3 定向搜索与陀螺仪

定向离屏证据限定为最近 800 ms 内、belief >= 0.75 的单个可信目标，位于对应左右边缘
15% 区域，有至少 2 次向外运动观测，随后至少连续缺失 2 帧且缺失时间达到 100 ms。
不把上下截断当作左右离屏，也不以旧预测偏差或历史三帧条件代替本轮门控。

定向搜索使用独立的超时所有者，Start 前选择 1..10 秒；计时覆盖该搜索的所有阶段，包含
候选出现后的停车验证与等待，不因阶段切换重新起算。普通静止重捕的 2/5 秒规则独立保留，
不能提前截断或无限延长定向搜索。搜索中禁止前向位移，安全异常和超时进入 hard STOP。

普通无人计时从首次缺失开始，即使状态暂时仍为 `FOLLOW` 也不能延后起算；低置信的可能
人物仍在场时保持普通等待，不按完全无人结束。`DIRECTED_REACQUIRE` 使用恢复期最多
5 个 ReID 候选的预算，但全局候选不再直接触发自动换人，授权规则见第 23 节。

陀螺仪测试须能在 Start 关闭时独立执行左转、右转、停止与重置，不依赖目标确认或视觉搜索。
传感器有效性要求陀螺仪与重力数据年龄均不超过 500 ms；记录有符号净转角，反向转动应抵消进度，不能把
往返晃动累计成完成转角。无传感器或数据陈旧时明确降级，不宣称测量有效。

### 22.4 验收入口

新增距离诊断不改变原跟随/调档阈值，现有模拟器仍使用距离状态参与调档。新增诊断不是
米制距离测量，不能将其解释为本轮取消了距离对速度档位的影响。

逐步验收、拒绝原因排查和取证见 [模拟器离屏重捕与Gallery采样测试指南](模拟器离屏重捕与Gallery采样测试指南.md)。
图片与 crop 只在“记录日志”开启时落盘；记录必须对应真正采样的源帧与事件，而不是把所有
绿框帧都称为学习样本。日志默认关闭，关闭时不新建诊断 session、CSV、crop、gallery 或 event。

实际诊断目录由 `Environment.DIRECTORY_PICTURES` 提供，为
`Android/data/org.openbot/files/Pictures/cartfollow_diagnostics/`。
`frame_log` 新增完成时序、观测来源、屏幕框和 `distance_diagnostic`，`identity_log` 新增
ReID 观测溯源、新鲜性和 crop 几何拒绝原因；`frame_presented` 事件包含 `source_age_ms`
与 `generation`。完整字段列表见测试指南第 6 节。

## 23. 模拟器帧处理与身份授权收口（2026-09-03）

手机日志 `cart_diag_20260903_142516` 显示：原目标近乎占满画面时，慢帧的检测平均约
29 ms、ReID 约 36 ms，而处理总耗时约 1.1 秒。超过 500 ms 的旧框因此被隐藏。
之后锁定轨迹从 T1 切换为 T2，出现模拟 `c21,21`；结合用户现场反馈，这是必须修复的
误接管风险，不能解释成“画框已恢复”。该轮 Adaptive 数量为 0，不是动态采样污染。

- 模拟器每帧复用一次传统匹配，HSV 上、下半身分别均匀采样至多 4096 像素；确认基准与
  后续比较一致。真实车保持原来的颜色统计、控制与 BLE 配置。
- 保留 500 ms 源帧期限。过期时停车、冻结身份重锁和 Gallery；流程阶段仍可阅读，
  不关闭 Start 或隐藏确认面板。新鲜结果到达恢复显示，不延长旧框寿命冒充实时检测。
- 恢复授权独立于 track belief。可靠局部候选需要同一 track 的 3 次新鲜、独立 ReID，
  best >= 0.85、margin >= 0.08；换 track 的 Anchor >= 0.70。缓存不重复贡献 ReID 分数
  或增加授权次数。正常模拟器 ReID 调度间隔不超过 300 ms，以适应 500 ms 证据期限。
- 已知干扰者在本会话中不得自动接管。确认时及目标新鲜可信时，将与其同时出现、IoU
  小于 0.10 的其他高置信 track 记录为干扰者。重复/重叠框不按独立人物排除。
- 记录多人歧义历史（包含低分人物候选）。多人交叉后，即使候选以未登记的新 track 出现且
  连续高分，也不得自动替代原 locked track；提示重新确认。只有原 locked track 连续获得
  3 次单人、新鲜的强身份证据，或用户显式重新采集，才清除该歧义记录。该防护仍不能证明
  同一 track 内绝无身份交换，须继续用相似衣着与遮挡场景验证。
- 远处候选、连续性不可靠或已知干扰者保持黄色候选和 `c0,0`，提示重新确认。用户点击
  “重新采集并确认目标”后复用 15 帧采集流程，清空旧会话并重新标定；普通局部恢复不重复
  首次倒计时。未经授权期间冻结 Gallery，包括隔离候选，优先保证不学习未经确认的身份。
- 搜索截止时间由独立轮询兜底，无新推理结果也不能无限搜索。陀螺仪左右修正保持不变。

验收分别记录自动化、APK 标识和手机场景结果。手机验收前不迁移到真实车，不宣称高分
ReID 或三次复核可以保证身份正确。原日志、图片、模型及 APK 保持 ignored，不提交推送。

首轮修复包手机复测 `cart_diag_20260903_151115`：191 条采样呈现记录的源帧年龄中位数
68 ms、P95 107 ms、最大 119 ms，无记录超过 500 ms；仅说明该轮采样性能改善。
用户仍观察到路人变绿、原目标未恢复，因此身份验收未通过。已补上多人歧义历史防护，
补丁自动化通过，仍待手机复测。Gallery 最大 Adaptive 数量为 0；主要拒绝原因为身份不足、
多人冻结及连续性不足，也存在重复样本，不将其统一归因为图像质量。

## 24. 模拟器连续身份保持与近期记忆（2026-09-03）

第 23 节的统一授权入口修复了旁路，但将低分停车与清空隔离样本绑定，阻断了姿态学习。
本轮拆分身份保持、运动和采样权限，替代“未授权就冻结全部学习”的实验规则；不修改真实车。

- 已验证且进入过跟随的原 locked track，在单人、高置信、无丢帧、无竞争关联、局部空间门
  通过且最近 3 次观测连续时，可以保持关联。相邻观测间隔不超过 500 ms；宽高比均在
  0.65..1.55，中心位移不超过前框对角线的 0.35。参数是原型门槛，不是身份真实性证明。
- best 在 0.70..0.85（不含上界）、margin >= 0.08 时允许最多 1 秒低档模拟续行；不从
  停车起步，不升档，距离 UNKNOWN/OK/TOO_CLOSE、障碍、失效画面仍停车。框连续和 Recent
  高分不续签计时；恢复正常授权仍需 3 次新鲜强 ReID。低于 0.70 立即停止模拟运动。
- 状态分为 VERIFIED、CONTINUITY_HOLD、ADAPTING、RECONFIRM。宽限到期后停车，但原轨迹
  连续且分数 >= 0.60 的姿态候选可继续隔离复核。沿用 3 次一致候选、至少 5 次且 1.5 秒
  的晋升要求，不在晋升本帧授权，不重新标定用户确认的距离尺度。
- Recent 独立于多样性 Adaptive：最多 16 个特征、5 秒有效、至少 300 ms 间隔；先匹配、后
  写入。保留可靠的相似样本，至少 3 个样本才取最相似 3 项均值。仅辅助当前 locked track
  的局部匹配，不抬高用于强授权的原始 ReID 分数，不降低 Anchor 门槛，不支持新 ID 接管。
- ReID 预算不变，优先计算并保留当前 locked track 的候选、特征、crop 和独立分数；全局
  最高分不是自动切换跟随目标的理由。多人、关联歧义、会话清理或 track 交接清空近期记忆。
- 动态模式默认启用近期记忆；固定模式不更新，开关在 Start 后锁定。界面分别呈现身份、
  模拟输出和学习状态，日志追加身份权限、连续性原因、宽限及 Recent 字段。

参考 [Deep SORT 的有限容量外观样本管理](https://github.com/nwojke/deep_sort/blob/master/deep_sort/nn_matching.py)
借鉴近期样本淘汰思路，未接入其完整跟踪器。身份宽限、安全仲裁及分层 Gallery 为项目侧实验设计。
不宣称可杜绝同 ID 内身份交换；复测需同时评估正常目标稳定性与相似路人误接管。

## 25. 模拟器 Gallery 延后复核与停车等待恢复（2026-09-03）

本节统一当前实施与验收口径，覆盖第 21 至 24 节中冲突的实验策略；历史章节的测试、构建、
安装和手机结果仍保留，不改写成当前结果。仅适用于 Human Cart Simulator，不改变真实车、
BLE、固件、距离控制或速度参数；系统仍为 OpenBot + Android 手机 + MCU + 底盘。
模拟器普通超时后保留会话的实验不等于放宽真实车目标丢失后的安全 STOP 边界。

最新手机反馈针对上一构建：体验改善，但 Gallery 显示长期为 8，长时离开返回仍失败。
本轮需区分各 Gallery 分区和实际拒绝原因，再验证恢复行为；不能仅凭总数判断学习成功，
也不能将本轮代码或自动化测试代替手机验收。

### 25.1 采样与有界延后复核

- 四边贴合/裁切均不是独立否决条件。几何判据采用转正 bbox 与画面交集：至少 32 x 64 px，
  普通可见高度比例 >= 18%，候选 >= 12%，可见宽高比 >= 0.15。侧边持续退出/身体变窄
  按连续性和离屏风险冻结学习，不称作模糊或图像质量不足；不新增模糊/曝光检测承诺。
- Recent 默认开启，容量 16、TTL 5 秒、采样间隔至少 300 ms，全部按原始采集时间计算。
  接纳可靠重复样本，仅辅助既有局部匹配，不参与身份授权。固定模式冻结所有动态区域。
- 候选片段限于已验证原目标的单人、高置信实测、可靠局部连续关联；开启分数在 [0.60,0.85)。
  相邻新鲜特征 cosine >= 0.85，最多 16 特征、整段最多 5 秒、源时间采样间隔 >= 300 ms。
  保留 session、track、源帧/观测 ID、源时间、bbox、独立分数与 Gallery revision。
- 开启时冻结并深复制 Anchor + 全局合格 Adaptive。累计至少 5 个新鲜样本且跨度 >= 1.5 秒，
  再同时满足弱片段之后连续 3 个独立强端点，才可回溯批准；每个端点冻结分数 >= 0.85、
  Anchor >= 0.70、margin >= 0.08。Recent、本段候选和之后新增 Gallery 均不能参与自证。
  身份许可尚在计数不否定独立强证据；缓存、持续绿框和单次高分不能推进复核。
- 多人、歧义、轨迹切换、特征不连续或 > 500 ms 中断清除片段；上下文冻结后需重新验证
  原目标，不能用弱分立即重启学习。非推理帧不因没有新 ReID 特征而清空候选。
- 批准仅用于历史样本学习，最早下一帧才可参与匹配，不授权批准帧。Recent 按原时间淘汰，
  不因补录获得新寿命；Adaptive 仍最多 8 项、按确定性多样性重选，延后样本限定原轨迹
  局部姿态支持，不参与全局身份授权。旧自相似晋升路径不得绕过独立端点复核。

### 25.2 自动复核而非强制重拍

首次采集/确认及用户主动重拍保留；会话恢复用 `AUTO_VERIFY` 表达局部/全局类型与进度。
局部保留 3 次新鲜强证据，既有连续保持宽限最多 1 秒且不能从停车起步，不扩大运动权限。
长时丢失或新轨迹返回进入静止全局验证：同一候选连续 5 次新鲜证据、跨度 >= 1200 ms，
每次分数 >= 0.85、margin >= 0.08、Anchor >= 0.70，证据间隔 <= 500 ms。

全局仅使用 Anchor 和全局合格 Adaptive；最多评估 5 个高低置信候选，只有高置信候选可
授权，超预算时保持停车。当前多人或歧义暂停/重置验证，候选变更、证据失败和间隔超限
从零计数；历史歧义不再永久阻塞，但已知干扰者仍禁止接管。授权前黄色候选、`c0,0`、
冻结学习，不替换 locked track 或距离基准；通过后统一恢复关联并经过起步稳定门。

普通等待 2/5 秒或定向搜索时间/角度耗尽转入 `PARKED_WAIT`，模拟输出归零但保留 Start、
Anchor 和已接纳 Adaptive，静止等待可信目标返回。搜索与复核共用绝对截止时间，不能因
候选切换延长，也不能被普通等待提前抢占。没有“到期后再转一轮”的自动重试；需要先重新
取得可信 FOLLOW，再形成新离屏事件。已跟随会话不重复首次倒计时，旋转后停车稳定 300 ms。
关闭 Start、退出页面或硬安全异常仍结束会话；保留记忆不等于保留旧帧或运动许可。

### 25.3 离屏证据与复测

最近 800 ms 的实测框历史独立于距离/前进许可保存，最后强身份年龄 <= 1 秒；连续保持不能
续签强身份时间。至少 2 次位置观测、累计向外 >= 屏幕宽度 2%、对应边缘 15% 区域，允许
一次 < 1% 中性抖动；明显反向、关联歧义或过期清除。大框同时贴左右边时结合中心位移、
边缘变化和可见宽度收缩判断，不能仅看是否贴边。

同帧先更新离屏风险再决定是否学习；跟踪器刚更新的 locked ghost 不能自证历史连续性。
相机帧绑定 ReID 会话编号，重置前的迟到提取与尚未执行任务均不能污染新 Gallery。

目标连续 2 帧且至少 100 ms 无高低置信续接后，才判定离屏失联；画面有其他未排除人物时
不旋转，候选出现先停车验证。提示使用“目标暂不可见”“疑似向左/右离屏”“身份验证中”
或“搜索结束，静止等待”，不把缺失无依据地断言为遮挡。

验收记录分开列出 Anchor、Adaptive、Recent、Quarantine，及采样、复核、接纳、重复/拒绝
原因；保留源帧、冻结版本和恢复/离屏诊断。日志默认关闭，关闭时不产生 session/CSV/crop，
但内存学习继续；开启时保存真实源帧 crop，不将批准帧照片冒充候选来源。

本轮 Debug、Release 各 270/270，0 失败、错误或跳过；离线 testDebugUnitTest、check、
assembleDebug 和 Java 格式检查已完成，保留 10 个已有 Lint 错误。APK 为 42,384,958 字节，时间
`2026-09-03 17:45:07 +08:00`，SHA256：
`24B03C1DB683E2BF6D50667BF62844D8667048C30C09A75913897F01ACF23B31`。
本轮未安装手机，帧处理耗时及真实场景效果尚待复测。超过 3 秒没有强身份验证，即使仍为
同一 track ID，也需全局验证。按
[模拟器离屏重捕与Gallery采样测试指南](模拟器离屏重捕与Gallery采样测试指南.md)测试近距离四边贴合、
转身黄框后恢复、长时间离开返回、相似路人交叉和快速左右离屏，同时统计错误身份输出和
停车/恢复耗时，不以 Gallery 增长单独判成功。未提交、未推送，不新增图片或公开私人采样。

## 26. 真实车动态跟随迁移（2026-09-03）

本节更新第 25 节的“仅模拟器”边界：经用户同意，将增强身份、四区 Gallery、静止自动恢复
与离屏证据接入真实车受控实验。此前模拟器仅有初步体验反馈，未完成专项验收，不等于整车
可靠性已经通过。

### 26.1 当前实现

- 共享感知与身份代码；真实车 VERIFIED 才能前进，弱身份停车但保留可靠关联和延后学习。
  不迁移模拟器 1 秒弱身份续行，不放宽尺寸、身份、多人和干扰者限制。
- 动态 Gallery/Recent 默认开启，支持 Start 前对照。局部 3 次新鲜强证据，全局 5 次且
  至少 1.2 秒；首次采集确认保留，恢复不强制重拍、不重复首次倒计时。
- 无人 2 秒或搜索预算耗尽后静止等待，保留 Start 和记忆；硬安全异常仍结束会话。
- 自动档位 14/18/21，默认上限 21，可保存；停车后 3 个合格新鲜帧只从低档起步。
  复用原模拟器距离阈值、0.03 滞回及 3 帧升档，转向限档、立即降档，不改变距离基准。
- 转弯强度保留 20%–200%；三档基础最大差速 4/5/6、内侧最低 6，普通跟随不倒车或旋转。
- 决策和 100 ms 重发前核验会话、动作及源帧 <=400 ms；感知 500 ms 期限不变。
  运动推理超时、失焦、退后台、断连、急停和 Start 关闭继续优先停车。

### 26.2 可选定向搜索

独立真实运动门，页面默认关闭，Start 前显式开启。首次 c5、90°、5 秒，数值保存但开关
不保存。只有可信侧边离屏且无其他候选才可旋转，手机固定且陀螺仪/重力数据新鲜。
无传感器不降级计时旋转；运动中传感器失效或反向净角 >=5°，停车并撤销解锁。

先提交 STOP 并保持至少 300 ms 零输出，再允许 PIVOT。第一次提交旋转才起算角度，
暂停验证不停测；绝对总时限包含等待、固件制动和验证，不把提交/GATT 成功当成停稳。
候选出现立即停车，恢复后保持 300 ms 稳定再低档起步，预算耗尽不重复旋转。

### 26.3 验收状态

增加配置锁定与保存、四区信息和实际轮速显示，以及真实调用链、调档和搜索回归。
本轮 Debug/Release 各 **306/306**，离线单元测试、check、Debug 构建和格式检查通过；仍有
10 个已有 Lint 错误。构建详情与 APK 哈希见 [开发日志第 32 节](../dev/OpenBot/android/cartfollow-devlog.md)。
尚未安装手机；软件完成不代表真车验收通过，实际处理延迟、制动距离、过冲和误身份输出待测。

按 [真实小车动态跟随与定向搜索测试指南](真实小车动态跟随与定向搜索测试指南.md)分阶段：
关闭搜索悬空检查 → 空旷三档跟随 → 手动方向与测角 → c5 搜索 → 逐档提高旋转速度。
使用当前速度闭环固件，不套用旧 trim/kick 说明；不改固件、协议、手动控制或距离标定。
没有近场传感器，不进入货架、拥挤或无人看护场景，任何错误身份非零输出均判失败。
本轮保留本地改动，不提交、不推送，不纳入私人图片、诊断输出、模型或 APK。

## 27. 连续远离身份维持修复（2026-09-03）

本节更新第 26 节的身份门，不改变硬件、协议、手动控制、距离标定和强授权下三档参数。
单人始终可见却长期黄框的问题，先修代码中强验证阈值复用于维持、无强授权 3 秒转全局、
授权后冻结几何参照等机制；现场首个触发条件仍需日志确认。

两页共用独立实测历史与 TRACK_MAINTAINED。原目标已强验证且跟随过，最近三次单人高置信
实测几何连续、无丢帧或竞争，并持续有独立分数 >=0.80、Anchor >=0.70、margin >=0.08 的
新鲜证据时，可绿框“连续跟踪 · 低档”，只输出 c14 和低档差速。不是无限凭框续期。

不足维持门立即停车，可靠关联及黄框学习继续；三次新鲜维持证据恢复低档，三次原有强证据
恢复强授权，停车后的起步稳定检查不重复叠加。真实车 400 ms 运动源帧、500 ms 感知时效与
所有硬安全门保持；维持不能刷新主动搜索强身份时间，也不批准自身 Gallery 候选。

持续可靠观测不因长时间无强授权进入全局；真实丢失超过 3 秒、轨迹交接、空间断裂仍严格
全局验证。近距离/小目标 Gallery 采样门只影响学习，不直接控制身份颜色。

历史记录曾写 Debug/Release 各 315 项；接续时实际存留报告各 277 项，此旧数量撤回。
当前验证与 APK 以第 28 节指向的开发日志第 35 节为准。旧 APK 信息仅作历史留档，见 [开发日志第 33 节](../dev/OpenBot/android/cartfollow-devlog.md)。按
[中文复测指南](连续远离身份维持复测指南.md)执行“静止 → 缓慢远离 → 停住 → 返回 → 路人交叉”，
先模拟器、再悬空、最后空旷低档落地。0.80 仅为实验默认值，不承诺远距离都能认人。
本轮不安装、不提交、不推送；任何错误身份非零输出均判失败，结果不能以 Gallery 增长抵消。

## 28. 连续跟踪主导与手机离线日志（2026-09-03 接续实现）

本节为当前实现口径，替代第 25–27 节和开发日志第 34 节中“局部外观低分停车”“多人即竞争”
“连续目标只限低档”“延后样本仅局部有效”等旧规则。首次采集、人工确认和倒计时保留。

### 28.1 位置与身份的职责

`TrackingDecision` 为模拟器和真实车共用的实测决策，包含会话、源帧、检测时间、目标框、
检测等级、关联状态、稳定帧数、运动/学习许可及档位上限。只有匹配当前会话与源帧的实测位置
可以授权运动；连续跟踪不把旧 ReID 缓存改成新证据。

正常阶段优先续接 locked target。中心距离 <= 画面对角线的 0.35 或预测误差 <= 0.18，且双向
配对唯一时可续接；速度按实际时间差预测，尺寸参与评分但不单独否决。双向配对分差 < 0.15
判为竞争。Gallery 分数低、特征提取暂时失败和缓存过期不否决可靠单人连续跟随。

检测 >= 高阈值时按距离正常调档；至少达到 min(0.25, 高阈值) 的低置信实测只能续接已有目标，
最高 c18、不学习、不创建新目标。正常最高 c21，停止后先 c14 起步；三帧实测稳定与恢复核验
并行，恢复后退出谨慎状态。同向调档不额外插入 STOP。

未续接立即取消前进；500 ms 内在预测邻域唯一返回，三帧实测恢复，不等待 ReID、不重复倒计时。
超过窗口、空间断裂或真实交接进入重捕。全局恢复仍需同一候选 5 次新鲜证据、至少 1.2 秒、
best >= 0.85、margin >= 0.08；best 可由 Anchor 或已批准全局 Adaptive 提供，不额外要求 Anchor
单独达标。已知干扰者、真实关联歧义、过期帧和旧会话保持阻断。

路人出现但原目标关联唯一时继续运动、冻结学习。每 500 ms 尝试一次最多 5 人的完整核验，
受实际检测帧到达时间限制；另一候选两次新鲜核验达到 0.85 且比原目标高 0.10，则停车验证，
不直接换人。候选超预算或超过 1 秒没有完成多人核验时停车。真实车保留 400 ms 源帧限制，
急停、断连、障碍及距离 UNKNOWN/TOO_CLOSE 仍优先停车；定向搜索参数与边界不扩大。

### 28.2 动态记忆

Anchor 只读，Adaptive 最多 8 项，Recent 最多 16 项、5 秒有效。来源与 `globalEligible` 分开记录；
通过可靠连续片段批准的样本可以全局使用，最早在批准帧之后生效。

单人可靠、高置信、合格 crop 的片段，至少 3 个新鲜样本、跨度 >= 600 ms、相邻特征相似度
>= 0.75 即可批准；没有旧 Gallery/Anchor/belief 额外分数门。特征提取周期 200 ms；重复可靠特征
允许刷新 Recent，Adaptive 继续控制容量与多样性。采样尺寸为转正后至少 32×64 px、宽高比
至少 0.15。相邻外观不连续只中断学习；多人、离屏、低置信、真正丢失及关联存疑冻结未批准片段。

界面分别显示连续跟踪、检测偏弱、多人核验与重捕验证；绿框代表位置连续，独立 ReID 分数仍显示。
距离控制可能因极端宽高变化产生 UNKNOWN；这种距离停车与身份退化要分别统计。

### 28.3 离线记录

“记录日志”默认关闭，打开即建立手机记录，包含采集、确认、控制提交、BLE 队列/写入、停车和结束。
目录仍是 `Android/data/org.openbot/files/Pictures/cartfollow_diagnostics/`，原 CSV 列顺序保留，新增列追加。
增加 control_log.csv、gallery_provenance.jsonl、构建/策略元数据和结束摘要。控制请求与 GATT 写入成功
分开表述，后者不代表电机已经执行。

文字与图片分开有界排队（文字 2048 项、图片等待队列 8 项），文字每秒刷新；目标 crop 每秒最多
一组，关键变化场景图每秒最多一张。队列丢弃和写入错误在页面与摘要中可见。关闭日志停止接收新数据，
已接收数据异步写完。真实车停止测试时额外保留最多 500 ms 的末尾 BLE 观察窗口，再异步收尾；该窗口
不改变车辆调度。关闭日志开关会立即结束观察。

两页均提供“测试记录”，停止测试后等待收尾，可保存 ZIP 到系统文件选择器指定位置或系统分享。
未正常结束的记录显示“不完整”且可导出；取消/失败保留原记录，不自动删除或上传。

验证及安装包信息见 [开发日志第 35 节](../dev/OpenBot/android/cartfollow-devlog.md)，操作步骤见
[连续远离身份维持复测指南](连续远离身份维持复测指南.md)。本轮只完成本机开发与自动化验证，手机效果
和实车停车响应需要现场复测；保留低速课程原型范围，不引入服务器或修改固件。

## 29. 2026-09-04 现场状态与下一次复测范围

连续跟踪改动已改善单人目标持续可见时的跟随体验：远离、侧身及短时 ReID 低分不再应单独
触发黄框或停车。但这只是当前跟随目标的改善，不能延伸为拐角导航或身后自动追随已经完成。

当前普通跟随只允许前进差速缓弯；人物在货架拐角离屏后没有经实车验证的通道判断、路径记忆或
绕角策略。人物从前方走到车后时，普通跟随不会倒车或自行原地旋转；只有既有的可信侧边离屏
定向搜索在传感器、身份与安全门都满足时才可能低速旋转，尚不可作为身后跟随能力验收。

下一次测试必须打开手机日志并导出 ZIP，按直线远离返回、缓弯、拐角离屏、前方绕到身后、路人
交叉依次执行。每段记录是否悬空/落地、搜索开关、最高档位和人工急停情况；复盘以
`frame_log.csv`、`identity_log.csv`、`control_log.csv` 和 `summary.json` 为准。GATT 写入成功
不能替代轮子执行证据。若发生停车，应先按日志区分身份/连续性、距离/转向、安全门与 BLE 执行，
再决定是否修改策略；在此之前不扩大自动自转或拐角试探。

## 30. 持续对准、绕后重捕与距离倍率（2026-09-04）

本节替代第 28.1、29 节中“距离合适即停止全部运动”“定向搜索边界不扩大”和“普通跟随不会
自行原地旋转”的旧描述。身份、帧时效、急停、断连和真实关联竞争仍拥有最高优先级。

自动控制现在分别产生 `AimDecision` 与 `TranslationDecision`。目标可见且距离合适或太近时，
前进被禁止，但预测中心误差达到 0.18 后仍可用 `c-5,5`／`c5,-5` 原地对准；连续三帧回到
0.08 内才退出原地转向。距离过远时，误差小于 0.10 直行，普通偏差沿用差速缓弯，达到 0.35
或进入边缘区则取消前进并原地转向。模拟器与真实车共用这些阈值和指令语义。

可信目标从左右边缘离屏后，前进立即归零，先经过现有 300 ms 制动，再沿最后离屏方向以默认
`c5` 搜索；默认上限改为 180°／10 秒。人物出现时暂停旋转最多 500 ms。唯一候选从原离屏侧
外侧 25% 入镜、连续三帧且至少 100 ms 向中央移动、关联无竞争时，可以先按位置连续性完成重现，
无需正面 Anchor 高分；随后先原地居中，再由视觉距离决定是否前进。明确的身份冲突仍停车验证。
达到角度或时间上限后静止等待，不自动开始第二轮。Gallery 在离屏、旋转和初次重现阶段冻结。

确认距离改为至少 15 个高置信实测框、覆盖至少 500 ms 后取人物框高度中位数。明显顶／底裁切
会清空这段标定并要求重新站位。运行时以框高为主距离依据，面积和宽度差异只作诊断。新增
“视觉最远距离倍率”1.05～1.40（步长 0.05，默认 1.10）：达到倍率开始追赶，回到
`max(1.00, 倍率-0.08)` 后停止前进，消除旧 0.80～0.85 起步死区。设置持久化，跟随开始后锁定。

中央超声波舒适下界 600～1200 mm 及左右红外约束只写入接口计划；当前旧协议中不显示无效
传感器设置。独立的 [V2-DRAFT-0.1 协议草案](购物车Android-ESP32通信协议V2草案.md) 已定义三轴
运动、接受回执、三路快照、会话配置和本地安全提案，但本轮没有修改 Android 通信代码或 ESP32
固件，也没有增加侧移按钮。自动跟随未来仍固定 `vy=0`。

上述行为已进入桌面自动化，尚未完成手机、悬空或落地验收。左右红外和中央超声波尚未正式接入；
当前原地旋转没有后侧防撞覆盖，只能在空旷场地、低档、有人准备物理断电时测试。货架拐角的通道
选择和绕障仍未实现，不能把“朝离屏侧旋转”描述成拐角导航。

## 31. 传感器版 V1 协议与 Android 二次门控（2026-09-04）

实车固件现已接入左／右 VL53L1X 和中央 URM09-I²C，并通过 `fCART_AT8236:s:` 声明
OpenBot V1 测距能力。Android 在握手后发送 `s100`，接收 `s<cm>` 并转换为毫米。该数值只是
三路有效新鲜读数的最小值，无法判断来自左、中央还是右；三路独立状态仍只能从 ESP32 USB
`!Q`／`RANGE` 诊断获得。V2 草案中的 `m/d/g/a` 没有实施，本阶段不提供侧移。

Android 对前进、差速弧线和原地转向增加第二层门控。前进在最小值 <=300 mm 时停车，连续
3 个 >400 mm 样本后解除；转向在 <=200 mm 时停车，连续 3 个 >300 mm 样本后解除。未声明
`:s:`、尚无读数或超过 250 ms 未更新时同样禁止前进和转向。普通停车与急停始终有效；后退
保持可用，但没有后侧传感器覆盖。ESP32 的方向相关门控和制动仍是最终安全依据。

最新固件速度映射已经改变：`c14≈240 mm/s`，`c16≈343`，`c18≈446`，`c20≈549`，
`c21≈600`。Android 默认最高档仍按已确认选择保留 `c21`，界面和日志必须显示真实估算值。
600 mm/s 尚未完成跟随场景落地验收，只能按固件测试方案逐档验证，不能以软件默认值替代安全结论。

## 32. Android 传感器仅记录模式与遥控日志（2026-09-04）

V1 `s<cm>` 只有三路有效距离的最小值，无法支持 Android 方向级运动判断。实车出现前进和单侧转向被误封锁后，Android 已取消测距对手动、自动跟随和定向搜索的二次门控；能力缺失、数据过期和距离过近只进入界面与日志。断连、急停、身份、帧时效及自动授权规则保持不变，当前速度映射和默认 `c21` 不回退。

遥控模式可以独立打开日志。`control_log.csv` 追加控制模式并补齐方向替换请求，新增 `range_log.csv` 保存每个新 `s<cm>` 序列、接收年龄、新鲜度、当前请求轮速及固件错误；记录摘要区分遥控、自动和混合会话。V1 仍不能提供三路独立手机日志。

ESP32 现有固件仍会按中央、左、右传感器拒绝运动，所以上述改动只保证 Android 不再拦截。下位机须依据 [ESP32 传感器仅日志模式修改说明](ESP32传感器仅日志模式修改说明.md) 增加统一关闭开关，同时旁路命令接收和运动中制动两个入口；传感器采样、最小值回传、USB 三路诊断、急停、心跳和驱动故障保护继续保留。固件重新烧录前，`!ERR,sensor_*` 仍属于已知限制。

## 33. 实车转向振荡与 BLE 恢复修正（2026-09-05）

本节替代第 30 节“持续固定档位原地对准、连续三帧居中后退出”的控制口径。9 月 5 日实测中，
47.56 秒后的 84 个日志记录点全部允许平移，82 个却输出原地旋转；400 ms 外推在实际中心误差
0.0273 时产生 0.2443 的预测误差，促成左右反打。固件反向制动产生的 settling 又延长了停顿。

实车转向采用当前实测误差（预测时域 0 ms），距离允许时优先差速前进。误差绝对值超过 0.18
将前进档位限制到 c14，超过 0.10 限制到 c18；直行默认最高 c21 保留。远距离误差达到 0.60
才进入原地对准，不再仅因预测误差或 crop 边缘接近就原地自转。距离合适／太近时仍以 0.18
为原地对准进入阈值，且禁止前进。

真实车与模拟器共用 TargetAimController：从行驶切换原地对准前先停车；对准采用 c5、最长
300 ms 脉冲，每次停止后观察 650 ms，并要求收到观察期结束后的新画面才再次决策。转动中
远距离误差回到 0.35、近距离回到 0.08、越过中心，或短时变化趋势预示接近中心，均立即停止
旋转。趋势只能用于提前停转，不能直接决定反向。实车发指令定时器同时检查脉冲截止时间。
650 ms 是上位机观察窗口，不是固件完成制动的确认；ESP32 settling、急停与驱动保护继续生效。

BLE 实测在重启小车后仍返回建连 status=133，重新扫描后约 0.56 秒达到串口就绪。本轮将失败
恢复改为：清理失败连接、等待 750 ms、扫描 4 秒、仅重新发现同一地址时使用新设备对象重连；
扫描另设 5 秒回调兜底，最多一次自动重试。没有发现设备或扫描失败时明确失败，不盲连旧对象。
该流程处理已复现的恢复缺口，不把一次扫描成功当作所有 133 错误的根因证明。

本轮不修改 ESP32 固件或 V1 协议。桌面回归通过后仍需按联调指南复测斜向前走、近距离侧移、
边缘对准和 BLE 断连恢复，方可确认实车改善。

### 2026-09-05 晚间实测后的阶段调整

当前采用候选 follow-visible-curve-v2 修复小偏差响应、缓弯差速及有界可见目标对准，参数和验证记录见 Android devlog。完整人物采集与视觉参考标定不等同于未来舒适距离设置：用户合适距离下仅小腿到后背可见，旧人框高度及脚点均不足以可靠维持距离。实际近距设定待三路测距联调后，按“身份采集完成—站到合适位置—倒计时记录”的流程实施，先验证中央测距的目标覆盖和多人歧义；本轮不烧录，不启用近距按钮。

## 2026-09-05 执行更新：宽度跟近与有限货架探行

用户授权保留原初始化流程，改用运行时人物框宽度跟近；期望车头约 200 mm 净空，中央 300 mm 为停车触发候选，安装高度不变（中央约 9 cm）。R3 已由用户烧录联调通过，现进入运动决策接入。

新策略 shopping-close-corner-v1 在 R3 能力出现后启用近距控制：宽度 55% 停止、45% 以下重启，末段使用 6～10 档；中央 300 mm 停前进、400 mm 以上连续三个新快照解除，失效/过期取消前进。左右安装方向默认仍为正侧方，只有用户在界面标记实际改成斜前 45°，才允许带前进的货架探行。

实车日志随后确认“失效/过期一律取消前进”会使正常可见跟随完全停住：侧向超量程长期返回状态 1，中央测不到脚部时返回状态 2。shopping-visible-range-v2 将状态 1/2 在“原目标可靠可见且相机新鲜”的普通跟随中解释为未发现明显障碍，不再限档或阻止视觉转向；有效近距仍锁存，且不能由无效回波解除。R3 遥测中断、状态 4/5、身份/相机失效仍停车。遮挡后的沿边探行仍要求有效测距，不继承此可见目标例外。

用户已明确允许遮挡后有条件前进，替代原丢失后绝对禁止前进的限制。新控制器依据目标连续向外运动与最近货架距离变化/前方弯道空间，进入停车、确认、低速弧线、沿边、重捕获阶段；250 ms 动作段后等待至少 150 ms，并需要等待截止之后的新画面和新测距。总时限 6 秒、累计相对转角 100°，未知侧距仅可在近期有效空间历史支持下做受限角度观察，不直接授权前进。无拐角证据仍只允许有限原地搜索。急停、失帧、通信及多人歧义优先。

本轮只是候选控制实现与回归，不等于实车拐角验收；不构建 APK、不烧录。需新包按近距、可见缓弯、单个直角、货架空隙/多人依次测试，记录实际停止净空及最大偏转。
