ISIP-CART/AutoFollowShoppingCart/design/structure.md

# 自主跟随购物车项目｜周二调研与初步设计讨论记录

> 项目方向：基于 OpenBot 的自主跟随购物车原型  
> 会议目标：完成需求分析、功能分析、初步架构设计、技术方案调研、WBS、里程碑与甘特图初稿。

---

## 0. 今日任务清单

| 序号 | 任务 | 是否完成 | 负责人 | 备注 |
| -- | --- | ---- | --- | -- |
| 1  | 每组分工到人 | ☐ | | 待结合成员特长最终确认 |
| 2  | 完成 WBS 工作分解 | ☐ | | 第 11 节起继续完善 |
| 3  | 制定阶段性里程碑 | ☐ | | 第 12 节起继续完善 |
| 4  | 制定甘特图 | ☐ | | 第 13 节起继续完善 |
| 5  | 完成相关技术、方法、工具、竞品调研 | ☑ | | 前 10 节已形成第一版结论 |
| 6  | 分析前沿技术 / AI 技术应用 | ☑ | | 已完成首版筛选，聚焦轻量级视觉方案 |
| 7  | 梳理每个人负责内容的技术路线 | ☐ | | 第 10 节已给出可选分工框架 |
| 8  | 每人提出至少 2 个方案并对比优缺点 | ☑ | | 第 10 节已补充方案对比模板内容 |
| 9  | 明确应用场景、目标、利益攸关者、需求、性能指标 | ☑ | | 第 1-4 节已补充完善 |
| 10 | 完成系统初步设计：需求分析、用例、功能架构 | ☑ | | 第 5-7 节已补充第一版 |

---

# 1. 项目基本定义

## 1.1 一句话项目定义

> 本项目旨在：
> “基于 OpenBot 开源平台，构建一台面向室内超市场景、可低速稳定跟随指定用户的低成本自主跟随购物车原型。”

---

## 1.2 项目背景

### 现实背景

传统购物车需要购物者持续手动推动，购物过程中占用双手，在拿取商品、照看随身物品或携带儿童时不够便利；购物结束后，购物车的归位和管理也需要额外人工维护。现有商用跟随机器人或智能购物车成本较高，难以直接作为教学实践和低成本原型验证平台。

### 技术背景

OpenBot 提供了以 Android 手机为核心计算平台的低成本机器人架构，可复用手机摄像头、算力、通信与交互能力；结合轻量级人物检测、目标跟踪、端侧 AI 推理和微控制器底盘控制，可以较低成本实现自主跟随类应用原型。

---

## 1.3 问题定义

目前存在的问题：

1. 传统购物车需要人工推动
2. 传统购物车在购物结束后需要人工维护把它放回指定位置
3. 跟随机器人价格高
4. 低成本平台缺少面向购物场景的应用验证

本项目拟解决的问题：

> 在低成本硬件条件下，实现一台能够在室内平坦环境中低速跟随用户、解决传统购物车人工推车问题的购物车原型。

进一步说，本项目要解决的是一个“可落地的课程原型”问题，而不是直接做商业化产品。系统应优先满足以下要求：

1. 基于 OpenBot 原有架构搭建，避免另起一套高复杂度系统。
2. 在室内平坦环境中实现稳定、可演示的单人跟随闭环。
3. 在目标丢失、急停、通信异常、前方障碍等情况下优先保证安全。
4. 在课程周期和预算内完成从硬件到软件的集成验证。

---

## 1.4 项目边界

| 类别 | 内容 |
| --- | --- |
| 必须完成 Must | OpenBot 基础链路跑通；手动遥控；指定人物检测与跟随；购物筐或载物平台集成；急停与通信异常停车；基础测试记录 |
| 应该完成 Should | 跟随距离与速度参数可调；前方障碍减速或停车；目标短时丢失后的有限搜索 / 重定位；演示流程标准化 |
| 可以尝试 Could  | 简单绕障；多人干扰测试；负载优化；UI 改造；视觉避障增强 |
| 暂不完成 Won’t  | 完整 SLAM；复杂路径规划；真实超市长期部署；自动结账；高精地图构建；云端多车调度 |

---

# 2. 应用场景分析

## 2.1 目标应用场景

| 项目 | 内容 |
| --- | -- |
| 使用地点 | 室内超市或模拟超市实验场地 |
| 地面条件 | 平坦地面，可存在瓷砖缝、缓坡、转角 |
| 目标用户 | 单个购物者 |
| 小车速度 | 低速，接近步行慢速 |
| 是否承重 | 需要承载购物筐和一定数量商品 |
| 是否有障碍物 | 有，主要为货架、转角、临时摆放物、行人 |
| 是否多人干扰 | 有，可能存在非目标行人穿行 |

---

## 2.2 典型使用流程

1. 用户打开系统 / 启动 OpenBot App。
2. 用户通过手动遥控模式确认底盘、转向、刹停和通信正常。
3. 用户选择“开始跟随”模式，先站在小车前方完成候选目标采集。
4. 系统检测候选目标并给出提示音 / 语音，保存临时截图和目标特征，进入待确认状态。
5. 用户回到手机旁确认截图中的目标身份；确认后系统进入“已确认但未启动”状态，车辆仍保持停止。
6. 用户重新回到车前视觉范围内，系统基于目标记忆完成重识别；只有连续稳定匹配并通过安全检查后，才倒计时进入自主跟随状态。
7. 用户在货架区域直行、转弯、短暂停留，小车保持安全距离跟随。
8. 若前方出现障碍物、目标丢失或通信异常，系统减速或停车。
9. 用户主动停止、切换回手动模式或触发急停，系统结束本次运行。

---

## 2.3 演示场景设计

| 演示环节 | 说明 | 成功标准 |
| --- | -- | ---- |
| 启动系统 | 上电、连接手机与下位机、进入待命状态 | 设备成功启动，手机端能看到控制界面，底盘待命稳定 |
| 手动遥控测试  | 验证前进、后退、转向、停止 | 指令响应正确，无明显失控或延迟过大 |
| 开始跟随 | 用户站到初始化区域完成候选目标采集，在手机上确认后重新回到车前进入视野 | 候选目标截图和提示反馈正确；确认后车辆仍保持停止；目标重识别稳定后完成倒计时启动 |
| 用户直线行走  | 用户以正常慢速向前行走 | 小车连续跟随，不明显蛇形摆动，不撞人 |
| 用户转弯 | 用户经过转角或弯道 | 小车能完成跟随转向且不明显偏离 |
| 用户停下取物  | 用户短暂停留 3-5 秒 | 小车同步减速并停止在安全距离内 |
| 前方出现障碍  | 人为放置纸箱 / 椅子等障碍物 | 小车减速或停车，不与障碍物接触 |
| 目标丢失 | 目标暂时离开视野或被遮挡 | 小车立即取消前进并进入短时原地搜寻；超时后发送 STOP 并停车 |
| 急停 / 停止 | 手动触发急停或停止按钮 | 小车立即停车，解除前不恢复运动 |

---

# 3. 利益攸关者分析

| 利益攸关者 | 关注点 | 对系统的要求 | 优先级 |
| --- | --- | --- | --- |
| 使用者 | 购物车不跟丢人、操作简单、承载稳定 | 跟随可靠、启停清晰、跟随距离舒适、具备紧急停止能力 | 高 |
| 超市 / 商家 | 成本、稳定性、维护难度、安全风险 | 方案低成本、结构易维护、演示过程安全可控 | 高 |
| 课程教师 / 助教 | 项目完成度、工程规范、文档质量 | 架构合理、分工清晰、过程可复盘、交付物完整 | 高 |
| 其他顾客 / 路人 | 不被碰撞、不被妨碍通行 | 小车限速运行、遇人或障碍可减速停车、急停可用 | 中 |
| 项目组成员 | 开发难度、时间与预算可控 | 复用 OpenBot，优先完成闭环原型，避免过度扩张 | 高 |

---

# 4. 需求分析

## 4.1 功能需求

| 编号 | 功能需求 | 说明 | 优先级 | 验收方式 |
| ----- | ---- | -- | --- | ---- |
| FR-01 | 手动遥控 | 用户可通过 OpenBot App 控制底盘前进、后退、转向、停止 | Must | 手动模式下完成基本运动测试 |
| FR-02 | 人物检测与目标锁定 | 系统能够检测视野中的人，并锁定指定用户作为跟随目标 | Must | 初始化后稳定识别目标并进入跟随状态 |
| FR-03 | 自主跟随 | 小车依据目标相对位置输出速度和转向指令，低速跟随用户 | Must | 完成直线、转弯、停下三类场景测试 |
| FR-04 | 模块化购物筐 / 载物平台集成 | 小车具备稳定承载购物筐与轻量商品的结构，首版优先采用“机械限位 + 磁吸辅助固定 + 快拆”的模块化购物筐方案 | Must | 装载后可正常行驶和停止，无明显松动、偏移、倾覆；购物筐可拆装维护 |
| FR-05 | 目标丢失安全搜寻与异常停车 | 目标丢失时系统立即取消前进，进入短时原地搜寻；若超时未找回目标，或出现急停、通信异常、程序异常，则必须停车 | Must | 丢失目标与异常测试中，小车按预期执行搜寻和停车 |
| FR-06 | 障碍物减速 / 停车 | 前方存在障碍物时，小车能够减速或停车避免碰撞 | Should | 障碍测试中不与障碍物接触 |
| FR-07 | 跟随参数可调 | 可调整目标距离、最大速度、转向灵敏度等关键参数 | Should | 至少可通过配置或界面修改并生效 |
| FR-08 | 状态显示与模式切换 | 系统可显示当前模式、连接状态、跟随状态，并支持模式切换 | Should | 用户能完成手动 / 跟随 / 停止切换 |
| FR-09 | 结构快拆与维护 | 购物筐模块、手机支架和电源固定应便于调试、运输和替换，且拆装后能恢复定位 | Should | 拆装后重复完成空载和 1-3 kg 负载低速行驶测试 |
| FR-10 | 候选目标采集 | 开始跟随时系统应先采集候选目标并保存临时截图与基础特征，不得在未确认前直接启动车辆 | Must | 能完成候选目标采集并进入待确认界面，车辆保持停止 |
| FR-11 | 目标确认界面 | App 应显示候选目标截图、目标框和确认 / 重拍 / 取消操作，供用户确认目标身份 | Should | 用户可在界面完成确认、重拍或取消，状态切换正确 |
| FR-12 | 确认后重识别启动 | 用户确认后必须重新回到车前视觉范围内，系统连续稳定匹配目标并通过安全检查后才允许启动跟随 | Must | 确认后不会立即起步；未重识别成功时车辆保持停止 |
| FR-13 | 目标记忆与重识别 | 系统应维护目标的边框、颜色特征、最近位置、短时运动信息，并预留 / 接入 ReID embedding 用于多人场景下保持目标身份与重识别 | Must | 短时遮挡或路人穿行时不轻易切换到陌生目标；ReID 未接入时系统仍可降级运行 |
| FR-14 | 声音 / 语音与可视反馈 | 系统在采集成功、确认成功、开始跟随、目标丢失等关键节点应提供提示音 / 语音和界面状态反馈 | Should | 用户能在不盯着屏幕时判断系统当前阶段 |
| FR-15 | Human Cart Simulator 无底盘实时调试模式 | 在硬件未联调完成前，App 应支持由测试者手持手机模拟购物车，实时显示前进 / 转向 / 停止 / 搜索提示而不真正发动车辆 | Must | 可在无底盘条件下形成“视觉 - 决策 - 人工执行 - 视觉反馈”的近似闭环验证 |

---

## 4.2 非功能需求

| 编号 | 非功能需求 | 指标 / 约束 | 优先级  | 验收方式 |
| --- | ----- | --- | ---- | --- |
| NFR-01 | 成本 | 课程预算总额原则上不超过 7500 元；首版核心平台尽量控制在 1500-3000 元区间 | Must | BOM 核算、采购记录 |
| NFR-02 | 安全性 | 目标丢失时先取消前进并执行短时低风险搜寻；超时、急停、通信异常、程序异常时进入停车状态 | Must | 专项安全测试 |
| NFR-03 | 可靠性 | 连续运行过程中不频繁掉线、不频繁崩溃，关键功能可重复演示 | Must | 重复测试记录 |
| NFR-04 | 实时性 | 人物检测到控制输出存在可接受延迟，跟随过程无明显拖尾 | Must | 视频观察与测试记录 |
| NFR-05 | 可维护性  | 机械、电控、软件模块边界清晰，购物筐模块和手机支架便于拆装、替换与调参 | Should | 结构图、接线图、代码说明、拆装复测记录 |
| NFR-06 | 可展示性  | 具备稳定演示流程，启动、跟随、停车、急停过程清晰可展示 | Must | 演示脚本验证 |
| NFR-07 | 可扩展性  | 后续可增加避障增强、多人干扰测试、自动返回等功能 | Should | 架构说明与模块化设计 |
| NFR-08 | 结构安全裕量 | 磁吸只作为辅助固定和快拆便利手段，主要抗位移能力应由机械限位、螺丝 / 扎带 / 卡扣等结构件承担 | Must | 加减速、转弯、急停和负载测试中购物筐不脱落、不明显滑移 |
| NFR-09 | 隐私与会话边界 | 目标确认截图和目标记忆默认仅在本次会话内临时保存，不写入系统相册、不上传网络；仅调试模式下可额外保存日志图片 | Should | 本地检查存储目录与运行流程，确认默认不会留下持久化个人图像 |

---

## 4.3 性能指标

| 指标 | 目标值 | 测试方法 | 是否必须达成 |
| --- | --- | ---- | --- |
| 跟随速度 | 0.3-0.8 m/s | 直线跟随测试，测量一定距离内用时 | 是 |
| 跟随距离 | 1.0-2.0 m 可调 | 在不同参数下测量目标与车体间距 | 是 |
| 连续跟随距离 | 不少于 30 m | 在室内路线中连续行走测试 | 是 |
| 目标丢失停车时间 | 搜寻超时后 1 s 内完成停车 | 人为遮挡或目标离开画面后计时，记录从超时到停车完成的时长 | 是 |
| 急停响应时间 | 不超过 0.5 s | 手动触发急停并视频计时 | 是 |
| 负载能力 | 首版按原型机口径实现购物筐 + 1-3 kg 物品稳定运行；更高载重以后续底盘实测为准 | 负载测试 | 是 |
| 最小转弯半径 | 不大于 1.0 m | 标记路线转弯测试 | 否 |
| 障碍停车距离 | 距障碍物至少保留 0.3 m 安全余量 | 障碍接近测试 | 是 |
| 单次运行时间 | 不少于 20 min | 满电条件下连续演示测试 | 是 |

---

## 4.4 约束条件

| 约束类型 | 具体约束 | 对方案的影响 |
| ---- | --- | --- |
| 人员 | 小组 3 人 | 需要控制任务并行度，分工应围绕机械 / 电控 / 算法集成展开 |
| 预算 | 每人预算原则上不超过 2500 元 | 需优先复用现有设备，避免高价激光雷达和高性能计算平台 |
| 时间 | 4 周集中实践 | 首版目标必须收敛，优先闭环演示而非全面功能铺开 |
| 平台 | 必须基于 OpenBot 架构 | 计算核心优先使用 Android 手机，底盘控制围绕 OpenBot 兼容方案设计 |
| 场地 | 室内、平地、有货架、有少量行人 | 算法应适应狭窄通道、遮挡和多人干扰，速度需保守 |
| 安全 | 不允许失控冲撞，需具备人工紧急干预手段 | 必须加入急停、限速、异常停车和结构稳固性设计 |
| 技术基础 | 小组需同时处理机械、电控、Android / AI 集成 | 方案应以成熟开源模块复用为主，减少从零开发 |
| 采购周期 | 元器件采购和加工存在等待时间 | 物料需尽早确定，结构件优先选择标准件和易加工方案；磁铁、限位件和快拆件应与底盘尺寸同步确认 |

---

# 5. 用例分析

## 5.1 用例列表

| 用例编号  | 用例名称 | 参与者 | 简述 | 优先级 |
| ----- | --- | --- | -- | --- |
| UC-01 | 手动遥控小车 | 用户 | 用户通过 App 遥控小车并检查底盘状态 | Must |
| UC-02 | 开始自主跟随与目标确认 | 用户 | 用户发起跟随模式，系统完成候选目标采集、确认与重识别后开始跟随 | Must |
| UC-03 | 用户停下后小车停止 | 用户 | 用户短暂停留时，小车减速并保持安全距离停车 | Must |
| UC-04 | 目标丢失后安全搜寻与停车 | 用户、系统 | 目标离开视野时，小车立即取消前进，短时原地搜寻，超时后停车 | Must |
| UC-05 | 前方障碍停车 | 系统 | 系统检测到障碍物后减速或停车，避免碰撞 | Should |
| UC-06 | 故障急停 | 用户、系统 | 用户主动急停或系统检测到异常后立即停车 | Must |
| UC-07 | 重新开始跟随 | 用户 | 停车后重新锁定目标并恢复跟随 | Should |

---

## 5.2 详细用例

### UC-01 手动遥控小车

| 项目 | 内容 |
| ---- | --- |
| 参与者  | 用户 |
| 前置条件 | 小车已上电，手机与下位机连接正常 |
| 基本流程 | 1. 用户打开 OpenBot App；2. 进入手动模式；3. 执行前进、后退、转向、停止操作；4. 观察底盘响应 |
| 异常流程 | 若通信异常或控制异常，系统停车并提示切换到安全状态 |
| 后置条件 | 完成底盘联调，系统可进入跟随模式 |
| 成功标准 | 基本运动方向正确，停止可靠，无明显失控或严重延迟 |

---

### UC-02 开始自主跟随与目标确认

| 项目 | 内容 |
| ---- | --- |
| 参与者  | 用户、系统 |
| 前置条件 | 手动模式测试通过，摄像头与检测模型工作正常 |
| 基本流程 | 1. 用户在 App 中点击开始跟随；2. 用户站到车前方 1-2 m 区域，系统采集候选目标并给出提示音 / 语音；3. 系统保存临时截图和目标特征，进入待确认状态；4. 用户回到手机旁确认候选目标，必要时可重拍或取消；5. 用户确认后系统进入已确认但未启动状态，车辆保持停止；6. 用户重新回到车前视觉范围内，系统基于目标记忆连续稳定匹配目标；7. 系统完成倒计时提示后进入 FOLLOW 状态并开始低速跟随 |
| 异常流程 | 若未检测到用户、候选目标不稳定、用户取消确认、确认后未重新识别到目标，或安全检查未通过，系统保持停止并提示重新采集或重新进入视野 |
| 后置条件 | 系统进入 FOLLOW 状态，且目标身份已经过用户确认 |
| 成功标准 | 能完成候选目标采集、用户确认、确认后重识别和安全起步，不出现未确认即启动或明显误跟随 |

---

### UC-03 目标丢失后安全搜寻与停车

| 项目 | 内容 |
| ---- | --- |
| 参与者  | 系统 |
| 前置条件 | 小车已处于 FOLLOW 状态 |
| 基本流程 | 1. 目标因遮挡或离开视野而丢失；2. 系统立即将线速度置零，取消继续前进的跟随指令；3. 系统进入 LOST 状态并启动短时搜索计时；4. 小车仅允许原地低速左右扫描，不允许继续前向位移；5. 若在阈值内重新检测到目标，则回到 FOLLOW；6. 若超时仍未找回目标，则发送 STOP 指令并进入 STOP 状态 |
| 异常流程 | 若搜索期间检测到障碍、急停或通信异常，则立即进入 OBSTACLE、EMERGENCY 或 STOP 状态 |
| 后置条件 | 小车停车，等待重新初始化目标或人工干预 |
| 成功标准 | 目标丢失后小车不继续盲目前进，短时搜寻动作受限且超时后可靠停车 |

---

### UC-04 前方障碍停车

| 项目 | 内容 |
| ---- | --- |
| 参与者  | 系统 |
| 前置条件 | 小车处于 FOLLOW 或 MANUAL 慢速行驶状态，障碍检测链路有效 |
| 基本流程 | 1. 前方出现静态障碍物；2. 系统识别障碍物进入安全判断；3. 小车减速或停车；4. 障碍解除后由用户决定是否继续 |
| 异常流程 | 若障碍检测不稳定，系统应优先采取保守停车策略 |
| 后置条件 | 系统进入 OBSTACLE 或 STOP 状态 |
| 成功标准 | 小车不与障碍物接触，停车位置可控 |

---

### UC-05 故障急停

| 项目 | 内容 |
| ---- | --- |
| 参与者  | 用户、系统 |
| 前置条件 | 小车处于任意运动状态 |
| 基本流程 | 1. 用户按下急停按钮或系统检测到严重异常；2. 系统立即发送停车指令；3. 下位机切断运动输出；4. 等待人工确认后恢复 |
| 异常流程 | 若上位机失联，下位机应依靠超时保护主动停车 |
| 后置条件 | 系统进入 EMERGENCY 状态 |
| 成功标准 | 小车能快速停车，且未解除急停前不会再次启动 |

---

# 6. 功能架构

## 6.1 功能模块拆分

```text
自主跟随购物车系统
├─ 感知模块
│  ├─ 手机摄像头
│  ├─ 人物检测 / 目标跟踪
│  └─ 障碍物感知（超声波或视觉，按方案选用）
├─ 决策模块
│  ├─ 目标初始化、确认与重识别
│  ├─ 目标记忆、状态机与跟随控制策略
│  └─ 安全策略与模式切换
├─ 控制模块
│  ├─ 手机上的速度 / 转向指令生成
│  ├─ 单片机串口解析与执行
│  └─ 电机驱动与底盘运动控制
├─ 交互模块
│  ├─ OpenBot App 界面
│  ├─ 模式切换与参数配置
│  └─ 状态显示与调试信息
├─ 安全模块
│  ├─ 急停
│  ├─ 通信超时停车
│  └─ 目标丢失 / 障碍物停车
└─ 结构模块
   ├─ 移动底盘
   ├─ 手机支架与电源固定
   └─ 模块化购物筐 / 载物平台
      ├─ 机械限位
      ├─ 磁吸辅助固定
      └─ 快拆与防滑缓冲
```

---

## 6.2 功能模块说明

| 模块 | 子功能 | 输入 | 输出 | 负责人 |
| ---- | --- | -- | -- | --- |
| 感知模块 | 图像采集、人物检测、目标跟踪、障碍感知 | 摄像头图像、传感器数据 | 目标位置、障碍状态 | 待分工 |
| 决策模块 | 目标初始化与确认、目标记忆、状态机、跟随控制、安全判断 | 目标位置、障碍状态、系统状态、用户确认输入 | 速度 / 转向目标、模式切换指令、目标状态 | 待分工 |
| 控制模块 | 指令下发、串口通信、电机驱动控制 | 速度 / 转向目标、模式控制命令 | PWM / 电机控制信号、底盘动作 | 待分工 |
| 交互模块 | 模式切换、状态显示、参数调整、调试日志、候选目标确认反馈 | 用户输入、系统状态、候选目标截图 | 界面反馈、配置参数、提示音 / 语音 | 待分工 |
| 安全模块 | 急停、异常停车、通信超时保护 | 急停信号、丢失目标信号、障碍信号 | 停车指令、故障状态 | 待分工 |
| 结构模块 | 底盘装配、支架固定、模块化购物筐集成、重心设计、快拆维护 | 底盘、支架、载物结构、磁吸件、限位件 | 可运行车体平台 | 待分工 |

---

# 7. 初步系统架构设计

## 7.1 系统总体架构

```text
购物者 / 目标人物
        ↓
Android 手机 / OpenBot App
（摄像头感知 + AI 推理 + 跟随决策 + 人机交互）
        ↓
通信接口：USB Serial / Bluetooth
        ↓
微控制器：Arduino Nano / ESP32
（指令解析 + 电机控制 + 超时保护）
        ↓
电机驱动模块
        ↓
移动底盘
        ↓
购物筐 / 载物平台

可选侧链：
障碍传感器 / 电源监测 → 微控制器 / 手机 → 安全模块
```

---

## 7.2 数据流

| 数据 | 来源 | 去向 | 作用 |
| --- | -- | -- | -- |
| 图像帧 | 手机摄像头 | 手机端感知与决策模块 | 获取人物和环境信息 |
| 人物检测结果 | 感知模块 | 目标初始化 / 跟踪模块、决策模块 | 判断目标是否存在、候选目标质量及其位置 |
| 候选目标截图与特征 | 目标初始化模块 | 目标确认界面、目标记忆模块 | 支持用户确认目标身份并建立本次会话目标基线 |
| 目标记忆 | 目标记忆模块 | 决策模块 | 支持重识别、多人干扰抑制和目标丢失后的有限重定位 |
| 目标位置 / 距离估计 | 决策模块 | 跟随控制器 | 生成速度与转向控制量 |
| 速度指令 | 手机端控制模块 | 微控制器 | 下发线速度 / 转向速度目标 |
| 电机控制信号 | 微控制器 | 电机驱动模块 | 驱动左右轮或差速底盘 |
| 障碍物信息 | 障碍传感器 / 视觉模块 | 安全模块 / 决策模块 | 触发减速、停车或绕障策略 |
| 急停信号 | 用户 / 安全模块 | 微控制器 / 电机驱动 | 强制停止运动输出 |
| 状态信息 | 微控制器、手机端 | App 界面 / 日志 | 展示连接状态、模式状态、异常状态 |

---

## 7.3 控制流程

```text
开始
  ↓
系统初始化
  ↓
手机与下位机建立连接
  ↓
手动模式自检：遥控、转向、停止、通信状态确认
  ↓
选择模式：手动遥控 / 自主跟随
  ↓
若为自主跟随：
  图像采集 → 人物检测 → 候选目标采集 → 用户确认 → 重新进入视野重识别 → 倒计时启动 → 跟随控制计算 → 发送速度指令
  ↓
下位机接收指令 → 电机执行
  ↓
安全检查：目标丢失 / 障碍物 / 急停 / 通信异常 / 程序异常
  ↓
若目标丢失：
  立即取消前进速度 → 进入 LOST → 原地低速短时搜索 → 找回目标则恢复 FOLLOW，超时则发送 STOP
  ↓
其他异常则停车并切换状态
  ↓
正常则继续运行
```

---

## 7.4 状态机设计

| 状态 | 说明 | 进入条件 | 退出条件 |
| --- | -- | ---- | ---- |
| INIT 初始化 | 系统上电、自检、建立连接 | 开机 | 自检完成并进入 IDLE / STOP |
| MANUAL 手动模式 | 用户通过 App 遥控底盘 | 用户选择手动模式 | 用户切换到 CAPTURE_TARGET、STOP 或保持手动 |
| IDLE 待命 | 系统就绪但未开始目标初始化 | INIT 完成或 STOP 后待命 | 用户开始目标初始化或切换到 MANUAL |
| CAPTURE_TARGET 候选目标采集 | 用户站到车前方后，系统采集候选目标、临时截图和基础特征 | 用户点击开始跟随 | 采集成功进入 LOCKED_PENDING_CONFIRM，失败则回到 IDLE 或继续采集 |
| LOCKED_PENDING_CONFIRM 待确认 | 系统已锁定候选目标，等待用户在手机端确认 / 重拍 / 取消 | CAPTURE_TARGET 成功 | 用户确认进入 CONFIRMED_ARMED；重拍回到 CAPTURE_TARGET；取消回到 IDLE |
| CONFIRMED_ARMED 已确认待启动 | 目标身份已确认，但车辆仍保持停止，等待用户重新回到车前视野 | 用户确认候选目标 | 进入 REACQUIRE_TARGET 或用户取消回到 IDLE |
| REACQUIRE_TARGET 重识别启动 | 系统根据目标记忆重新识别确认后的目标，要求连续稳定匹配 | 用户回到车前视野 | 稳定匹配后进入 READY_TO_FOLLOW；超时则回到 IDLE 或重新采集 |
| READY_TO_FOLLOW 倒计时启动 | 目标已稳定识别并通过安全检查，倒计时后才允许起步 | REACQUIRE_TARGET 稳定匹配 | 倒计时结束进入 FOLLOW；异常则回到 CONFIRMED_ARMED 或 STOP |
| FOLLOW 自主跟随 | 系统锁定目标并输出跟随控制 | READY_TO_FOLLOW 倒计时结束 | 目标丢失、障碍触发、急停、人工停止 |
| LOST 目标丢失 | 系统暂时失去目标，立即取消前进速度并启动安全搜寻计时 | FOLLOW 中目标检测失效 | 进入 SEARCH、重新锁定目标或进入 STOP |
| SEARCH 目标搜索  | 执行短时原地低速左右扫描，不允许继续前向位移 | LOST 后启用搜索策略 | 找回目标回到 FOLLOW，超时则 STOP |
| OBSTACLE 障碍停车 | 前方障碍触发安全停车 | 障碍判断成立 | 障碍解除并经人工确认恢复 |
| EMERGENCY 急停  | 急停或严重故障状态 | 用户急停、通信故障、程序故障 | 人工复位后回到 STOP |
| STOP 停止 | 车辆静止待命 | 人工停止或异常停车结束 | 用户重新选择模式 |

---

# 8. 技术调研记录

## 8.1 OpenBot 平台调研

| 调研项 | 结论 | 对本项目的启发 | 来源 |
| --- | -- | --- | -- |
| OpenBot 定位 | 面向低成本移动机器人研究与教学，核心思路是“以智能手机作为机器人大脑” | 适合本项目预算和课程型原型定位，应尽量沿用其手机 + 下位机的总体思路 | OpenBot 官网 / GitHub / 论文 |
| Android App 功能 | 提供遥控、视觉、模型推理、数据采集、模式切换等能力 | 手机上位机可承担感知、跟随决策和交互，减少额外计算平台需求 | OpenBot 官网 / GitHub |
| Firmware 功能 | 下位机负责接收控制命令、驱动电机、上传基础状态 | 本项目应将底盘控制和安全超时保护放在下位机侧实现 | OpenBot GitHub |
| 支持的控制板 | OpenBot 原生生态可对接 Arduino 类或兼容微控制器方案 | 可优先选择 Arduino Nano 或 ESP32，兼顾资料丰富度和成本 | OpenBot GitHub / 项目调研 |
| person following 能力 | OpenBot 已支持人物跟随类任务和视觉导航研究 | 可在其基础上做购物车场景适配，而非完全自研整套跟随框架 | OpenBot 官网 / GitHub |
| 通信方式 | 典型为手机与下位机之间的串口类通信，也可扩展蓝牙 | 首版以稳定优先，建议优先采用 USB Serial 等成熟链路 | OpenBot GitHub / 项目调研 |
| 可复用部分 | App 基础框架、手机支架思路、固件通信链路、遥控与基础运动控制 | 先复现再改造，缩短从零起步时间 | OpenBot 官网 / GitHub |
| 需要修改部分 | 车体结构、购物筐集成、安全停车逻辑、目标初始化流程、演示流程 | 本项目的重点不在重写 OpenBot，而在场景化集成和安全增强 | 本项目分析 |

---

## 8.2 相关技术调研

| 技术方向 | 可选方法 / 工具 | 优点 | 缺点 | 是否采用 |
| ---- | --- | -- | -- | ---- |
| 人物检测 | MobileNet-SSD、YOLO 系列轻量模型 | 模型成熟，移动端资料多，可在手机端部署 | 精度与速度需权衡，复杂遮挡下可能不稳定 | 采用轻量模型 |
| 目标跟踪 | 检测框中心跟随、检测 + 简单跟踪器、短时重定位 | 实现简单，适合课程周期 | 遮挡和多人干扰下鲁棒性有限 | 采用“检测 + 简单跟踪” |
| 跟随控制 | 基于目标横向偏差和距离的规则控制 / PID | 实现快、易解释、便于调参 | 平滑性和泛化不如复杂学习方法 | 采用规则控制或 PID |
| 避障检测 | 超声波、红外、纯视觉、深度摄像头 | 超声波低成本，视觉集成度高 | 超声波信息有限，纯视觉实现复杂 | 首版优先超声波或保守视觉停车 |
| 电机控制 | Arduino / ESP32 + 电机驱动模块 | 资料丰富、成本低、易调试 | 需自行处理供电和抗干扰问题 | 采用 |
| 通信方式 | USB Serial、蓝牙 | 串口稳定，蓝牙部署灵活 | 蓝牙调试和抗干扰性相对差 | 首版优先 USB Serial |
| 人机交互 | OpenBot App、状态灯、物理开关 | 复用现有界面，开发成本低 | 展示效果受现有界面限制 | 采用 App + 必要物理急停 |
| 测试工具 | 卷尺、手机录像、标记点、日志记录 | 简单实用，适合课程项目 | 精度有限，需要重复测试 | 采用 |

---

## 8.3 竞品调研

| 竞品 / 项目 | 类型 | 核心功能 | 优点 | 局限 | 对本项目启发 |
| --- | --- | ---- | -- | -- | --- |
| OpenBot | 开源低成本机器人平台 | 手机遥控、视觉推理、移动底盘控制 | 开源、低成本、架构清晰、适合教学实践 | 原始结构不直接等于购物车，需要二次集成 | 作为主平台复用，减少底层重复开发 |
| Caper Cart / 智能购物车 | 商用智能购物车 | 购物辅助、商品识别、用户交互 | 功能完整、体验成熟 | 成本高、闭源、系统复杂 | 我们只借鉴场景价值，不追求全功能复制 |
| 自动跟随行李箱 / 手推车 | 跟随型载物机器人 | 跟随、避障、载物 | 应用目标相近，演示直观 | 多为产品展示，技术细节不透明 | 可参考跟随距离、安全策略和载物结构 |
| 传统遥控小车项目 | 教学 / 竞赛底盘 | 手动控制、基础运动 | 实现快、稳定性高 | 缺少自主感知与跟随能力 | 可作为失效降级方案和调试基线 |
| 高成本服务机器人平台 | 商业 / 科研平台 | 多传感器导航、复杂规划 | 性能强、功能丰富 | 成本高、开发门槛高 | 提醒我们控制范围，首版不追求 SLAM 全栈 |

---

# 9. AI 技术与创新点分析

## 9.1 AI 技术可应用点

| AI 技术 | 可用于本系统的环节 | 难度 | 是否纳入本期目标 | 备注 |
| --- | --- | --- | --- | -- |
| 人物检测 | 目标识别与初始化 | 中 | 是 | 首版核心 AI 能力 |
| 目标跟踪 | 跟随过程中的目标持续锁定 | 中 | 是 | 可采用轻量级跟踪策略增强稳定性 |
| 目标重识别 ReID  | 遮挡后重新识别特定用户 | 中到高 | 是 | 首版推荐接入，但必须保留无 ReID 时的降级运行路径 |
| 视觉避障 | 识别前方障碍并辅助减速 / 停车 | 中到高 | 选做 | 首版可先用超声波替代或补充 |
| 强化学习 / 模仿学习 | 优化跟随控制策略 | 高 | 否 | 不适合 4 周课程周期 |
| 多模态交互 | 语音提示、语音控制等 | 中 | 否 | 非核心功能，优先级低 |

---

## 9.2 本项目创新点

| 创新点 | 具体说明 | 体现方式 |
| --- | ---- | ---- |
| 场景创新 | 将 OpenBot 从通用移动机器人平台迁移到“室内购物辅助”具体场景 | 以购物筐载物、用户停取物、货架通道、多人干扰为约束设计系统 |
| 成本创新 | 利用现有智能手机承担感知、推理和交互，减少额外计算硬件 | 采用手机 + MCU + 低成本底盘的组合实现原型 |
| 结构创新 | 在原有小车底盘上完成购物筐、支架和重心设计改造 | 形成可承载商品且便于演示的购物车化结构 |
| 安全创新 | 将目标丢失、通信异常、急停、障碍停车纳入同一安全闭环 | 通过状态机、限速与硬件急停实现多层保护 |
| 工程集成创新  | 面向课程周期进行软硬件一体化集成和模块边界设计 | 形成感知、决策、控制、结构、测试一体化方案 |
| AI 应用创新 | 将轻量级人物检测与跟随控制嵌入真实可运行平台 | 在端侧设备上验证从视觉到运动控制的闭环 |
| 交互创新 | 将目标初始化设计为“候选采集 - 用户确认 - 重识别启动”的两阶段流程 | 通过提示音 / 语音、截图确认、倒计时启动降低误跟随和突然起步风险 |
| 调试创新 | 在硬件未到位前引入 Human Cart Simulator 实时仿真 | 由测试者手持手机执行屏幕提示，提前验证控制方向、目标保持和状态机逻辑 |

---

# 10. 个人负责内容与方案对比

## 10.1 成员 A：负责内容

负责人：成员 A
负责模块：建议分配给“算法与上位机”
主要目标：完成手机端感知、确认式目标初始化、ReID 增强目标记忆、跟随策略与参数调试

### 方案 A1

| 项目 | 内容 |
| --- | -- |
| 方案名称 | 基于 OpenBot 现有 App / 模型进行二次适配 |
| 技术路线 | 优先复现 OpenBot 原有视觉与控制链路，再针对人物跟随、确认式目标初始化、ReID 增强目标记忆、Human Cart Simulator 和状态机做小幅修改 |
| 所需工具 / 平台 | Android Studio、OpenBot 工程、手机、调试日志、Human Cart Simulator、可选轻量 ReID 模型 |
| 优点 | 起步快，和平台要求一致，便于在 4 周内形成闭环，也适合在硬件到位前先验证上位机逻辑并尝试 ReID 增强 |
| 缺点 | 受原有工程结构限制，自定义空间有限 |
| 风险 | 若对原工程理解不足，可能在调试阶段卡住 |
| 适用条件 | 时间紧、优先完成演示闭环、希望减少从零开发 |
| 是否推荐 | 是，建议作为首选方案 |

### 方案 A2

| 项目 | 内容 |
| --- | -- |
| 方案名称 | 自研独立视觉跟随 App 或外部算法模块 |
| 技术路线 | 使用自定义人物检测 / 跟踪逻辑，重建部分手机端感知与控制流程 |
| 所需工具 / 平台 | Android Studio、模型部署工具链、自定义调试框架 |
| 优点 | 可控性更强，便于深度定制特定功能 |
| 缺点 | 工作量大，联调风险高，容易偏离 OpenBot 主线 |
| 风险 | 课程周期内难以同时保证稳定性与完整度 |
| 适用条件 | 已充分掌握 OpenBot 工程，且首版复现非常顺利 |
| 是否推荐 | 否，建议作为备选或后续增强方向 |

### 成员 A 初步结论

> 推荐优先采用方案 A1，以 OpenBot 现有工程为基础做人物跟随、确认式目标初始化、ReID 增强目标记忆、Human Cart Simulator 与状态机适配，先完成“看得见、认得准、跟得上、停得住”的闭环。方案 A2 可作为后续扩展，用于在首版稳定后增强自定义能力。

---

## 10.2 成员 B：负责内容

负责人：成员 B
负责模块：建议分配给“下位机、通信与运动控制”
主要目标：完成底盘驱动、供电、手机-下位机通信、急停与基础安全执行链路

### 方案 B1

| 项目 | 内容 |
| --- | -- |
| 方案名称 | OpenBot 兼容差速底盘 + Arduino / ESP32 控制 |
| 技术路线 | 使用常见双轮差速或四轮底盘，微控制器接收手机指令驱动电机，实现串口通信、运动控制与急停 |
| 所需工具 / 平台 | Arduino IDE / PlatformIO、电机驱动、电源模块、标准底盘、加工工具 |
| 优点 | 成本低、资料多、便于快速联调，和 OpenBot 架构一致 |
| 缺点 | 需要较多时间处理电源、通信和电机控制细节 |
| 风险 | 电源选型不当或串口链路不稳会影响整车联调 |
| 适用条件 | 优先追求低成本、快速成型、课程内可交付 |
| 是否推荐 | 是，建议作为首选方案 |

### 方案 B2

| 项目 | 内容 |
| --- | -- |
| 方案名称 | 高配置底盘或增加额外计算硬件的增强方案 |
| 技术路线 | 采用更高功率底盘、更多传感器，甚至引入树莓派等辅助计算平台 |
| 所需工具 / 平台 | 更高成本底盘、额外传感器、扩展供电与安装结构 |
| 优点 | 功能扩展空间更大，后续可做更复杂算法 |
| 缺点 | 成本高、集成复杂、与 OpenBot 原生手机主脑思路偏离 |
| 风险 | 增加系统耦合度，调试难度和采购压力明显上升 |
| 适用条件 | 预算宽松、后续长期继续做 SRT / 竞赛扩展 |
| 是否推荐 | 否，首版不建议采用 |

### 成员 B 初步结论

> 推荐优先采用方案 B1，先完成稳定低成本底盘、供电、通信和安全停车执行链路，确保整车运动控制可靠。方案 B2 只适合在后续确认预算和时间都充裕时再考虑。

---

## 10.3 成员 C：负责内容

负责人：成员 C
负责模块：建议分配给“结构、安全、测试与项目交付”
主要目标：完成购物筐 / 载物平台改造、手机支架与重心设计、障碍检测集成、测试记录与汇报材料组织

### 方案 C1

| 项目 | 内容 |
| --- | -- |
| 方案名称 | 模块化购物筐：机械限位 + 磁吸辅助固定 + 快拆 |
| 技术路线 | 基于现成购物筐、底板、限位块、强磁铁、快拆螺丝 / 卡扣和防滑垫完成可拆装载物模块；机械限位承担主要抗位移能力，磁吸用于辅助定位和提升拆装便利性，同时串接急停、障碍传感器并建立测试记录表 |
| 所需工具 / 平台 | 购物筐、亚克力板 / 木板、限位块 / 角码、强磁铁、快拆螺丝 / 卡扣、防滑垫、手机支架、超声波模块、万用表、热熔胶、扎带、测试记录模板 |
| 优点 | 采购快、改造快、成本低，便于运输、拆装、调试和后续替换不同载物模块，最适合课程周期内稳定交付 |
| 缺点 | 磁吸固定能力需要实测验证，结构精细度有限，需要多次手工调整重心、限位间隙和安装位置 |
| 风险 | 若仅依赖磁吸或重心偏高，急停、转弯和颠簸时可能出现滑移、松动或倾覆 |
| 适用条件 | 优先追求快速成型、可测试、可展示 |
| 是否推荐 | 是，建议作为首选方案 |

### 方案 C2

| 项目 | 内容 |
| --- | -- |
| 方案名称 | 定制化结构件与更复杂集成方案 |
| 技术路线 | 通过 3D 打印、激光切割或定制支架完成更完整的购物车化结构，并增加更多固定件和外观优化 |
| 所需工具 / 平台 | 3D 打印 / 激光切割、定制结构件、更多加工时间 |
| 优点 | 结构更完整、外观更统一、后续扩展空间更大 |
| 缺点 | 加工与返工周期长，容易挤压联调和测试时间 |
| 风险 | 一旦加工尺寸不合适，返工成本和等待时间较高 |
| 适用条件 | 学校加工资源充足，且前期联调明显提前完成 |
| 是否推荐 | 否，首版不建议采用 |

### 成员 C 初步结论

> 推荐优先采用方案 C1，以“标准件 + 简单板材 + 现成购物筐 + 机械限位 + 磁吸辅助固定 + 快拆”的方式快速完成结构、安全和测试支撑，保证第 3 周前进入稳定联调。磁吸不作为唯一承力结构，必须配合限位件、紧固件和负载测试验证。方案 C2 更适合作为后续外观和结构优化方向。

---

# 11. WBS 工作分解结构

> 2026-07-10 更新：当前 WBS 图见 `design/WBS/WBS.png`，生成脚本见 `design/WBS/generate_wbs.py`。本节保留主文档口径，详细状态以 WBS 图和周报为准。

| WBS 编号 | 工作包 | 当前重点 | 负责人 | 预计周期 | 主要交付 |
| --- | --- | --- | --- | --- | --- |
| 1.0 | 项目管理与建模 | 需求、WBS、甘特图、SysML、周报和阶段材料 | 成员 C 主，A / B 配合 | 第 1-4 周 | 设计主文档、SysML 图、WBS 图、甘特图、周报、PPT/报告 |
| 2.0 | Android 上位机 | Human Cart Simulator、ReID、诊断日志、track/bbox gate、relock 与空间支持门控 | 成员 A | 第 1-3 周 | 可复盘的上位机策略闭环、Android APK、diagnostics 数据 |
| 3.0 | ESP32 / AT8236 下位机 | ESP32 与 AT8236 串口/WiFi 调控、轮向标定、限速、通信超时和急停保护 | 成员 B | 第 1-3 周 | 可低速调控的底盘链路、轮向/停车测试记录 |
| 4.0 | 结构与物资 | 手机支架、电池、线束、控制板固定，购物筐 / 载物平台安装 | 成员 C 主，B 配合 | 第 1-3 周 | 可运行车体平台、固定结构、载物平台 |
| 5.0 | 联调与安全 | 上位机复测、极低速真实底盘联调准入、目标丢失、障碍、急停 | A / B / C | 第 2-4 周 | 安全联调记录、目标丢失搜索/停车、通信异常停车、障碍停车 |
| 6.0 | 测试与交付 | diagnostics 复盘、测试记录、演示视频、PPT、海报、报告 | 成员 C 主，A / B 供稿 | 第 2-4 周 | 测试表、演示素材、最终展示材料 |

---

# 12. 阶段性里程碑

| 里程碑编号 | 时间节点 | 里程碑名称 | 验收标准 | 负责人 |
| ----- | --- | --- | ---- | --- |
| M1 | 第 1 周末 | 需求与基础方案收口 | 完成需求、WBS、BOM、OpenBot / 下位机方案分析和第 1 周阶段材料 | 成员 A / B / C |
| M2 | 第 2 周末 | 上位机策略闭环完成 | Human Cart Simulator、Android ReID、diagnostics、track/bbox gate 和 relock 策略形成可复盘闭环 | 成员 A 主，C 配合 |
| M3 | 第 3 周中前 | 真实底盘联调准入 | ESP32 / AT8236、轮向标定、通信超时停车、结构固定和上位机复测达到极低速真实底盘联调门槛 | 成员 A / B / C |
| M4 | 第 3 周末 | 购物车化与安全闭环 | 完成购物筐 / 载物平台、目标丢失搜索、通信异常停车、急停和基础障碍停车 | 成员 B / C 主，A 配合 |
| M5 | 第 4 周末 | 最终演示闭环完成 | 完成完整演示、测试记录、视频、PPT、海报、报告和现场预案 | 成员 C 主，A / B 配合 |

---

# 13. 甘特图草案

> 当前完整日级甘特图见 `design/gantt/autofollowshoppingcart-day-gantt.xlsx`，预览图见 `design/gantt/autofollowshoppingcart-day-gantt-preview.png`。

| 任务 | 第 1 周 | 第 2 周 | 第 3 周 | 第 4 周 | 负责人 |
| --- | --- | --- | --- | --- | --- |
| 需求 / 方案 / SysML / WBS | ███ | ██ |  |  | 成员 C 主，A / B 配合 |
| Human Cart Simulator | █ | ███ |  |  | 成员 A |
| ReID / diagnostics / track-bbox gate |  | ███ | █ |  | 成员 A |
| ESP32 / AT8236 实体调试 | █ | ███ | █ |  | 成员 B |
| 轮向标定 / 限速 / 通信超时停车 |  | ██ | ██ |  | 成员 B / C |
| 手机支架 / 线束 / 结构固定 |  | ██ | █ |  | 成员 C 主，B 配合 |
| 购物筐 / 载物平台 |  | █ | ███ | █ | 成员 C |
| 真实底盘极低速联调 |  |  | ██ | ██ | A / B / C |
| 目标丢失 / 障碍 / 急停安全闭环 |  | █ | ███ | █ | A / B / C |
| 测试记录 / 视频 / PPT / 报告 | █ | █ | ██ | ███ | 成员 C 主，A / B 供稿 |

填写建议：

* `███` 表示主要工作期
* `█` 表示少量工作或维护
* 空白表示暂不进行

---

# 14. 物料与工具初步清单

## 14.1 物料清单 BOM

| 序号 | 物料 | 型号 / 规格 | 数量 | 预计单价 | 预计总价 | 是否已有  | 负责人 | 备注 |
| -- | -- | --- | -- | ---- | ---- | ----- | --- | -- |
| 1  | 移动底盘 | 305 系列四驱差速底盘（12V 320rpm 编码器电机） | 1 | 405.90 | 405.90 | 是 | 成员 B | 已采购，后续重点验证负载与重心稳定性 |
| 2  | 微控制器 + 电机驱动 | ESP32 开发板套件 + AT8236 四路驱动板 | 1 套 | 120-140 | 131.06 | 是 | 成员 B | 已采购 2 件主板、2 件拓展板和 1 件驱动板，优先按 ESP32 路线推进 |
| 3  | 电源系统 | 12V 锂电池组 + 充电器 + 降压模块 | 1 套 | 220-250 | 224.00（不含降压模块） | 部分已有 | 成员 B | 电池和充电器已采购，降压模块仍待补购 |
| 4  | 手机支架与结构固定件 | 手机夹具、连接板、螺丝、扎带等 | 1 套 | 50-150 | 55.87（已购部分） | 部分已有 | 成员 C | 手机支架、铜柱、螺丝已采购，扎带等辅料可按装配需要补充 |
| 5  | 购物筐 / 载物平台 | 购物筐、亚克力板 / 木板 / 型材 | 1 套 | 100-250 | 100-250 | 否 | 成员 C | 首版按 1-3 kg 原型载物验证，需兼顾承载与重心稳定 |
| 6  | 机械限位与快拆固定件 | 限位块、角码、快拆螺丝 / 手拧螺丝、卡扣、螺母垫片 | 1 批 | 50-150 | 50-150 | 否 | 成员 C | 机械限位承担主要抗位移能力，方便购物筐拆装与复位 |
| 7  | 磁吸与防滑缓冲件 | 强磁铁、金属贴片 / 铁片、防滑垫、橡胶垫、泡棉垫 | 1 批 | 40-120 | 40-120 | 否 | 成员 C | 磁吸只作辅助固定和定位，需实测加减速、转弯、急停不滑移 |
| 8  | 急停与基础开关件 | 急停按钮、拨动开关、接线端子 | 1 套 | 30-80 | 30-80 | 否 | 成员 B / C | 安全必须项 |
| 9  | 障碍检测传感器 | 超声波模块等 | 1-2 | 15-40 | 30-80 | 否 | 成员 C | 首版优先用于减速 / 停车 |
| 10 | 线材与辅料 | 杜邦线、电源线、热熔胶、扎带等 | 1 批 | 30-80 | 32.35（已购部分） | 部分已有 | 成员 B / C | 杜邦线已采购，电源线和扎带等仍可按联调需要补充 |

预算合计：￥849.18+待补购项（基础闭环已购部分） / 预计仍控制在￥1300-2500（含结构与安全增强）
预期核心平台成本上限：￥3000
课程预算参考上限：￥2500 / 人
是否超预算：否（按当前采购记录与待补购估算）

---

## 14.2 工具清单

| 工具 | 用途 | 是否已有  | 负责人 | 备注 |
| --- | --- | ----- | --- | -- |
| Android Studio | OpenBot App 编译与调试 | 是 / 否 | 成员 A | 手机端开发核心工具 |
| Arduino IDE / PlatformIO | Firmware 烧录与调试 | 是 / 否 | 成员 B | 二选一即可 |
| Git / GitHub | 代码管理、版本留痕、协作 | 是 | 成员 C | 仓库已初始化并同步远端 |
| 3D 打印 / 激光切割 | 结构件制作与改造 | 是 / 否 | 成员 C | 若无法使用，可改用标准件和现成板材 |
| 万用表 | 电路测试与排障 | 是 / 否 | 成员 B | 建议必备 |
| 螺丝刀 / 热熔胶 / 扎带 | 底盘与结构装配 | 是 / 否 | 成员 B / C | 建议优先准备 |
| 手机录像 / 三脚架 | 演示记录与测试取证 | 是 / 否 | 成员 C | 用于测试留档和汇报材料 |
| 卷尺 / 地面标记工具 | 跟随距离、转弯和停车测试 | 是 / 否 | 成员 C | 用于量化测试 |

---

# 15. 测试计划

| 测试编号 | 测试内容 | 测试方法 | 成功标准 | 负责人 | 状态 |
| ---- | --- | ---- | ---- | --- | --- |
| T1 | 手动遥控 | 在手动模式下测试前进、后退、左转、右转、停止各 3 次 | 指令方向正确、停止可靠、无明显失控或严重延迟 | 成员 B 主，C 记录 | 未开始 / 进行中 / 完成 |
| T2 | 通信断开停车 | 在低速运行时人为断开手机与下位机通信 | 小车在超时阈值内停车，恢复通信前不自动继续运动 | 成员 B 主，C 记录 | 未开始 / 进行中 / 完成 |
| T3 | 单人直线跟随 | 目标用户沿直线行走不少于 10 m，重复 3 次 | 小车能稳定跟随，不明显蛇形摆动，不撞人 | 成员 A 主，C 记录 | 未开始 / 进行中 / 完成 |
| T4 | 单人转弯跟随 | 目标用户经过转角或弯道，重复 3 次 | 小车能完成转向跟随，不明显偏离或原地打转 | 成员 A 主，C 记录 | 未开始 / 进行中 / 完成 |
| T5 | 用户停下后停车 | 目标用户行进中突然停下并停留 3-5 秒 | 小车同步减速并在安全距离内停止 | 成员 A / B，C 记录 | 未开始 / 进行中 / 完成 |
| T6 | 目标丢失安全搜寻与停车 | 通过遮挡或离开画面制造目标丢失场景 | 小车立即取消前进，执行短时原地低速搜寻；若未找回目标，超时后发送 STOP 并停车 | 成员 A / B，C 记录 | 未开始 / 进行中 / 完成 |
| T6A  | 目标确认与重拍 | 在候选目标采集后测试确认、重拍和取消三种分支 | 系统能正确显示候选目标截图；重拍会回到采集状态；取消后车辆保持停止 | 成员 A，C 记录 | 未开始 / 进行中 / 完成 |
| T6B  | 确认后重识别启动 | 用户确认目标后离开画面，再重新回到车前进入视野 | 系统不会立即起步；只有连续稳定识别成功并完成倒计时后才进入 FOLLOW | 成员 A，C 记录 | 未开始 / 进行中 / 完成 |
| T6C  | 多人短时穿行防误跟随 | 跟随过程中安排路人从目标前方短时穿过或并行出现 | 系统优先保持已确认目标身份，不因短时遮挡或更大目标框直接切换到陌生人 | 成员 A，C 记录 | 未开始 / 进行中 / 完成 |
| T6D  | ReID 重识别验证 | 目标短时离开画面或被遮挡后重新出现，比较 ReID 开启 / 关闭时的表现 | ReID 开启后目标恢复更稳定；若 ReID 失败，系统应降级为保守停止或等待，而不是直接跟错人 | 成员 A，C 记录 | 未开始 / 进行中 / 完成 |
| T6E  | Human Cart Simulator 实时仿真 | 一人手持手机模拟底盘，另一人充当目标，按屏幕提示完成近似闭环测试 | 屏幕提示与目标相对位置变化一致，测试者可据此完成前进、转向、停止和搜索动作 | 成员 A，C 记录 | 未开始 / 进行中 / 完成 |
| T7 | 障碍停车 | 在小车前方放置静态障碍物并重复测试 | 小车减速或停车，不与障碍物接触，保留安全余量 | 成员 C 主，B 配合 | 未开始 / 进行中 / 完成 |
| T8 | 购物筐负载 | 载物平台放置购物筐及约 1-3 kg 物品后运行 | 底盘行驶稳定，结构无明显松动、倾斜或擦地；更高载重只作为后续实测扩展 | 成员 C 主，B 配合 | 未开始 / 进行中 / 完成 |
| T9 | 购物筐快拆与固定复测 | 拆下并重新安装购物筐模块后，进行空载、1 kg、3 kg 三档低速直行、转弯、急停测试 | 购物筐能重复定位，磁吸 / 限位 / 快拆结构无明显松动或滑移 | 成员 C 主，B 配合 | 未开始 / 进行中 / 完成 |
| T10  | 模拟购物场景完整演示 | 按既定演示脚本完成启动、跟随、停下、目标丢失、障碍、急停全流程 | 全流程可完成，关键环节清晰可展示，演示可复现 | 成员 C 主，A / B 配合 | 未开始 / 进行中 / 完成 |

---

# 16. 风险分析与降级方案

| 风险编号 | 风险 | 可能原因 | 影响 | 概率 | 应对策略 | 降级方案 |
| ---- | --- | ---- | --- | --- | ---- | ---- |
| R1 | OpenBot App 编译失败 | 环境配置不完整、依赖版本不兼容、手机端权限问题 | 高 | 中 | 提前在第 1 周完成环境搭建和最小编译验证，记录依赖版本与构建步骤 | 若短期无法稳定修改 App，则优先复现基础遥控链路，减少首版自定义改动 |
| R2 | 手机与控制板通信失败 | 串口配置错误、线材问题、驱动板接线错误、供电不稳 | 高 | 中 | 优先采用成熟通信链路；分层排查手机、串口、MCU、电机驱动；保留串口日志 | 无法完成自动跟随时，先确保手动遥控与底盘可控，演示基础链路 |
| R3 | 人物跟随效果不稳定 | 光照变化、遮挡、多人干扰、模型精度不足、参数未调好 | 高 | 高 | 先在受控单人场景调通；限制车速；逐步增加复杂度；保留多组参数 | 降级为单人、直线、低速演示，弱化复杂转角和多人干扰场景 |
| R3A  | 目标初始化误锁定 | 初始化阶段候选目标选择错误、多人同时入镜、用户未确认即启动 | 高 | 中 | 引入候选目标截图确认、确认后重识别和倒计时启动；未确认前禁止起步 | 降级为单人受控初始化区域演示，并保留重拍 / 取消机制 |
| R3B  | ReID 模型部署或实时性不达标 | TFLite 转换失败、手机端推理过慢、多人场景全量 ReID 掉帧 | 中到高 | 中 | 采用事件触发式 ReID；优先预留接口并低频运行；保留颜色特征和运动连续性的降级路径 | 若 ReID 无法稳定运行，则关闭 ReID，仅保留轻量跟踪与保守状态机 |
| R4 | 购物筐加装后重心不稳 | 购物筐位置过高、载物偏置、底盘尺寸不足 | 高 | 中 | 先空载验证再逐步加重；降低重心；扩大支撑面；优化安装位置 | 减少负载重量，改为轻量演示载物，优先保证安全和跟随稳定 |
| R4A  | 磁吸 / 快拆结构固定不足 | 磁铁吸力不足、限位件间隙过大、快拆件松动、急停或转弯冲击较大 | 高 | 中 | 磁吸只做辅助固定，主要抗位移依赖机械限位；进行拆装复测、急停复测和 1-3 kg 负载复测 | 取消磁吸快拆，改为螺丝、扎带或卡扣半固定方案，保留可演示载物能力 |
| R5 | 电机动力不足 | 电机扭矩不足、电池电流不够、轮胎打滑 | 中到高 | 中 | 选型时预留余量；提前做负载测试；检查供电和轮胎附着 | 降低车速、减轻载重、缩小演示范围，必要时更换更高扭矩底盘 |
| R6 | 预算超支 | 传感器、结构件、底盘方案不断叠加，重复采购 | 中 | 中 | 将核心平台预期成本控制在 3000 元内；优先复用现有设备；采购前先统一 BOM | 砍掉选做功能，如高级避障、额外传感器或复杂结构件 |
| R7 | 三人工作量分配不均或关键任务堆积 | 分工不清、采购等待、联调依赖过强 | 中 | 中 | 以机械 / 电控 / 上位机三条线并行推进；每周复盘并调整优先级 | 暂时收缩任务边界，优先保住 OpenBot 基础链路、自主跟随和安全停车 |
| R8 | 现场演示失败 | 临场环境变化、设备掉线、参数漂移、流程不熟 | 高 | 中 | 提前固化演示脚本；准备预演视频、备份电池、备用线材和保守参数 | 若完整演示失败，切换为分段演示：手动遥控、单人跟随、安全停车分别展示 |

---

# 17. 今日讨论结论

## 17.1 已确定事项

1. 首版定位为基于 OpenBot 的缩比原型验证，不承诺真实商用购物车级载重。
2. 首版载物目标按“购物筐 + 1-3 kg 物品”进行稳定演示和测试，更高载重只作为后续实测扩展。
3. 结构方案优先采用模块化购物筐，当前实现思路为“机械限位 + 磁吸辅助固定 + 快拆 + 防滑缓冲”。
4. 磁吸只作为辅助固定和拆装便利手段，主要抗位移能力由机械限位、快拆件、螺丝 / 扎带 / 卡扣等结构件承担。
5. OpenBot Android 开发从 `dev/OpenBot/android` 开始，OpenBot 代码改动先提交到 `dev/OpenBot` 子仓库，再回到主仓库提交 submodule 指针。
6. 目标初始化采用“两阶段确认”策略：先采集候选目标并由用户在手机端确认，再要求用户回到车前完成重识别与倒计时启动，系统不得在未确认前直接起步。

---

## 17.2 待确认事项

| 事项 | 需要谁确认 | 截止时间 | 备注 |
| -- | ----- | ---- | -- |
| 305 系列底盘在 1-3 kg 负载下的实际稳定性 | 成员 B / C | 采购后首轮装配测试 | 需要验证电机动力、重心、制动和转弯稳定性 |
| 磁铁规格、限位件尺寸和快拆件形式 | 成员 C | 结构件采购前 | 需结合底盘孔位、购物筐尺寸和拆装便利性确认 |
| 目标确认阶段的提示方式与 UI 细节 | 成员 A / C | 上位机交互原型确定前 | 需确定以提示音、语音、目标框颜色还是倒计时界面为主，以及是否支持多候选选择 |
| ReID / track / bbox gate 策略实机复测 | 成员 A / C | 最新 APK 安装后 | Android TFLite ReID、upright crop、TargetTrackManager、IdentityBeliefAccumulator、locked ghost、suspected dwell、relock 与空间支持门控已进入代码；下一步用 Human Cart Simulator 诊断日志验证目标返回、遮挡恢复和干扰者抑制。 |

---

## 17.3 下一步行动项

| 行动项 | 负责人 | 截止时间 | 交付物 |
| --- | --- | ---- | --- |
| 完成 OpenBot Android 工程最小构建验证 | 成员 A | 第 1 周 | Gradle Sync / App 安装记录 |
| 完成上位机目标初始化、ReID 增强目标记忆、Person Crop Collector 与 Human Cart Simulator 设计文档 | 成员 A | 第 1 周 | 上位机软件开发计划、状态机草案、真实 crop 采集与仿真模式说明 |
| 确认底盘、ESP32 / 驱动板、电源和急停采购方案 | 成员 B | 第 1 周 | 采购清单与到货计划 |
| 细化模块化购物筐结构草图和固定件清单 | 成员 C | 第 1 周 | 结构草图、限位 / 磁吸 / 快拆件清单 |
| 建立负载、快拆复测和安全停车测试记录表 | 成员 C 主，A / B 配合 | 第 2 周 | 测试记录模板 |

# 18. 附录：备忘与资料链接

## 18.1 参考资料

| 资料名称 | 链接 / 来源 | 用途 | 备注 |
| --- | --- | -- | -- |
| OpenBot 官网 | | | |
| OpenBot GitHub | | | |
| OpenBot 论文 | | | |
| 课程手册 | | | |
| 项目 PPT | | | |
| 竞品资料 | | | |

---

## 18.2 临时想法记录

*
*
*
*

---

## 18.3 老师 / 助教待提问问题

1.
2.
3.
4.
5.

---

# 19. 2026-07-09 当前实现状态补充

本节用于同步最新工程进展，避免前文初步设计阶段的“待接入 / 待确认”表述被误读为当前状态。

## 19.1 上位机当前状态

- Human Cart Simulator 已成为上位机策略验证主入口；真实底盘前进仍未接通，`ControlGenerator` 当前仍用于 simulator 提示和后续底盘控制路径准备。
- Android 端 TFLite ReID 已跑通，当前模型路线保持 `osnet_x0_25_market1501.tflite + upright crop + confirmedGallery`，ReID 作为身份线索，不作为单独 FOLLOW 判决器。
- 阶段 C 已实现目标轨迹和身份信念层，并继续补入 track/bbox gate 修正：locked track ghost memory、suspected track dwell/hysteresis、loose admission gate、default/strict motion gate、恢复后 relock、非 locked track 空间支持门控。
- Human Cart Simulator 已支持 `cartfollow_diagnostics`，并新增“记录日志”开关；默认关闭时不创建诊断目录、不写 CSV/JSON/crop/gallery/event，只有需要复盘时才打开。

## 19.2 下一步测试口径

下一步不是更换 ReID 模型、启用 dynamic gallery 或直接接真实底盘，而是安装最新 APK 后复测四类场景：

1. 目标离开后原目标返回。
2. 目标蹲下、弯腰、短遮挡或局部可见后恢复。
3. 目标离开后干扰者进入。
4. 目标在场时干扰者穿越或靠近。

测试时只在需要导出数据时打开“记录日志”。导出后用 `tools/reid_pc_test/analyze_cartfollow_diagnostics_v1.py --compare-roots old=...,new=...` 对比 `recovered_rate`、`mean_ms_to_follow`、`candidate_switch_penalty`、`belief_high_bbox_failed`、非目标转绿行数和 `hard_stop_count`。只有这些指标不恶化并且两个 blocker 明显下降后，才考虑进入极低速真实底盘联调。

## 19.3 2026-09-04 传感器链路状态

- ESP32 正式 BLE 固件已接入左右 VL53L1X 与中央 URM09-I²C，并实施方向相关的本地停车。
- Android 使用兼容 OpenBot 的 V1 `s` 扩展接收三路有效最小距离；V1 无法区分读数来源。
  实车发现最小值不足以支持方向级判断后，Android 已改为仅显示和记录测距，不再据此改变手动、
  自动跟随或定向搜索命令。ESP32 固件门控尚未同步关闭，仍可能拒绝运动。
- V2 `m/d/g/a` 仍为草案，当前不支持侧移。后退没有后侧传感器覆盖。
- 固件 `c21` 已扩展到约 600 mm/s；自动页面保留该默认上限，但高速跟随必须逐档完成悬空和
  空旷落地验证，不能视为当前课程原型已经安全通过的工作速度。
