ISIP-CART/AutoFollowShoppingCart/design/采购.md

# 采购记录

> 按课程要求记录采购人姓名及学号、采购日期、采购链接、数量、价格，并保留采购列表更新记录。

## 采购清单

| 序号 | 类别 | 采购项 | 规格/型号 | 采购链接 | 数量 | 价格（元） | 采购人姓名及学号  | 采购日期 |
| ---- | --- | --- | --- | --- | ---: | ---: | --- | --- |
| 1 | 底盘 | 四驱差速智能小车底盘 | 大号铝合金麦轮底盘（双层，305 系列），12V 320rpm 编码器电机 | https://item.taobao.com/item.htm?id=804493296943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  | 1 | 405.90 | 王丁丁 2025310486 | 20260701 |
| 2 | 开发板 | ESP32 开发板套件 | 拓展板 | https://item.taobao.com/item.htm?id=672885629326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 | 2 | 15.20 | 王丁丁 2025310486 | 20260701 |
| 3 | 开发板 | ESP32 开发板套件 | TYPEC-USB-32E 主板 + 已焊排针 | https://item.taobao.com/item.htm?id=672885629326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 | 2 | 21.33 | 王丁丁 2025310486 | 20260701 |
| 4 | 电池 | 锂电池组 | 12V 锂电池组 9600mAh | https://detail.tmall.com/item.htm?id=675985006603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 | 1 | 189.00 | 王丁丁 2025310486 | 20260701 |
| 5 | 电池 | 锂电池充电器 | 12V 锂电池充电器（2A） | https://detail.tmall.com/item.htm?id=675985006603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  | 1 | 35.00 | 王丁丁 2025310486 | 20260701 |
| 6 | 驱动板 | 编码器电机驱动模块 | 四路编码器电机驱动模块 + 铜柱 + 数据线 + 电源线 | https://detail.tmall.com/item.htm?id=895192929302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  | 1 | 58.00 | 王丁丁 2025310486 | 20260701 |
| 7 | 杜邦线 | 部件连接用品 | 21cm母对母杜邦线一排40根 | https://detail.tmall.com/item.htm?id=14466195609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 | 1 | 2.35 | 蔡宜轩 2024013287 | 20260706 |
| 8 | 手机支架 | 小车与手机连接模块 | 手机直播支架 加厚大力夹+30cm软管+手机夹 | https://detail.tmall.com/item.htm?id=1030199333857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 | 1 | 13.90 | 蔡宜轩 2024013287 | 20260708 |
| 9 | 连接轴 | 电机与车轮连接模块 | 麦克纳姆轮夹紧式联轴器 6mm | https://item.taobao.com/item.htm?id=1040186559237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 | 4 | 48.00 | 蔡宜轩 2024013287 | 20260709 |
| 10 | 铜柱 | 小车双层板连接模块 | 铜单通六角固定柱 M3×60+6 (10个/包) | https://item.jd.com/100260800118.html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 | 1 | 14.05 | 蔡宜轩 2024013287 | 20260709 |
| 11 | 螺丝 | 零部件连接用品 | 十字薄头螺丝 M3×8×5 (500个/包) | https://item.jd.com/100234999133.html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 | 1 | 27.92 | 蔡宜轩 2024013287 | 20260709 |
| 12 | 传感器 | 超声波测距传感器 | DFROBOT URM09-I²C超声波测距传感器 | https://item.taobao.com/item.htm?id=588327733308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 | 1 | 95.00 | 蔡宜轩 2024013287 | 20260710 |
| 13 | 传感器 | 激光红外测距传感器 | VL53L1X 激光红外测距传感器模块 TOF 飞行时间测距 4 米测距 黑板（已焊排针）+透镜盖片 | https://item.taobao.com/item.htm?id=597981154375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 | 3 | 60.30 | 蔡宜轩 2024013287 | 20260830 |
| 14 | 铝型材 | 欧标2020铝型材 | 20 欧标银白-长度 25CM-厘米  | https://item.taobao.com/item.htm?id=714081213864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| 2 | 12.00 | 蔡宜轩 2024013287 | 20260831 |
| 15 | 铝型材 | 欧标2020铝型材 | 20 欧标银白-长度 20CM-厘米  |https://item.taobao.com/item.htm?id=714081213864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| 2 | 11.20 | 蔡宜轩 2024013287 | 20260831 |
| 16 | 铝型材 | 铝型材封盖盖板 | 20欧标-灰白  |https://item.taobao.com/item.htm?id=715275782147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| 8 | 4.60 | 蔡宜轩 2024013287 | 20260831 |
| 17 | 胶水 | 硅胶胶水 | 硅胶胶水50g |https://detail.tmall.com/item.htm?id=694346178287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| 1| 7.92| 蔡宜轩 2024013287 | 20260901 |
| 18 | 手柄 | 五星梅花手柄 | M5×12 镀锌 |https://item.taobao.com/item.htm?id=1054463646897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| 10| 5.30| 蔡宜轩 2024013287 | 20260901 |
| 19 | 手柄 | 五星梅花手柄 | M5×14 镀锌 |https://item.taobao.com/item.htm?id=1054463646897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| 6| 3.24| 蔡宜轩 2024013287 | 20260901 |
| 20 | 手柄 | 五星梅花手柄 | M5×16 镀锌 |https://item.taobao.com/item.htm?id=1054463646897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| 6| 3.24| 蔡宜轩 2024013287 | 20260901 |
| 21 | 防脱挡块 | 铝型材间隔连接块 | 2020欧标偏心间隔块 含螺母螺丝|https://item.taobao.com/item.htm?id=978817797965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| 10| 3.50| 蔡宜轩 2024013287 | 20260901 |
| 22 | 一字连接片 |  一字连接片件(带长圆孔) | N91*19 小号平片单槽镀锌|https://item.taobao.com/item.htm?id=933874450818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| 4| 6.20| 蔡宜轩 2024013287 | 20260901 |
| 23 | 一字连接片 |  一字连接片件(带长圆孔) | N91*19 小号平片单槽黑色|https://item.taobao.com/item.htm?id=933874450818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| 4| 7.20| 蔡宜轩 2024013287 | 20260901 |
| 24 | 垫片 |  304 不锈钢加大平垫螺丝金属介子垫圈加厚垫片 |M3*8*0.8(100个)|https://detail.tmall.com/item.htm?id=601878075662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| 1| 3.24| 蔡宜轩 2024013287 | 20260901 |
| 25 | 防松螺丝 |  防松螺丝 304 不锈钢外六角组合螺母套装锁紧 |M3*14(20套)|https://detail.tmall.com/item.htm?id=683529989917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| 1| 1.47| 蔡宜轩 2024013287 | 20260901 |
| 26 | 购物篮 |  有孔加厚型塑料篮子方形滤水胶筛置物周转物流放货分类小篮筐|绿色1号|https://item.taobao.com/item.htm?id=718372722295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| 2| 5.70| 蔡宜轩 2024013287 | 20260902 |
| 27 | 购物篮 |  有孔加厚型塑料篮子方形滤水胶筛置物周转物流放货分类小篮筐|蓝色2号|https://item.taobao.com/item.htm?id=718372722295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| 2| 6.49| 蔡宜轩 2024013287 | 20260902 |

## 填写说明

- `采购人姓名及学号`：按实际下单同学填写，例如“张三 2023123456”。
- `采购日期`：统一使用 `YYYY-MM-DD` 格式。
- `价格（元）`：实际支付金额。
- `数量`：按实际下单件数填写，如后续补购请直接新增一行，不建议覆盖原记录。
