ISIP-CART/AutoFollowShoppingCart/design/img/CAR.png

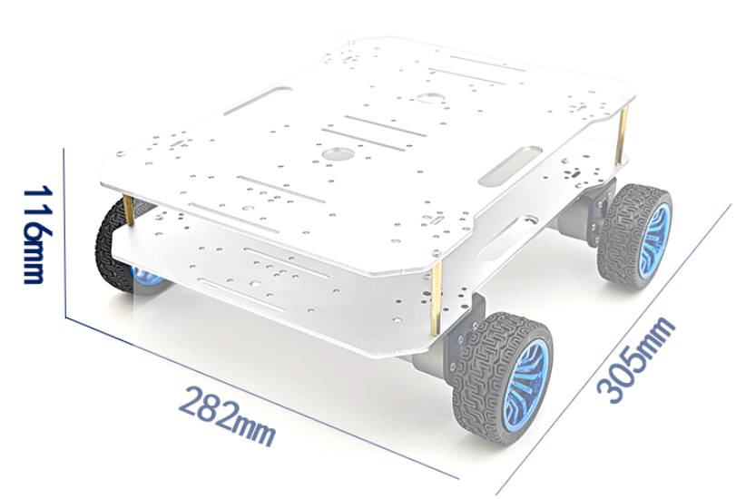
design/img/CAR.png
