ISIP-CART/AutoFollowShoppingCart/design/img/ESP32.png

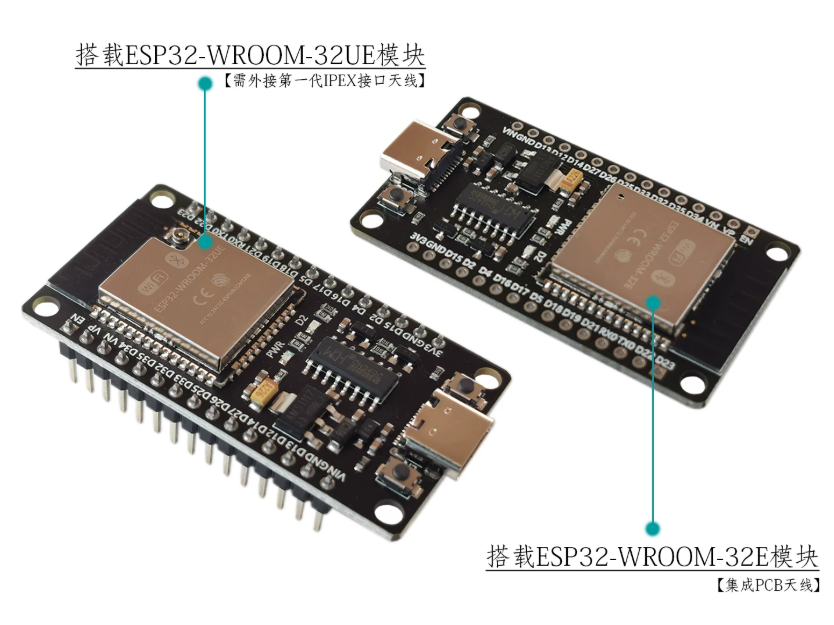
design/img/ESP32.png
