ISIP-CART/AutoFollowShoppingCart/design/img/现有产品.png

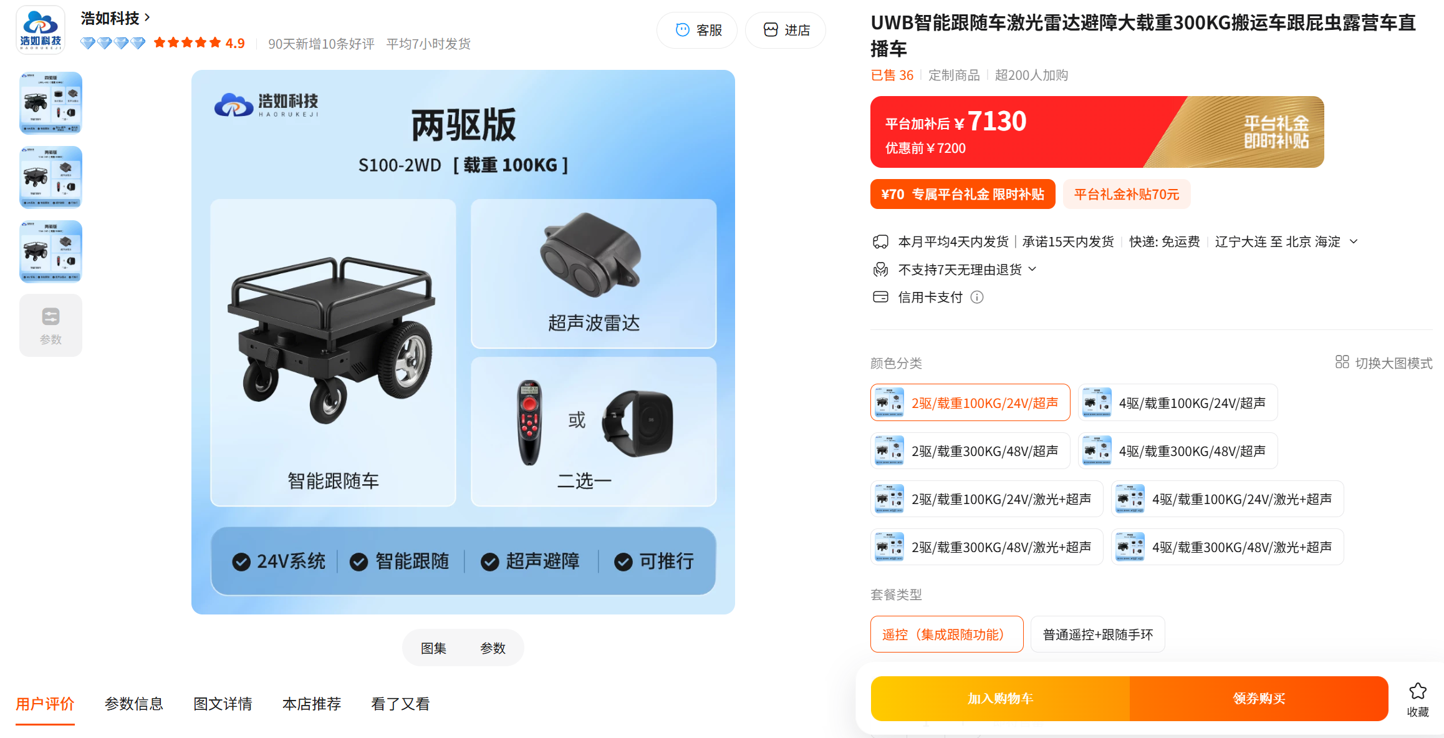
design/img/现有产品.png
