ISIP-CART/AutoFollowShoppingCart/design/img/真实情景示意图.png

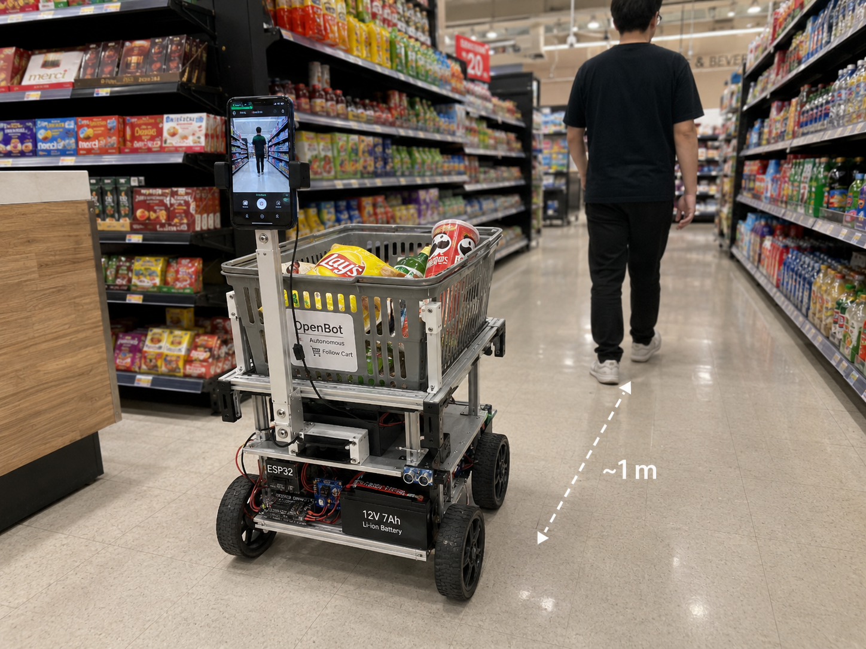
design/img/真实情景示意图.png
