ISIP-CART/AutoFollowShoppingCart/design/img/自主跟随购物车系统示意图.png

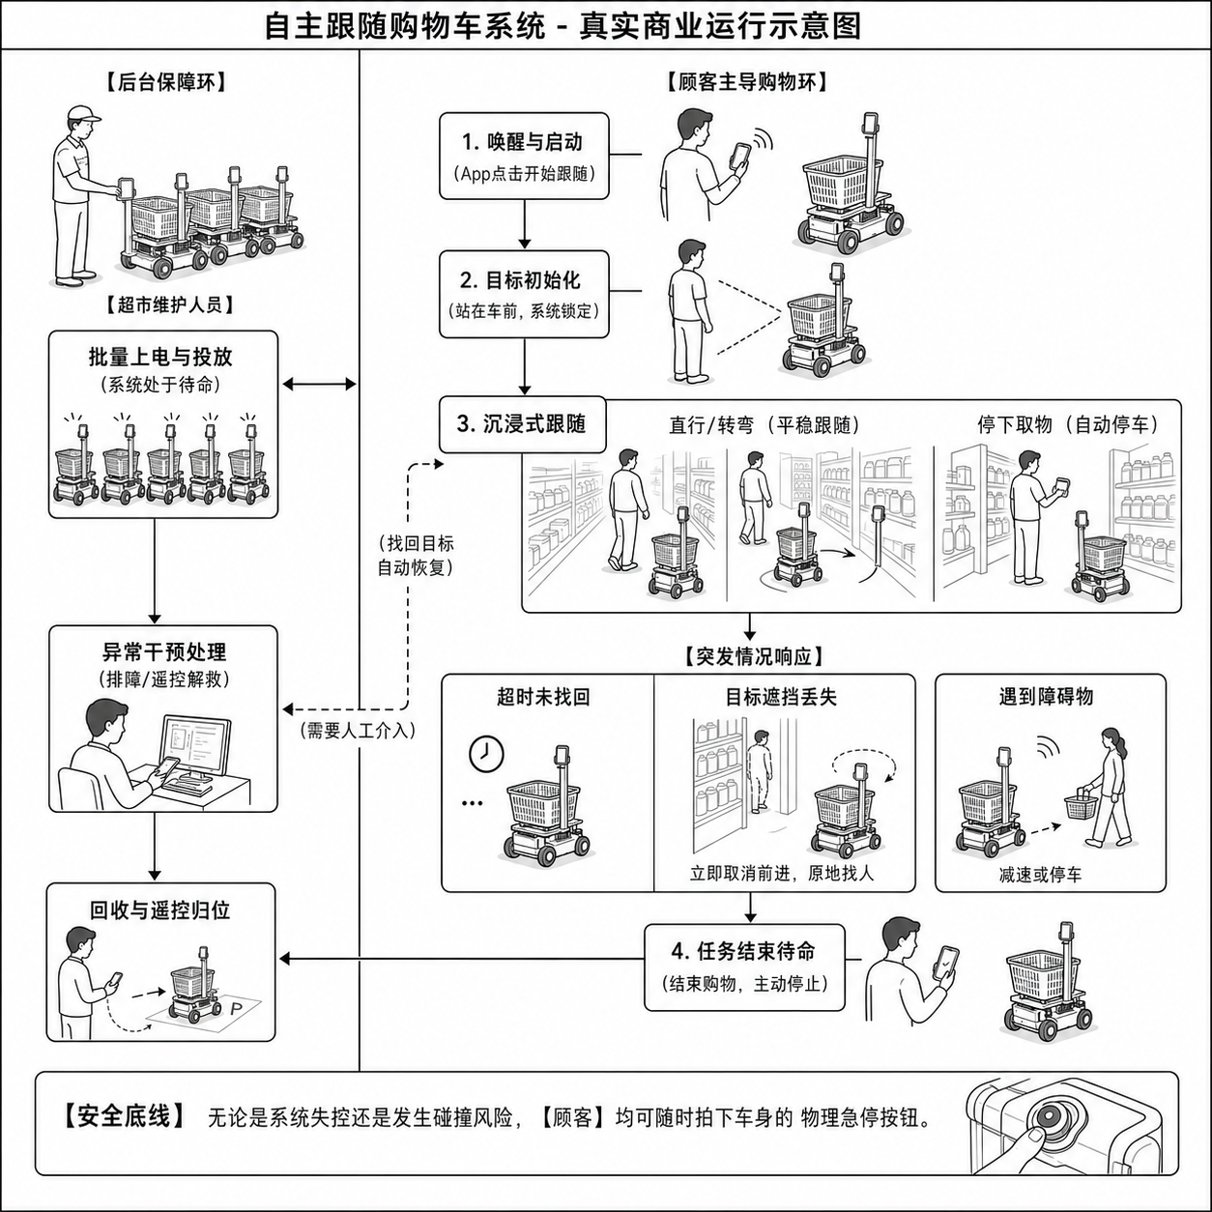
design/img/自主跟随购物车系统示意图.png
