ISIP-CART/AutoFollowShoppingCart/design/WBS/WBS.png

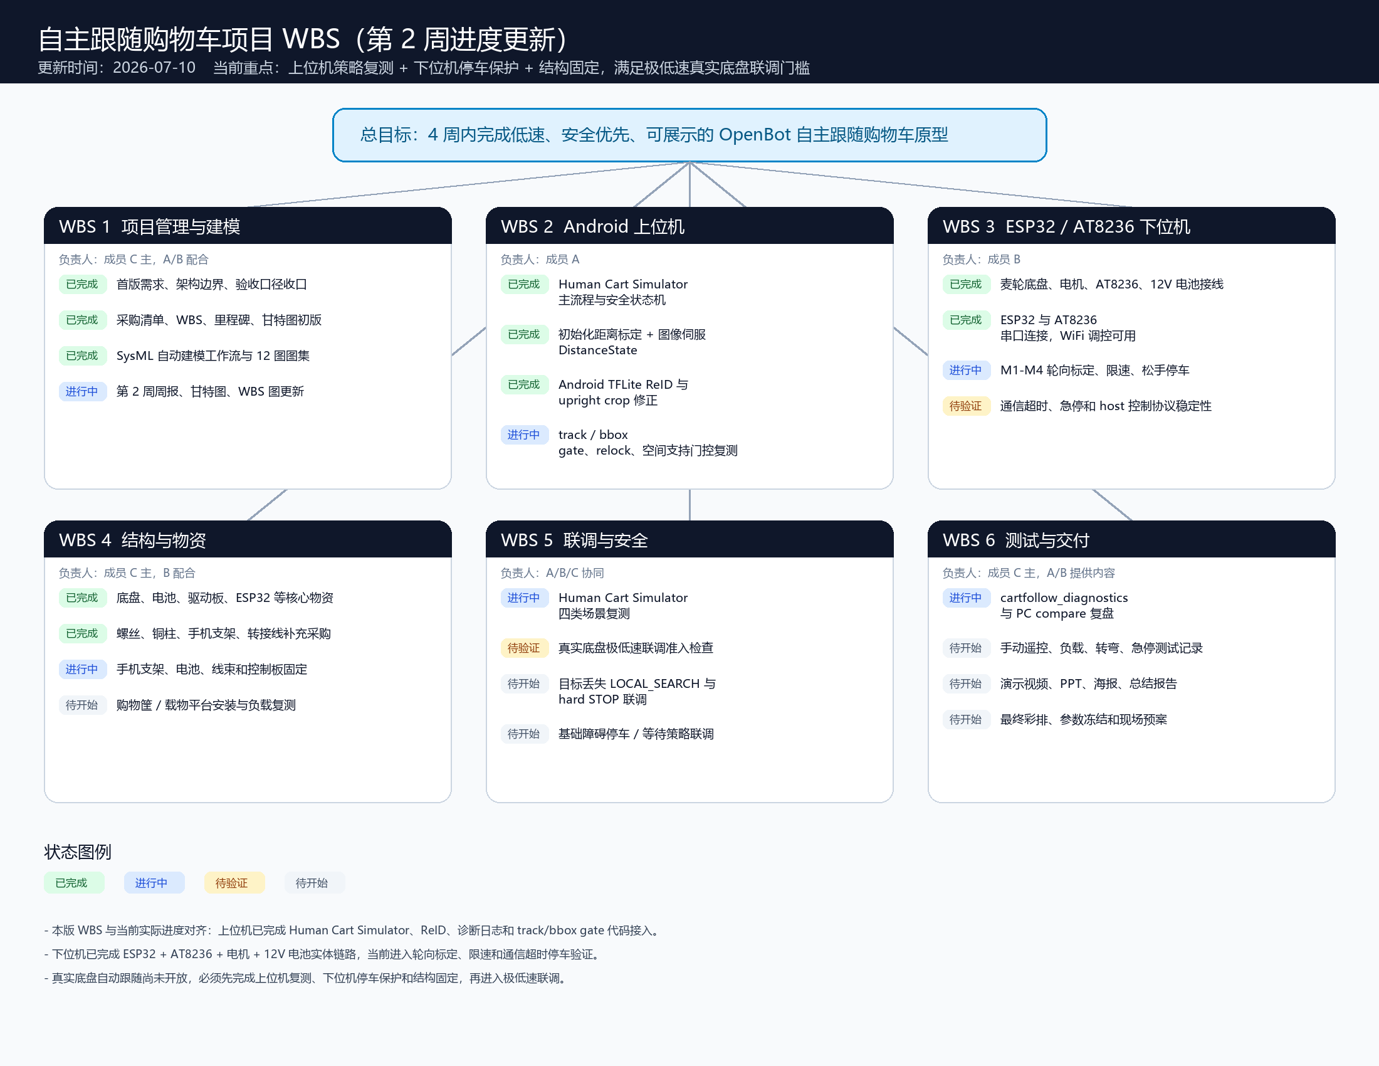
design/WBS/WBS.png
