ISIP-CART/AutoFollowShoppingCart/design/background/06-shopping-scenario-and-requirements.md

# 06 购物跟随场景分析与需求转化

## 1. 调研目的

本文用于回答以下问题：

1. 室内超市/模拟超市场地的物理环境特征是什么，对移动机器人系统有何约束。
2. 购物者在超市中的典型行为模式如何转化为跟随系统的功能需求和测试用例。
3. 人机共处场景的安全边界如何划定，需要哪些强制安全措施。
4. 首版演示的限定条件是什么，哪些场景复杂性应在首版排除。
5. 从场景分析到功能需求、性能指标和测试计划的完整映射关系。

本文直接服务于所有成员（A/B/C）的共同设计决策和演示脚本编写。

## 2. 目标场地物理环境分析

### 2.1 真实超市环境特征

| 环境要素 | 典型参数 | 对跟随系统的影响 |
| --- | --- | --- |
| 地面 | 瓷砖/水磨石/环氧地坪，偶有地缝、轻微坡度 | 差速底盘适应性好；需注意瓷砖缝导致的振动影响超声波传感器 |
| 主通道宽度 | 2.0-3.5 m | 足够小车转弯和避让 |
| 货架间通道 | 1.2-2.0 m | 较窄，小车 + 购物筐需要足够机动性 |
| 货架高度 | 1.5-2.2 m | 遮挡摄像头视野，目标可能突然消失在货架后 |
| 转角 | 90° 货架端部转弯 | 目标可能在转角处暂时丢失 |
| 照明 | 荧光灯/LED 阵列，500-1000 lux，部分区域可能有阴影 | 光照变化影响视觉检测稳定性 |
| 地面反光 | 抛光瓷砖可能产生镜面反射 | 可能干扰视觉模型 |
| 临时障碍物 | 堆头陈列、促销展架、补货车、纸箱 | 不可预测的静态和半静态障碍 |
| 背景复杂度 | 货架商品纹理、广告牌、价格标签 | 视觉杂波，可能增加误检 |
| 天花板高度 | 3.0-5.0 m | 不影响地面级操作 |

### 2.2 首版演示场地约束

本项目首版面向的是**课程实验场地或模拟超市环境**，而非真实运营超市。因此演示场地应具备以下条件：

| 约束项 | 建议条件 |
| --- | --- |
| 室内/室外 | 必须室内，避免室外光照和天气干扰 |
| 地面 | 平坦硬质地面（教室/走廊/实验室地板），无障碍物残余 |
| 面积 | 至少 5 m × 10 m 的操作空间，包含至少一条直道和一个转角 |
| 光照 | 室内正常照明（≥300 lux），避免强逆光和频繁闪烁 |
| 障碍物 | 可人工布置：纸箱、椅子、泡沫块，用于障碍停车测试 |
| 货架模拟 | 可用桌椅、展板或简易货架替代，形成通道和转角 |
| 行人模拟 | 首版由团队成员扮演目标用户和干扰行人 |
| 背景控制 | 首版优先简单背景（白墙/素色展板），降低误检 |

### 2.3 场地对运动能力的要求

| 能力要求 | 参数 | 来源 |
| --- | --- | --- |
| 最小通道通过宽度 | 需能通过 1.2 m 宽通道（小车 + 筐宽度 < 0.8 m） | 模拟货架通道 |
| 转弯能力 | 需能完成 90° 转角，转弯半径 ≤ 1.0 m | 演示路线设计 |
| 原地转向 | 差速底盘可原地旋转（用于 LOST/SEARCH） | 安全搜索策略 |
| 地面坡度 | ≤ 3°（平坦室内地面） | 避免溜坡导致安全问题 |
| 地面缝隙 | ≤ 15 mm（标准瓷砖缝） | 避免小轮卡住 |

## 3. 目标用户行为分析

### 3.1 购物者典型行为模式

| 行为 | 描述 | 速度 | 持续时间 | 跟随系统响应 |
| --- | --- | --- | --- | --- |
| 直线行走 | 沿通道匀速前进 | 0.8-1.2 m/s（正常步行） | 数秒至数十秒 | 小车以 0.3-0.8 m/s 保持 1.0-2.0 m 距离跟随 |
| 减缓浏览 | 边看货架边慢走 | 0.3-0.5 m/s | 不定 | 小车同步减速，保持安全距离 |
| 停下取物 | 停在货架前取出商品 | 0 | 3-10 s | 小车减速至停止，保持约 1 m 距离等待 |
| 转身 | 改变行走方向 | - | 1-2 s | 小车通过差速转向跟进；转身过快可能导致目标暂时丢失 |
| 经过转角 | 进入垂直通道 | 正常步行 | 数秒 | 目标可能在转角处短暂离开视野；SORT 跟踪可桥接 1-3 帧 |
| 突然变速 | 临时加速或急停 | 变化 | 瞬间 | 限制小车最大加速度，避免急冲 |
| 蹲下 | 取底层商品 | - | 3-5 s | 人体形态变化大，检测置信度可能下降 |

### 3.2 多人场景

| 场景 | 描述 | 系统应对 |
| --- | --- | --- |
| 单目标 + 无干扰 | 理想场景，画面中仅目标一人 | 直接跟踪 |
| 单目标 + 他人穿行 | 非目标行人从目标和小车之间穿过 | SORT track_id 锁定目标，不跟随穿行者 |
| 单目标 + 他人同向行走 | 通道中有其他人与目标同方向行进 | 可能跟踪到错误的人（首版主要风险） |
| 多人聚集 | 多人围在货架前 | 难以分辨目标，可能跟踪失败 |

**首版立场**：首版演示场景控制在单目标 + 无干扰或仅偶尔穿行。多人密集场景不作为首版验收要求。

### 3.3 用户与小车交互

| 交互 | 触发方式 | 系统响应 |
| --- | --- | --- |
| 启动跟随 | 用户通过 App 或语音/手势指令 | 系统进入 FOLLOW，开始人物检测和跟踪 |
| 暂停/继续 | App 按钮 | 切换 FOLLOW ↔ STOP |
| 急停 | 用户按下急停按钮（物理） | 小车立即停车，ESP32 切断电机输出 |
| 结束使用 | App 停止按钮 | 小车停车，进入待命状态 |

## 4. 安全场景分析

### 4.1 安全威胁模型

| 威胁 | 严重程度 | 发生可能性 | 首版必须防护 |
| --- | --- | --- | --- |
| 小车撞人 | 高 | 中 | **是**：限速 + 急停 + 障碍停车 |
| 小车撞货架/障碍物 | 中 | 中 | **是**：超声波障碍检测 + 视觉辅助 |
| 目标丢失后小车继续前进 | 高 | 高 | **是**：目标丢失取消前进 + 搜索超时停车 |
| 通信中断后小车失控 | 高 | 中 | **是**：ESP32 心跳超时自动停车 |
| 程序崩溃 | 中 | 中 | **是**：ESP32 通信超时保护独立于手机程序 |
| 电池耗尽导致突然停/溜坡 | 中 | 低 | 应：电池电压监测，低于阈值时提前报警 |
| 购物筐脱落伤人或损坏 | 中 | 低 | **是**：机械限位 + 磁吸辅助固定，负载测试验证 |
| 小车轮碾到脚 | 低 | 低 | 应：低速运行已大幅降低风险 |

### 4.2 逐层安全防护设计

| 层级 | 防护措施 | 响应时间 | 实施位置 |
| --- | --- | --- | --- |
| 第 1 层：速度限制 | 软件限速 V_MAX ≤ 0.8 m/s，Slow 模式 ≤ 0.4 m/s | 实时 | Android App |
| 第 2 层：视觉安全 | 目标丢失 → 取消前进；超声波障碍 → 减速/停车 | 50-200 ms | Android App 决策模块 |
| 第 3 层：通信保护 | ESP32 若 1000 ms 内未收到指令 → 自动停车 | ≤1000 ms | ESP32 固件 |
| 第 4 层：物理急停 | 急停按钮触发 ESP32 外部中断 → 立即切断电机 PWM | <10 ms | 硬件电路 + ESP32 中断 |
| 第 5 层：机械结构安全 | 购物筐机械限位防止脱落；车轮护罩防止卷入 | - | 机械结构 |
| 第 6 层：操作流程 | 上电自检 → 手动模式验证 → 才能进入跟随 | - | 操作规范 |

### 4.3 各异常状态的安全行为

| 异常 | 进入条件 | 小车行为 | 恢复条件 |
| --- | --- | --- | --- |
| 目标丢失 (LOST) | 连续 5-10 帧未检测到锁定目标 | 立即 v=0，启动搜索计时 | 自动进入 SEARCH |
| 搜索 (SEARCH) | LOST 后自动进入 | v=0，发送低速原地旋转指令（交替左右） | 重新检测到目标 或 超时 |
| 超时停车 (STOP) | 搜索超过 5 s | 发送 c0,0，进入 STOP | 用户重新初始化 |
| 障碍停车 (OBSTACLE) | 超声波距离 ≤ 30 cm | 减速或立即停车 | 障碍移除 + 用户确认 |
| 急停 (EMERGENCY) | 急停按钮按下 | 立即停车，ESP32 切断输出 | 急停按钮复位 + 系统重启 |
| 通信超时 (STOP) | ESP32 未收到有效指令超过 1000 ms | 立即停车 | 通信恢复 + 用户操作 |

## 5. 演示场景设计

### 5.1 演示场地布局建议

```
             货架模拟区
    ┌─────┐        ┌─────┐
    │货架A│        │货架B│
    │     │        │     │
    └─────┘        └─────┘
    ←── 通道 1 (宽 2 m) ──→
    
    ┌─────┐              ← 转角区
    │货架C│
    │     │
    └─────┘
    ↑
    通道 2 (宽 2 m)
    ↓
    
    ┌─────┐  障碍物区  ┌─────┐
    │货架D│  [箱子]    │货架E│
    └─────┘            └─────┘
    
    起点 ←─ 用户初始化区 ─→ 终点
```

### 5.2 演示脚本（完整版）

| 序号 | 环节 | 动作 | 预计时长 | 成功标准 | 关键数据记录 |
| --- | --- | --- | --- | --- | --- |
| 1 | 系统启动 | 小车通电，手机打开 App，USB 连接确认 | 30 s | App 显示连接正常，电池/传感器读数正常 | 启动耗时，连接状态 |
| 2 | 手动遥控自检 | 前进 2 m → 后退 1 m → 左转 90° → 右转 90° → 停止 | 30 s | 指令方向正确，停止可靠 | 响应延迟 |
| 3 | 目标初始化 | 用户站在小车前方 1.5 m，系统锁定 | 3-5 s | 目标框稳定显示，进入 FOLLOW | 锁定耗时 |
| 4 | 直线跟随 | 用户沿通道 1 直线行走约 10 m | 15 s | 小车连续跟随，不蛇形摆动 | 跟随轨迹偏差，速度曲线 |
| 5 | 用户停下取物 | 用户在某货架前停下 5 s | 5 s | 小车减速并在 1-2 m 距离内停车等待 | 停车距离 |
| 6 | 恢复跟随 | 用户重新开始行走 | 10 s | 小车恢复跟随 | - |
| 7 | 转弯跟随 | 用户在货架端部 90° 转弯进入通道 2 | 10 s | 小车完成转弯，不脱离目标 | 转弯轨迹 |
| 8 | 目标丢失 + 搜索 + 停车 | 用户快速走到遮挡物后方 | 10 s | 小车取消前进，原地低速扫描，超时后停车 | 搜索行为视频记录 |
| 9 | 重新初始化 + 恢复 | 用户回到初始化位置，重新锁定 | 5 s | 系统重新锁定并进入 FOLLOW | 重新初始化耗时 |
| 10 | 障碍停车 | 在跟随路径上人工放置纸箱 | 10 s | 小车检测到障碍后减速或停车，不接触纸箱 | 停车距离 |
| 11 | 急停 | 跟随过程中按下急停按钮 | 2 s | 小车立即停车 | 急停响应时间 |
| 12 | 负载演示 | 购物筐中放入 1-3 kg 模拟物品（水瓶/书本），重复 4-6 | 60 s | 无松动、无明显不稳 | 负载表现 |

**总演示时间**：约 5-7 分钟。

### 5.3 分段演示脚本（降级方案）

如果完整演示无法一次完成，可切换为分段演示：

| 分段 | 内容 | 分钟 |
| --- | --- | --- |
| 分段 A | 手动遥控 + 直线跟随 + 停下 | 2-3 |
| 分段 B | 转弯跟随 + 目标丢失处理 | 2-3 |
| 分段 C | 障碍停车 + 急停 + 负载演示 | 2-3 |

### 5.4 演示前检查清单

| 检查项 | 负责 | 确认标准 |
| --- | --- | --- |
| 电池电量 | B | 电机电池 ≥ 80%，手机电量 ≥ 50% |
| 串口通信 | B / A | 发送 c0,0 收到回声/确认 |
| 急停按钮 | B / C | 按下后电机立即停止，松手后不恢复 |
| 超声波读数 | B / C | 手放在传感器前读数变化正常 |
| 摄像头画面 | A | App 画面预览清晰，无严重过曝/欠曝 |
| 模型加载 | A | 状态栏显示模型名称，推理帧率正常 |
| 场地清理 | C | 地面无障碍碎片，标记线清晰 |
| 备件 | C | 备用电池、OTG 线、螺丝刀、扎带 |
| 录像设备 | C | 三脚架/手机录像就位 |

## 6. 场景约束转化为需求

### 6.1 场景特性 → 功能需求 映射

| 场景特性 | 需求编号 | 需求内容 |
| --- | --- | --- |
| 用户直线行走 | FR-03 | 自主跟随：依据目标位置输出速度/转向，低速跟随 |
| 用户转弯 | FR-03 | 转弯跟随：转弯时保持锁定不偏离 |
| 用户停下取物 | FR-03（隐含） | 目标静止时小车同步停在一段距离外 |
| 目标被货架遮挡 | FR-05 | 目标丢失→取消前进→短时搜索→超时停车 |
| 通道中有障碍物 | FR-06 | 前方障碍时减速或停车 |
| 用户需要紧急停止 | FR-01 隐含 | 急停按钮/App 停止，ESP32 切断电机 |

### 6.2 场景特性 → 性能指标 映射

| 场景特性 | 指标编号 | 指标内容 |
| --- | --- | --- |
| 直线走动跟随 | 跟随速度 | 0.3-0.8 m/s |
| 跟随距离 | 跟随距离 | 1.0-2.0 m |
| 路径长度 | 连续跟随距离 | ≥ 30 m |
| 目标隐藏后停车 | 目标丢失停车时间 | 搜索超时后 1 s 内完成 |
| 紧急制动 | 急停响应时间 | ≤ 0.5 s |
| 装载商品 | 负载能力 | 购物筐 + 1-3 kg |
| 避障停车 | 障碍停车距离 | 距障碍物 ≥ 0.3 m |
| 续航 | 单次运行时间 | ≥ 20 min |

### 6.3 场景复杂性 → 首版排除项

| 排除场景 | 原因 | 后续版本可能性 |
| --- | --- | --- |
| 人群中跟随（>3 人同时在画面中） | 多人检测和锁定极度复杂，超出课程范围 | 中期扩展 |
| 穿越人流密集区 | 需要高级避障和路径预测 | 中期扩展 |
| 目标人物换衣/外观大变后继续跟随 | 需要 ReID，手机端负载大 | 长期研究 |
| 多车协同 | 超出首版范围 | 后续 SRT |
| 夜间/低光照环境 | 手机摄像头无夜视能力 | 不做 |
| 上下坡道 | 无坡道测试场地 | 中期扩展 |
| 真实商品自动识别/扫码 | 不在首版范围 | 商业扩展 |
| 自动返航 | 需要全局定位 | 中期扩展 |

## 7. 边界条件与边缘情况

### 7.1 正常操作边界

| 边界 | 最大值 | 建议演示值 |
| --- | --- | --- |
| 目标距离 | 0.5-5 m（视觉检测范围） | 1.0-2.0 m |
| 目标横向偏移 | 摄像头视野的 ±45° | 保持目标在画面中央 60% 内 |
| 目标行走速度 | ≤ 1.0 m/s | 0.5-0.8 m/s |
| 连续运行 | ≥ 20 min | 每段演示 5-7 min |
| 环境光照 | 100-2000 lux | 300-800 lux（室内标准照明） |

### 7.2 降级处理策略

| 情况 | 降级策略 |
| --- | --- |
| 手机推理帧率 < 10 fps | 切换到更轻的模型（MobileNetV1），降低输入分辨率 |
| 超声波读数不稳定 | 开启中值滤波（USE_MEDIAN），增加减震垫 |
| 串口通信不稳定 | 检查 OTG 线缆、更换 USB 端口、降低波特率至 57600 |
| 转弯时检测丢失频繁 | 调低 lost_counter 阈值，增加 SORT max_age |
| 地面不平导致颠簸 | 降低速度，增加结构减震 |
| 电池电量不足 | 提前终止演示，换备用电池 |
| 现场光照变化大 | 调低模型置信度阈值，或切换到更鲁棒的模型 |

## 8. 测试计划（从场景角度组织）

### 8.1 单元测试（逐功能验证）

| 测试ID | 测试项 | 场景条件 | 通过标准 |
| --- | --- | --- | --- |
| UT-01 | USB Serial 通信 | 手机连接 ESP32 | 发送 c128,128 后电机转动 |
| UT-02 | 急停按钮响应 | 电机转动中按下 | 电机立即停止，指令记录仪确认 |
| UT-03 | 通信超时停车 | 电机转动中拔出 USB | 1 s 内电机停止 |
| UT-04 | 超声波读取 | 传感器前 50 cm 放手 | App 显示 ~50 |
| UT-05 | 人物检测 | 单人站在摄像头前 1.5 m | 检测框稳定显示 |
| UT-06 | 目标初始化锁定 | 用户站在指定区域 | 3 s 内锁定并显示状态 |

### 8.2 集成测试（多模块联调）

| 测试ID | 测试项（对应 structure.md） | 新增细节 |
| --- | --- | --- |
| IT-01 | 手动遥控 (T1) | 在演示场地内完成，验证不同地面区域的响应一致性 |
| IT-02 | 通信断开停车 (T2) | 分别在静止、低速前进、原地转向时断开通信 |
| IT-03 | 单人直线跟随 (T3) | 在 10 m 直道重复 3 次，记录横向偏差 |
| IT-04 | 单人转弯跟随 (T4) | 分别在左转和右转 90° 各 3 次 |
| IT-05 | 用户停下后停车 (T5) | 测试停止后恢复跟随的连续性 |
| IT-06 | 目标丢失 + 搜索 + 停车 (T6) | 测试三种丢失方式：躲到货架后、离开房间、被纸板遮挡 |
| IT-07 | 障碍停车 (T7) | 测试纸箱、椅子、人三种障碍 |
| IT-08 | 购物筐负载 (T8) | 空载、1 kg、3 kg 各一套完整路线 |
| IT-09 | 购物筐快拆复测 (T9) | 拆装后重复负载测试 |
| IT-10 | 完整演示 (T10) | 首次按脚本演练，首次不录音录像 |

## 9. 参考资料来源

| 资料 | 获取方式 | 用途 |
| --- | --- | --- |
| 项目 `design/structure.md` | 仓库本地 | 场景描述、需求分析、测试计划、风险分析 |
| 项目 `设计/工程决策与实现策略记录.md` | 仓库本地 | 缩比原型定位、载重收敛、安全策略 |
| 项目 `AGENTS.md` | 仓库本地 | 架构硬约束、目标丢失策略 |
| 项目 `design/background/01-project-context.md` | 仓库本地 | WHO 老龄化与健康资料、ISO 13482 安全标准背景 |
| 项目 `design/background/04-person-detection-and-following.md` | 仓库本地 | 人物检测模型、SORT 跟踪、跟随控制策略 |
| ISO 13482:2014 | https://www.iso.org/standard/53820.html | 个人护理机器人安全标准（已访问确认） |
| OpenBot 文档 | https://github.com/ob-f/OpenBot | 超声波振动敏感性、速度模式、固件配置 |
| 零售空间设计规范（行业通则） | 行业知识 | 通道宽度、照明标准、地面材料等行业典型值 |

## 10. 后续建议

1. 在演示场地确认后，实地测量光照水平和地面平整度，校准视觉检测参数。
2. 制作一份图文并茂的演示脚本（含场地俯视图、行走路线、各环节标注），用于现场彩排。
3. 准备一段 2 分钟的预录演示视频作为现场展示的备份（应对临场设备故障）。
4. 对每个 "目标丢失" 和 "障碍停车" 场景至少预演 5 次，确保可重复性。
5. 记录实际测试中的所有参数值（Kp、V_MAX、SEARCH_TIME 等），形成参数配置表供演示日使用。
