ISIP-CART/AutoFollowShoppingCart/design/gantt/autofollowshoppingcart-day-gantt-preview.png

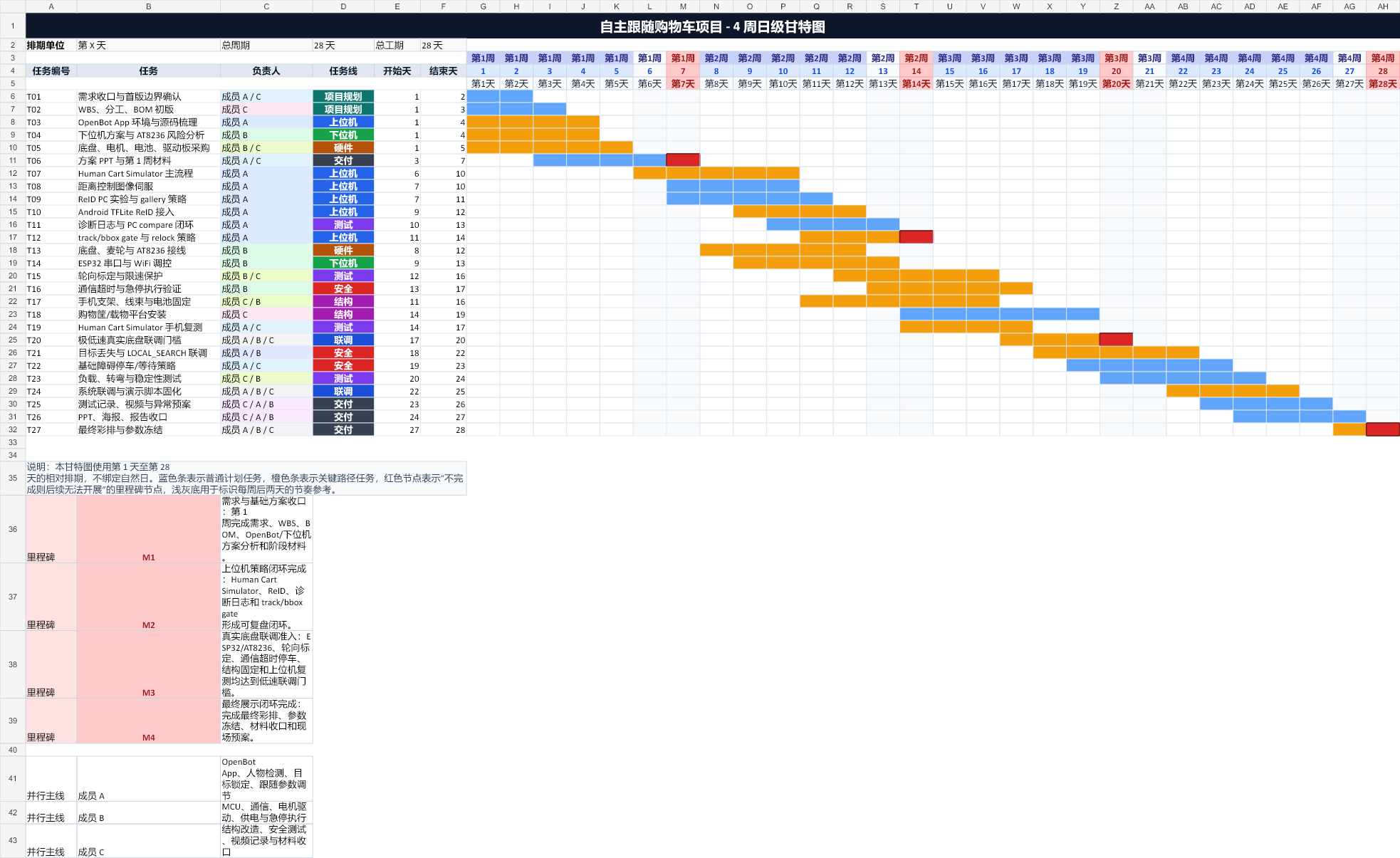
design/gantt/autofollowshoppingcart-day-gantt-preview.png
