ISIP-CART/AutoFollowShoppingCart/design/tests/near-field/URM09测试报告.md

# URM09 超声波测试报告

整理日期：2026-09-03。来源为 2026-09-02 提交的[原始串口日志](data/urm09-serial.txt)，2026-09-03 用户再次确认同一附件。

## 1. 结论

ESP32 已持续输出 URM09 测距结果，基础采集链路已经运行。日志包含连续无效值和少量远距离跳变，尚需固定目标复测和失效保护验证，不能直接作为整车避障验收通过的依据。

共 **411 条记录**，其中 **358 条 VALID、53 条 INVALID**，程序有效率 **87.10%**。没有 `I2C_WRITE_ERROR` 或 `I2C_READ_ERROR` 行；此结论只覆盖已保存的片段，不能替代电源电压、启动识别或长期总线可靠性测量。

## 2. 硬件与参考测试程序

| 项目 | 记录 |
| --- | --- |
| 型号 | DFRobot Gravity URM09，SEN0304，I²C 版 |
| 接线方案 | VCC=3.3 V，GND 共地，D/SDA=GPIO21，C/SCL=GPIO22 |
| 用户确认的实际接口 | 占用 HUA 拓展板一组 I²C 接点，电源跳帽在 3.3 V 侧 |
| 参考地址 | 0x11，7 位地址 |
| 参考总线 / 串口 | I²C 100 kHz / 115200 baud |
| 参考初始化 | 扫描地址、读产品 ID；向 0x07 写 0x00，选择被动测量 |
| 参考采集过程 | 向 0x08 写 0x01，等待 100 ms，从 0x03 起读两个距离字节；高字节在前；每轮末尾再等待 20 ms |
| 程序有效性检查 | 2–500 cm 记为 VALID，范围外记为 INVALID |
| 缺失信息 | 启动输出、实际 ID/版本、固件 hash、Arduino 板包版本、目标真值和材质、安装状态、电机状态 |

以上软件参数为此前提供的台架示例参数，日志周期和格式与其相符，实际烧录版本未单独留档。SEN0304 的接口与供电规格见 [DFRobot 产品说明](https://wiki.dfrobot.com/sen0304)；具体模块版本及寄存器含义复测时应一并记录。

## 3. 字段解释

```text
1734,VALID,34 cm
```

依次为设备毫秒时间、程序分类、厘米距离。无效记录使用 `INVALID,raw=65535`。本次全部 53 条无效记录均为 `65535`（0xFFFF），应按不可用测距处理，不能解释为 655.35 m 远处或“前方无障碍”。

`VALID` 只表示数值通过 2–500 cm 范围检查，不带独立回波质量判定，也不证明与实际距离一致。这个定义与 ToF 的状态码有效性检查不同。

附件缺少 `Found I2C device: 0x11`、`Product ID: 0x01` 和 `URM09 ready` 等启动行，不能把参考程序的预期输出当作本次已记录的识别结果。第一行有不可读前缀，后续格式连续完整；前缀原因无法从该片段确定。

## 4. 统计结果

| 指标 | 结果 |
| --- | ---: |
| 时间戳范围 | 1734–50934 ms |
| 首末记录跨度 | 49.200 s |
| 总记录 | 411 |
| VALID / INVALID | 358 / 53 |
| 有效率 / 无效率 | 87.10% / 12.90% |
| 有效读数最小–最大 | 3–444 cm |
| 采样间隔最小 / 中位 / 最大 | 120 / 120 / 120 ms |
| 采样率 | 8.33 Hz |
| I²C 读 / 写错误行 | 0 / 0 |
| 最长连续无效 | 25 条；首末无效跨度 2880 ms |

3–444 cm 是程序判为有效的观测范围，并非本次标定后的可信工作范围。没有逐段真值，不能计算平均绝对误差或宣称达到厂商标称精度。

## 5. 无效段与跳变

### 连续无效

| 无效段 time_ms | 条数 | 首末无效跨度 | 下一条有效时间 |
| --- | ---: | ---: | ---: |
| 23934–24054 | 2 | 120 ms | 24174 ms |
| 27174–27414 | 3 | 240 ms | 27534 ms |
| 27894–28014 | 2 | 120 ms | 28134 ms |
| 28254–31134 | 25 | 2880 ms | 31254 ms |
| 49614–50934 | 12 | 1320 ms | 日志结束，未见恢复 |

另有 9 次单帧无效，共计 53 条。最长段前一条有效记录为 `28134 ms`，后一条为 `31254 ms`，两次有效更新相隔 **3120 ms**。尾段在采集结束时仍无效，不能写成已自动恢复。

目标离开波束、斜面/吸音目标、安装遮挡、环境反射等可作为复测方向；当前缺少同步操作记录，无法选择其中某一项作为已确定原因。

### 程序标为 VALID 的局部远距离跳变

| 中间样本 time_ms | 前一条 → 当前 → 后一条（cm） |
| ---: | --- |
| 4254 | 34 → 316 → 34 |
| 44454 | 9 → 145 → 11 |
| 46374 | 61 → 189 → 45 |
| 49254 | 73 → 221 → 61 |

以上由[统计脚本](summarize.py)按明确规则筛出，是需要复查的突变，不是已经由真值证明的误测。它们说明“范围内有效”仍不足以作为解除障碍锁存的唯一依据。

## 6. 后续复测与集成注意点

1. 复位并从启动开始保存日志，补全扫描地址、产品 ID、模块版本及配置。
2. 平整纸箱正对探头，在 30、50、100 cm 各固定 30 s，记录真值、有效率、误差分布、跳变和最长无效段；目标移动时加事件标记。
3. 对比脱离车架与装车后的同距离数据，检查支架/车体回波及遮挡；再进行三设备并行采集与电机干扰对照。
4. 正式控制中应同时保留原始读数、有效性、最后有效时间和停车原因。无效/过期数据不能当作远距离；具体停车与恢复规则按既有设计继续实现和验收。

[采购与集成建议](../../新增近场障碍传感器采购建议.md)中的 30 cm 停车、>40 cm 连续 3 帧后解除距离锁存并等待新指令、200 ms 过期判定仍属于候选集成参数，本次日志没有验证这些动作。尤其不能把“连续两次无效”直接当作 200 ms 定时器：本日志周期为 120 ms，连续两次无效在第二次被读到时，距之前有效采样已约 240 ms。若采用 200 ms 限制，应以最后有效时间戳在控制任务中判断，采集任务持续打印也不能刷新有效数据的新鲜度。

台架代码包含等待测量的阻塞延时，不能直接嵌入需要及时响应急停的电机控制循环。本次只归档测试与建议，不修改或宣称已完成正式保护固件。
