ISIP-CART/AutoFollowShoppingCart/design/tests/near-field/VL53L1X测试报告.md

# 双 VL53L1X 红外 ToF 测试报告

整理日期：2026-09-03。原始数据：[双传感器串口日志](data/vl53l1x-dual-serial.txt)。接线与参数见[复测说明](接线与复测说明.md)。

## 1. 结论

两路都已输出连续测距记录，左侧整体稳定，右侧在日志后段出现成组无效结果。可以确认双通道基础测距已运行；尚不能判定右侧模块损坏，也不能据此宣布整车避障或固定距离精度验收通过。

日志共 3314 条，覆盖 `18045–95768 ms`，首末记录跨度 **77.723 s**。没有 `I2C_ERROR` 或 `TIMEOUT` 行，未见采样时间戳回退。这表示本段程序未报告这些通信异常，不等于供电质量、所有总线事务或长期可靠性均已验证。

## 2. 测试条件与证据边界

| 项目 | 当前记录 |
| --- | --- |
| MCU / 模块 | 项目 ESP32；VL53L1X 载板 ×2 |
| 软件通道 | LEFT=0x2A；RIGHT=0x2B，均为 7 位地址 |
| 参考台架配置 | Pololu VL53L1X 1.3.1；Short；33 ms 测量预算；`startContinuous(50)` |
| 参考通信配置 | SDA=21、SCL=22；I²C 100 kHz；串口 115200 |
| 参考 XSHUT | 左 GPIO25、右 GPIO26；逐只释放并改址 |
| 已由用户确认 | 拓展板一组 I²C 接点接有超声波，跳帽选择 3.3 V |
| 日志缺失项 | 启动扫描、初始化行、程序版本/hash、板包版本、真值距离、目标材质、光照、安装角度、电机状态 |

参数来自此前提供的台架示例。日志格式和状态分类与示例一致，但缺少程序版本记录，不能反向证明每项编译/配置与示例完全相同。日志没有超声波距离行，也不能证明超声波在此轮测试中同时采集。

## 3. 字段与有效性

```text
time_ms,side,address,raw_mm,range_status,state
18045,LEFT,0x2A,128,0,NEAR
18049,RIGHT,0x2B,187,0,NEAR
```

`raw_mm` 单位为毫米。只有 `range_status=0` 且距离在 **40–1300 mm** 内时，台架示例才判为可用；其中距离 ≤300 mm 输出 `NEAR`，更远输出 `VALID`。`NEAR` 是有效的近障读数，不是报错，也不是“电机已停车”。40–1300 mm 是该示例的接收范围，不代表本次已验证全量程。

本日志所见状态码按 [Pololu 1.3.1 的 RangeStatus 定义](https://github.com/pololu/vl53l1x-arduino/blob/1.3.1/VL53L1X.h#L1199) 解释，不能套用其他库的原始寄存器编号：

| range_status | 含义 | 本报告处理 |
| ---: | --- | --- |
| 0 | RangeValid，测距有效 | 再检查距离范围 |
| 2 | SignalFail，信号低于内部阈值 | 无效 |
| 4 | OutOfBoundsFail，相位超出允许范围 | 无效 |
| 7 | WrapTargetFail，相位匹配检查失败 | 无效 |

非零状态下，即使 `raw_mm` 看起来像正常距离，也不能当作安全距离。状态码能描述测量失败类型，但不能单独确定失败来自目标移动、反射条件、安装、供电还是模块问题。

## 4. 统计结果

| 指标 | 左侧 LEFT | 右侧 RIGHT |
| --- | ---: | ---: |
| 记录数 | 1657 | 1657 |
| 有效记录（NEAR + VALID） | 1655 | 1593 |
| NEAR | 582 | 1423 |
| VALID | 1073 | 170 |
| INVALID_RANGE | 2 | 64 |
| 有效率 | 99.88% | 96.14% |
| 有效距离最小–最大 | 88–831 mm | 150–1147 mm |
| 相邻采样间隔最小 / 中位 / 最大 | 46 / 47 / 48 ms | 32 / 47 / 63 ms |
| 平均采样间隔 | 46.932 ms | 46.932 ms |
| 按时间戳计算的采样率 | 21.31 Hz | 21.31 Hz |
| 状态码计数 | 0:1655；7:2 | 0:1593；2:39；4:22；7:3 |
| I2C_ERROR / TIMEOUT | 0 / 0 | 0 / 0 |

实测日志周期与参考代码请求的 50 ms 不完全相同，表格按观测值记录。没有传感器内部帧序号，不能进一步证明每条打印都对应独立的新测量，也不能将其当成严格 20 Hz 定时验收。

## 5. 异常片段

### 左侧

仅两条无效记录：

| time_ms | raw_mm | range_status | 下一条有效记录 |
| ---: | ---: | ---: | ---: |
| 32637 | 398 | 7 | 32684 ms |
| 84121 | 420 | 7 | 84169 ms |

两次均在下一条左侧记录恢复。398/420 mm 不计入有效距离样本。

### 右侧

64 条无效记录全部出现在 `82952 ms` 及之后，即附件开始约 **64.907 s** 后。完整连续无效段如下，按时间排序：

| 无效段 time_ms | 条数 | 首末无效跨度 | 下一条有效时间 |
| --- | ---: | ---: | ---: |
| 82952 | 1 | 0 ms | 82999 ms |
| 83281–83891 | 14 | 610 ms | 83939 ms |
| 85252–85534 | 7 | 282 ms | 85580 ms |
| 85628–86191 | 13 | 563 ms | 86238 ms |
| 93843–95110 | 28 | 1267 ms | 95157 ms |
| 95251 | 1 | 0 ms | 95298 ms |

最长段前一条有效样本为 `93796 ms`，后一条为 `95157 ms`，两次有效更新相隔 **1361 ms**。因此“仍在打印串口”不能等同于“仍有新鲜可用距离”。

## 6. 后续复测与判断

1. 两只传感器分别正对平整纸箱，固定在 10、20、30、50、100 cm，各记录 30 s；记录卷尺真值与目标姿态，先确认单只固定目标表现。
2. 保持右侧目标静止，复现后段无效现象；记录移动/移开目标的时间点。当前缺少这些信息，暂不归因。
3. 断电后交换左右模块，再重复同一条件；若异常跟随模块，检查模块及其连接；若留在原位置，检查安装、光照、线缆和目标。一次对照不能替代长期验证。
4. 单只工作与双只同时工作对照，观察无效比例是否变化；再按[接线与复测说明](接线与复测说明.md)验证三设备同时采集和重启改址。

本次结论保留为“左侧基础运行正常；右侧基础运行通过、稳定性待复测”。不将无效帧替换成最大距离，不凭单帧远距离恢复运动；正式保护逻辑及制动效果另行验证。
