ISIP-CART/AutoFollowShoppingCart/design/tests/near-field/接线与复测说明.md

# ESP32 拓展板接线与传感器复测说明

资料核验与整理日期：2026-09-03。适用：项目 ESP32-WROOM-32E、HUA-ESP32-IO-15 V1.0 拓展板资料，以及随货原理图对应的 VL53L1X 载板。其他硬件版本需重新核对。

## 1. 已有超声波时，GPIO 方案是否改变？

**不需要改变 SDA=GPIO21、SCL=GPIO22 的方案，用户确认的 3.3 V 跳帽位置也符合该连接方案。**已有超声波保留在当前 I²C 接口，两只 ToF 从剩余接口并联引出，再各接独立 XSHUT。

依据本地供货资料：

- `print/ESP32/HUA-ESP32-IO-15-V1.0-sch.pdf`，第 1 页。
- `print/ESP32/HUA-ESP32-usemanual-v1.0.pdf`，第 8 页。
- `print/VL53L1X/VL53L1X/原理图.jpg`，载板 P1/P2、稳压、总线和 XSHUT 部分。

这些供货文件位于本地忽略目录，不随本次文档上传。此处记录其核验结论及定位信息；实物朝向、丝印和通断仍以现场测量为准。目前确认来自用户文字说明和资料，尚无完整实物接线照片及电压记录。

## 2. 拓展板接口与电源

原理图 J4/J5 两组 I²C 接口并联到同一总线，并不是两个独立 I²C 控制器。GVS 排针的 GPIO21/22 的 S 端也分别接入同名网络。

| 拓展板接口引脚 | 网络 | 接至模块 |
| ---: | --- | --- |
| 1，SCL | GPIO22 | URM09 C / ToF SCL |
| 2，SDA | GPIO21 | URM09 D / ToF SDA |
| 3，V | 跳线选择的电源 | 各模块 VCC / VIN |
| 4，GND | 地 | 各模块 GND |

J7 为 1=5 V、2=V、3=3.3 V；连接 2–3 后，I²C 接口及 GVS 的 V 排共用 3.3 V。跳帽选择的是外设供电，不会把 ESP32 GPIO 改成可承受 5 V 的信号脚。

随货 ToF 原理图的 P1 为 **1=VIN、2=SDA、3=SCL、4=GND**，与拓展板四针顺序不同。必须逐个按信号对应连接，不能认为四芯直通线一定匹配。

该 ToF 板外侧 SDA/SCL 经 4.7 kΩ 上拉到 VIN；即使载板带电平转换，VIN=5 V 时 ESP32 一侧总线也可能被拉到 5 V。本连接方案两块 ToF 的 VIN 均使用 3.3 V。XSHUT 经板载 10 kΩ 上拉到 VDD，不与 SDA/SCL 共用电平转换路径；控制时输出低电平复位，再改为高阻输入释放，不启用内部上拉。

URM09 SEN0304 官方供电范围为 3.3–5.5 V，D 为 SDA、C 为 SCL；本方案统一用 3.3 V。[DFRobot 接口与规格](https://wiki.dfrobot.com/sen0304)

## 3. 三模块接线表

| ESP32 / 拓展板 | URM09（已有） | 左 ToF | 右 ToF |
| --- | --- | --- | --- |
| V=3.3 V | VCC | VIN | VIN |
| GND | GND | GND | GND |
| GPIO21 / SDA | D/SDA | SDA | SDA |
| GPIO22 / SCL | C/SCL | SCL | SCL |
| GPIO25 的 S 端 | — | XSHUT | — |
| GPIO26 的 S 端 | — | — | XSHUT |
| 无连接 | — | GPIO1 留空 | GPIO1 留空 |

ToF 模块的 GPIO1 是其自身的中断引脚名称，本次轮询测距无需连接到 ESP32 GPIO1。GPIO25/26 应确认未被其他设备使用。

从剩余 I²C 接口用分线端子或面包板将四条同名信号分别并到两只 ToF；也可利用 GVS 的 GPIO21/22 S 端取同一总线，但电源和地仍须正确共接。现有电机 UART 使用 GPIO16/17，本方案不占用这两个信号脚。

先断开电机主电源，USB 给 ESP32 供电，断电改线；先用短线，检查传感器端供电及 SDA/SCL 空闲高电平。两块 ToF 的 4.7 kΩ 上拉并联后约 2.35 kΩ，还需考虑超声波及其他总线设备的上拉，不能仅凭单板电阻推断整个总线的实际负载。

## 4. 上电地址管理

所有地址在 Arduino Wire 中按 **7 位地址**填写。

1. 两只 ToF 的 XSHUT 同时拉低，使其处于复位。
2. 释放左 XSHUT，在默认地址 0x29 初始化左模块，再改为 0x2A。
3. 保持左模块运行，释放右 XSHUT，在 0x29 初始化右模块，再改为 0x2B。
4. 完成后扫描应见 0x2A、0x2B；已有 URM09 未改默认地址且正常在线时，还应见 0x11。
5. 每次冷启动/传感器复位后重新执行该过程；两只 ToF 不可同时以默认地址完成独立配置。

启动、改址及量程模式 API 参考 [Pololu VL53L1X 库](https://github.com/pololu/vl53l1x-arduino/tree/1.3.1)。本次 ToF 附件没有初始化扫描行，上述三地址组合是复测预期，不是现有附件中的已验证输出。

## 5. 台架配置与复测顺序

参考环境：Arduino IDE，ESP32 Dev Module，串口 115200，`Wire.begin(21, 22, 100000)`。下次需在日志头补充 ESP32 板包版本、实际板型、测试代码版本和传感器版本。

| 模块 | 此前台架示例参数 | 当前实测节奏 |
| --- | --- | --- |
| 双 ToF | Pololu 1.3.1；Short；33 ms 测量预算；连续测量请求 50 ms；读超时 200 ms；Wire 超时 25 ms | 每路平均 46.932 ms，约 21.31 Hz |
| URM09 | 被动触发；测量等待 100 ms；末尾延时 20 ms；2–500 cm 程序范围检查 | 每条 120 ms，约 8.33 Hz |

两套都是诊断示例，均未由本次文档工作重新烧录或现场复跑；当前附件没有可对应的固件版本标识。现有日志的结论见两份测试报告。

建议按以下顺序补齐记录，每步都保存从启动开始的串口数据：

| 次序 | 操作 | 记录内容 / 通过依据 |
| ---: | --- | --- |
| 1 | 核对电源、接头和模块版本 | 丝印照片、3.3 V 跳帽、模块端电压；数值符合实际模块规格 |
| 2 | URM09 单独测试 | 扫描 0x11、产品 ID/版本及配置；30/50/100 cm 固定纸箱各 30 s |
| 3 | 左右 ToF 分别测试 | 默认地址/改址过程；10/20/30/50/100 cm 各 30 s；统计质量状态与距离误差 |
| 4 | 双 ToF 同时测试 | 两地址持续在线；逐个遮挡并记录时间，以验证软件标签和物理左右一致 |
| 5 | 三模块同时采集 | 一份日志包含三路状态、距离与各自更新时间；仅扫描到地址不足以证明并行测距 |
| 6 | 连续运行至少 10 min | 分别记录有效率、最大更新间隔、重启/断线、连续无效段；这是待执行计划 |
| 7 | 控制与电机联调 | 先架空车轮，再低速落地；记录障碍、过期/无效、停车原因及实测停车距离 |

固定目标阶段至少报告有效率、误差中位数/P95、最大绝对误差和最长无效段。通过容差应在复测前按项目近场需求明确并记录，不能从本次无真值日志反推“已达精度要求”。

重复异常时采用一次只改变一个条件的对照：模块互换、目标位置固定、单只/双只、装车前/后、电机停转/运转。测试日志中写清条件切换时间，避免把正常移开目标造成的无回波当作硬件故障。

## 6. 控制集成边界

三路应各自保存距离、有效性和最后有效采样时间，统一毫米/厘米换算；无效数据不可替换为最大距离，也不能由另一路正常数据掩盖关键方向失效。台架日志只证明采集情况，不证明过滤、超时停车和恢复锁存已经实现。

既有候选阈值与职责见[近场传感器采购与集成建议](../../新增近场障碍传感器采购建议.md)。阈值最终需结合当前速度、采样/控制延迟、车体外廓和实测制动距离验证。本次不改写上位机总计划或目标丢失策略，也不将传感器读数直接等同于转向许可。
