ISIP-CART/AutoFollowShoppingCart/design/tests/near-field/README.md

# 近场传感器台架测试记录

整理日期：2026-09-03。对象：ESP32、URM09-I²C（SEN0304）×1、VL53L1X ×2。

本目录归档组员提供的实际串口日志、接线核验依据和分析结果。现阶段已取得三只传感器分别进行台架测距的证据；左右 ToF 在同一份日志中运行。尚无三路同时采集、固定距离标定或传感器触发整车制动的完整记录。

## 1. 当前结论

| 对象 | 记录数 | 程序判为有效 | 有效率 | 本次判断 |
| --- | ---: | ---: | ---: | --- |
| 左 VL53L1X，0x2A | 1657 | 1655 | 99.88% | 基础测距运行正常，2 次单帧无效后恢复 |
| 右 VL53L1X，0x2B | 1657 | 1593 | 96.14% | 基础测距已运行，末段连续无效需要复测 |
| URM09 超声波 | 411 | 358 | 87.10% | 基础测距已运行，有连续无效和局部远距离跳变 |

两种程序的有效值定义不同，不能直接用上述比例给传感器性能排名。ToF 检查质量状态和距离范围；超声波日志的 `VALID` 只表示原始距离在程序允许范围内。两份日志都缺少卷尺真值、目标材质和操作时间标记，不能据此计算准确率、绝对误差或漏检率。

## 2. 阅读入口

- [ESP32 拓展板接线与复测说明](接线与复测说明.md)：已有超声波时的总线连接、3.3 V 跳帽、XSHUT、参考参数和后续复测步骤。
- [双 VL53L1X 红外 ToF 测试报告](VL53L1X测试报告.md)：左右统计、状态码、异常区间和结论边界。
- [URM09 超声波测试报告](URM09测试报告.md)：连续无效段、距离跳变、采样时序和待补证据。
- [近场传感器采购与集成建议](../../新增近场障碍传感器采购建议.md)：既有职责划分与候选安全阈值。

## 3. 数据来源与保存规则

| 归档文件 | 来源 | SHA-256 |
| --- | --- | --- |
| [vl53l1x-dual-serial.txt](data/vl53l1x-dual-serial.txt) | 2026-09-03 会话中提供的红外串口附件 | `7687651a402ae2508414a0f3875ebf588eec723e40995324db30809a9708b081` |
| [urm09-serial.txt](data/urm09-serial.txt) | 2026-09-02 会话提供、2026-09-03 再次确认的超声波串口附件 | `c8743bb49a77b7ae0e7dce17328255bf0be7907af625d6a86d957a4663e05373` |

日期为会话提交日期，日志没有墙上时钟时间，不能当作精确测试起止日期。文件按附件原始字节保存，不删异常值、不补启动信息。超声波第一行包含一段不可读前缀；统计脚本仅在解析第一行时跳过此前缀，保留后面的第一条采样。该前缀成因未知。

日志中 `time_ms` 是设备侧毫秒计时值，不是从附件首行归零的时间。两个附件来自不同测试，不能对齐时间戳作三传感器同步分析。`LEFT/RIGHT` 是程序通道名，尚无实物照片或遮挡标记证明与车体左右安装位置完全对应。

### 复算

在主仓库根目录运行 Python 3，无第三方依赖：

```bash
python design/tests/near-field/summarize.py
```

[统计脚本](summarize.py) 检查每条记录格式、通道地址、状态分类和单通道时间戳递增，输出记录数、有效率、距离极值、采样间隔、状态码计数、连续无效区间和文件摘要。无法识别的非空行会报错，不会静默丢弃。

统计口径：

- 有效率 = 程序有效记录数 / 该通道全部记录数；分母包含无效记录。
- 有效距离范围仅统计有效记录，不使用无效记录中的原始距离。
- 单路采样率 = 1000 / 该路相邻时间戳差的平均值；ToF 按左右分组，不能把两路交替打印间隔当成单路周期。
- 连续无效段按单路记录顺序定义；段内跨度 = 最后无效时间 − 首个无效时间。单帧跨度为 0 ms，不代表无需等待恢复。
- 脚本同时输出前后有效样本时间；这两个有效样本之间的间隔更适合描述可用数据中断。尾部没有恢复样本时保持空值。
- 超声波“局部远距离跳变”筛选：连续三条均为 `VALID`，中间距离大于 100 cm 且大于前后均值的 2.5 倍。这只是复查线索，不是误测真值或已部署滤波器。

## 4. 验收状态

| 项目 | 状态 | 尚需补充 |
| --- | --- | --- |
| 资料中的拓展板接口与引脚映射 | 已核验 | 实物丝印、通断和电压照片/记录 |
| 单超声波连续采集 | 已取得日志 | 启动扫描、产品 ID、固定目标复测 |
| 双 ToF 连续采集 | 已取得日志 | 启动改址过程、右侧异常复测、物理左右对应 |
| 三设备共用总线并同时采集 | 未验证 | 0x11、0x2A、0x2B 扫描及三路同时输出 |
| 固定距离精度与稳定性 | 未验收 | 真值、姿态、环境及分段日志 |
| 电机干扰与长时间运行 | 未验证 | 电机停转/运转对照及连续运行日志 |
| 障碍触发停车、失效保护和恢复 | 未验证 | 三路状态、停车原因、控制指令和实际动作证据 |

本次归档不改变上位机跟随/避障架构，不把台架程序的 `NEAR` 输出视为制动命令。传感器接入后的控制策略需按项目总计划和实车验证继续收口；目标丢失的 `motion_stop → 短时搜索 → 失败后 hard STOP` 口径保持不变。
