ISIP-CART/AutoFollowShoppingCart/(commit log)

2026-07-01 img: 加入展示用图片
2026-07-02 Update git workflow guide and motor parameter docs
2026-07-02 img: 加入WBS图片
2026-07-02 Update OpenBot submodule: two-stage target init and target memory
2026-07-05 Add shared ReID research workspace and update planning docs
    [.isort.cfg]
2026-07-06 移除大文件并更新 .gitignore
2026-07-08 Update OpenBot pointer for ReID evidence flow
2026-07-08 Add ESP32 chassis control interface
2026-07-09 Add depth passage scoring test
    [round1_manual_labels.csv]
2026-07-09 Add depth traversability scoring prototype
    [round1_traversability_labels.csv]
2026-07-09 Update weekly WBS and gantt charts
    [autofollowshoppingcart-day-gantt.xlsx]
2026-07-10 Refine depth traversability motion model
    [round1_traversability_labels.csv, round2_motion_labels.csv]
2026-07-10 Add near-field sensor procurement guide
2026-07-12 Add ESP32 OpenBot BLE safety remote firmware
2026-07-12 Harden ESP32 BLE remote firmware
2026-07-12 Tune ESP32 AT8236 firmware controls
2026-07-12 Add ESP32 USB control diagnostics
2026-07-12 Track latest OpenBot master
2026-07-12 Add motor calibration and reversal guard
    [esp32_at8236_calibration.ino, esp32_at8236_openbot_ble.ino]
2026-07-13 Harden BLE wheel reversal settling
    [esp32_at8236_calibration.ino, esp32_at8236_openbot_ble.ino]
2026-09-01 Add velocity-controlled BLE cart firmware
2026-09-01 Document continuous steering research
2026-09-01 Document velocity BLE firmware baseline
2026-09-02 Raise BLE cart velocity ceiling
2026-09-02 Document manual speed calibration
2026-09-02 Add velocity validation firmware and test workbook
2026-09-03 Document near-field sensor bench results and wiring
2026-09-04 Reset range filter after stale sensor recovery
    [esp32_at8236_velocity_ble.ino, test_firmware_contract.py]
2026-09-04 Switch range sensors to log-only mode
2026-09-05 Document steering and BLE recovery fixes and update OpenBot
2026-09-05 Recover from transient BLE driver faults
2026-09-05 Avoid false c14 overspeed latches
    [esp32_at8236_velocity_ble.ino, test_firmware_contract.py]
2026-09-05 Prevent false overspeed faults during turns
    [esp32_at8236_velocity_ble.ino, test_firmware_contract.py]
2026-09-10 Update OpenBot for ShoppingCart release flow
2026-09-10 Recover stalled VL53L1X sensors at runtime
    [esp32_at8236_velocity_ble.ino, test_firmware_contract.py]
